robertgregor/private/Hardware/Documents/protocol.txt

USB stick

AT+c=ch<ENTER> - ch - channel number 1 - 83
AT+p=ABCDE<ENTER> - ABCDE - password exactly 5 characters
AT+a=nnn<ENTER> - add new device device id nnn = 1 - 255
AT+ddd=Cmd - specific device command ddd = device Id, Cmd = command

Light/Alarm controller

ala - alarm On In this mode the senzor will notify the Computer one time about the intrusion
ald - alarm deactivation
alce=nnn - alarm configuration enter alarm timeout nnn = 0 to 255 seconds
alcl=nnn - alarm configuration leave alarm timeout nnn = 0 to 255 seconds

l1o - light 1 on
l1of - light 1 on and off after timeout period
l1f - light 1 off
l1co - configure light 1 to swith on when applied power
l1cf - configure light 1 to stay off when applied power
l1cd - configure light 1 to switch on when movement detected
l1cc - cancel light 1 to switch on when movement detected
l1ct=nnn - configure light 1 timeout nnn = 0 to 255 minutes (0 means forewer) minutes
pn - check weather the device is up and runing (ping command)
sa - return status 1|a|Alarm|sensor|alenter|alleave
	Alarm 0 disabled, 1 enabled, 2 activated, 3 leave timeout running, 4 enter timeout running
	sensor - 0 nothing detected, 1 detected
	alenter - enter alarm timeout in seconds
	alleave - leave alarm timeout in seconds
sc - return status 1|c|light|power|onWhenMovement|configuredTimeout|currentTimeout
	light 0 off, 1 on
	power 0 on when applied power, 1 stay off when applied power
	onWhenMovement 1 - on when movement detected 0 no action
	configuredTimeout - no of minutes, when l1 will go off, 0 forewer
	currentTimeout - current light 1 timeout in minutes, 0 - never switch off

Temperature sensor

pn - check weather the device is up and runing (ping command)
s - return status 2|temperature|battery|frequency
	temperature format - always sign, 2 decimals degree celsius, dot, 2 decimals, e.g +23.32 or -02.32 or +02.20
	battery voltage e.g. 2.9 or 3.0
	frequency - frequency in seconds to send status. Longer value, longer battery life
m=nnn - set the frequency and put to the sleep mode. 1 means 10 seconds, 255 means 2550 seconds. Needs to be set to put the device to sleep mode!!!
	If not set, or set to 0, then no sleep - usefull for testing, but consume lot of power and batery will be quicly empty.

If in sleep mode, the command should be send within 2 seconds, after the status is send. Othervise the system is in sleep mode
and radio is off.

Simple switch

pn - check weather the device is up and runing (ping command)
l1o - light 1 on
l1of - light 1 on and off after timeout period
l1f - light 1 off
l1co - configure light 1 to swith on when applied power
l1cf - configure light 1 to stay off when applied power
l1ct=nnn - configure light 1 timeout nnn = 0 to 255 minutes (0 means forewer) minutes
s1 - return status 3|light|power|configuredTimeout|currentTimeout
	light 0 off, 1 on
	power 0 on when applied power, 1 stay off when applied power	
	configuredTimeout - no of minutes, when l1 will go off, 0 forewer
	currentTimeout - current light 1 timeout in minutes, 0 - never switch off

6x Simple switch

pn - check weather the device is up and runing (ping command)
lxo - light 1 on
lxof - light 1 on and off after timeout period
lxf - light 1 off
lxco - configure light 1 to swith on when applied power
lxcf - configure light 1 to stay off when applied power
lxct=nnn - configure light 1 timeout nnn = 0 to 255 minutes (0 means forewer) minutes
sx - return status 3|light|power|configuredTimeout|currentTimeout
	light 0 off, 1 on
	power 0 on when applied power, 1 stay off when applied power	
	configuredTimeout - no of minutes, when l1 will go off, 0 forewer
	currentTimeout - current light 1 timeout in minutes, 0 - never switch off

x = number 1 - 6

Heating header

pn - check weather the device is up and runing (ping command)
ad - adaptation of the header. Each valve has different ranges of the open / close borders. This command will measure the time between the close / open and
    adapt the header to the valve. It needs to be run at the begining and then each two weeks.
s - return status 4|temperature|battery|frequency|expected temperature|openAngle
	temperature format - 3 decimals degree celsius, e.g 233 = 23.3 or -23 = -23 or 022 = 2.2
	battery voltage e.g. 29 = 2.9 or 30 3.0. Below 2.8, the hardware starts to work not correctly.
	frequency - frequency in seconds to send status. Longer value, longer battery life
	expected temperature - the value set with command t: 23.5 celsius = 47, or 17 celsius = 34
	openAngle - Current open angle in % 100 - means close, 0 means fully open
m=nnn - set the frequency and put to the sleep mode. 1 means 10 seconds, 255 means 2550 seconds. Needs to be set to put the device to sleep mode!!!
	If not set, or set to 0, then no sleep - usefull for testing and configuration, but consume lot of power and batery will be quicly empty.
t=nnn - Expected temperature - if set, the header is running in self managed mode - each frequency period checks the current temperature, and if it is lower, open the
    valve and then sleep another period. The value is temperature * 2, it means, that 23.5 celsius = 47, or 17 celsius = 34.
    If it is set to 0, then valve is operated manually: each frequency period the valve send status, then you have 2 seconds to send l command to set the open angle of the valve.
l=nnn Set manually the valve to expected position allowed range is 100 closed, 0 fully open.

    Asynchronous messages: As - adaptation start, Ae - adaptation end, l|nnn after the valve is moved to correct position, the actual current position is sent. 
        
    Quick startup:
    1. Insert battery
    2. Test the communication AT+0=pn<ENTER>
    3. Assign the device ID: AT+a=9<ENTER>  Id is 9. Adaptation start. As is printed after while Ae is printed with the Valve position 100 - fully closed
    
    Self managed mode                                                                       Manual mode
    4. AT+9=t=45<ENTER> set temperature in room to 22,5 celsius                             AT+9=t=0<ENTER> manual mode, temperature is 0
    5. AT+9=m=60<ENTER>    sleep 10 minutes                                                   AT+9=m=60<ENTER>    sleep 10 minutes
    After 10 minutes the status is sent, you have to answer after the valve is set l|100    After 10 minutes the status is sent, sent back the new position
    6. AT+9=t=34<ENTER> Lower the temperature for the night                                   AT+9=l=50<ENTER> Opened 50 percent.

Blinds controller

pn - check weather the device is up and runing (ping command)
s - return status 5|down|up|timeout value|current opening
	down - 1 if currently moving down
	up - 1 if currently moving up
	timeout value - number of configured timeout in sec. This value is the 100 % time to open the blinds
	current opening - Blinds opening in %. 0 means fully open, 100 means fully closed. In manual mode always 0.

Position managed mode:

bt=nnn - configure number of seconds, when the blind is moving fully from open position to closed position.
bu - blinds up moving to fully open position
bd - blinds down moving to fully closed position
bs - blinds stop stop movements
bm=nnn - Move to the nnn position. nnn is the percentage between open and close. 0 - fully open, 100 - fully closed

Asynchronous messages: l|nnn percentage of opening.

Manual mode:

u - start to move up
d - start to move down
e - stop to move

3x Blinds controller

pn - check weather the device is up and runing (ping command)
sx - return status 5|down|up|timeout value|current opening
	down - 1 if currently moving down
	up - 1 if currently moving up
	timeout value - number of configured timeout in sec. This value is the 100 % time to open the blinds
	current opening - Blinds opening in %. 0 means fully open, 100 means fully closed. In manual mode always 0.

Position managed mode:

bxt=nnn - configure number of seconds, when the blind is moving fully from open position to closed position.
bxu - blinds up moving to fully open position
bxd - blinds down moving to fully closed position
bxs - blinds stop stop movements
bxm=nnn - Move to the nnn position. nnn is the percentage between open and close. 0 - fully open, 100 - fully closed

Asynchronous messages: l|nnn|X percentage of opening: nnn

Manual mode:

ux - start to move up
dx - start to move down
ex - stop to move

x = number 1 - 3

Battery thermostat

pn - check weather the device is up and runing (ping command)
o - Switch on the relay
f - Switch off the relay
s - return status 7|temperature|battery|frequency|expected temperature|relay|treshold
	temperature format - 3 decimals degree celsius, e.g 233 = 23.3 or -23 = -23 or 022 = 2.2
	battery voltage e.g. 29 = 2.9 or 30 3.0. Below 2.8, the hardware starts to work not correctly.
	frequency - frequency in seconds to send status. Longer value, longer battery life
	expected temperature - the value set with command t: 23.5 celsius = 47, or 17 celsius = 34
	relay - Current state of the relay 0 - off, 1 on
	treshold - Current treshold 0 - 9
m=nnn - set the frequency and put to the sleep mode. 1 means 10 seconds, 255 means 2550 seconds. Needs to be set to put the device to sleep mode!!!
	If not set, or set to 0, then no sleep - usefull for testing and configuration, but consume lot of power and batery will be quicly empty.
t=nnn - Expected temperature - if set, the header is running in self managed mode - each frequency period checks the current temperature, and if it is lower, open the
    valve and then sleep another period. The value is temperature * 2, it means, that 23.5 celsius = 47, or 17 celsius = 34.
    If it is set to 0, then relay is operated manually: each frequency period the relay send status, then you have 2 seconds to send l command to set the open angle of the valve.
r=n  -  Treshhold 0 - 9. For the self managed mode, the treshhold could be set. It means that relay will go off when currentTemperature + treshold / 10 > expected temperature and will
	go on, when currentTemperature - treshold / 10 < expected temperature

    Quick startup:
    1. Insert battery
    2. Test the communication AT+0=pn<ENTER>
    3. Assign the device ID: AT+a=9<ENTER>  Id is 9.
    
    Self managed mode                                                                       Manual mode
    4. AT+9=t=45<ENTER> set temperature in room to 22,5 celsius
    5. AT+9=r=5<ENTER> set treshold to 0,5 degree celsius                                   AT+9=t=0<ENTER> manual mode, temperature is 0
    6. AT+9=m=60<ENTER>    sleep 10 minutes                                                 AT+9=m=60<ENTER>    sleep 10 minutes
    After 10 minutes the status is sent, you have to answer till 2 seconds		    After 10 minutes the status is sent, sent back the position of the relay
    7. AT+9=t=34<ENTER> Lower the temperature for the night                                 AT+9=o<ENTER> Swith relay on

Manual mode:
o - start to move up
f - start to move down

Thermostat

pn - check weather the device is up and runing (ping command)
o - Switch on the relay
f - Switch off the relay
s - return status 6|temperature|frequency|expected temperature|relay|treshold|manualControl
	temperature format - 3 decimals degree celsius, e.g 233 = 23.3 or -23 = -23 or 022 = 2.2
	frequency - frequency in seconds to send status. Longer value, longer battery life
	expected temperature - the value set with command t: 23.5 celsius = 47, or 17 celsius = 34
	relay - Current state of the relay 0 - off, 1 on
	treshold - Current treshold 0 - 9
	manualControl - in this mode, the relay is operated only with commands x and y it means on and off. Expected temperature doesnt have any effect.
m=nnn - set the frequency of the notifications and relay changes. 1 means 10 seconds, 255 means 2550 seconds.
	If not set, or set to 0, then no relay changes - Manual mode
t=nnn - Expected temperature - if set, the header is running in self managed mode - each frequency period checks            the current temperature, and if it is lower, switch on the
    	relay. The value is temperature * 2, it means, that 23.5 celsius = 47, or 17 celsius = 34.
	If it is set to 0, then relay is operated manually.
r=n  -  Threshold 0 - 9. For the self managed mode, the treshhold could be set. It means that relay will go off             when currentTemperature + treshold / 10 > expected temperature and will
	go on, when currentTemperature - threshold / 10 < expected temperature
x - Set manual control on
y - Set manual control off
        
    Quick startup:
    1. Put the power
    2. Test the communication AT+0=pn<ENTER>
    3. Assign the device ID: AT+a=9<ENTER>  Id is 9.
    
    Self managed mode                                                                       Manual mode
    4. AT+9=t=45<ENTER> set temperature in room to 22,5 celsius
    5. AT+9=r=5<ENTER> set treshold to 0,5 degree celsius                                   AT+9=t=0<ENTER> manual mode, temperature is 0
    6. AT+9=m=60<ENTER>    wait 10 minutes                                                  AT+9=m=60<ENTER>    sleep 10 minutes
    After 10 minutes the status is sent	again						    After 10 minutes the status is sent
    7. AT+9=t=34<ENTER> Lower the temperature for the night                                 AT+9=o<ENTER> Swith relay on if necessary

raspberry setup:

Edit /boot/cmdline.txt

From:
dwc_otg.lpm_enable=0 rpitestmode=1 console=ttyAMA0,115200 kgdboc=ttyAMA0,115200 console=tty1 root=/dev/mmcblk0p2 rootfstype=ext4 rootwait
to:
dwc_otg.lpm_enable=0 rpitestmode=1 console=tty1 root=/dev/mmcblk0p2 rootfstype=ext4 rootwait

Edit /etc/innitab 
comment out:
2:23:respawn:/sbin/getty -L ttyAMA0 115200 vt100
