robertgregor/private/DOCS/vizitky/vizitka_generic.PDF

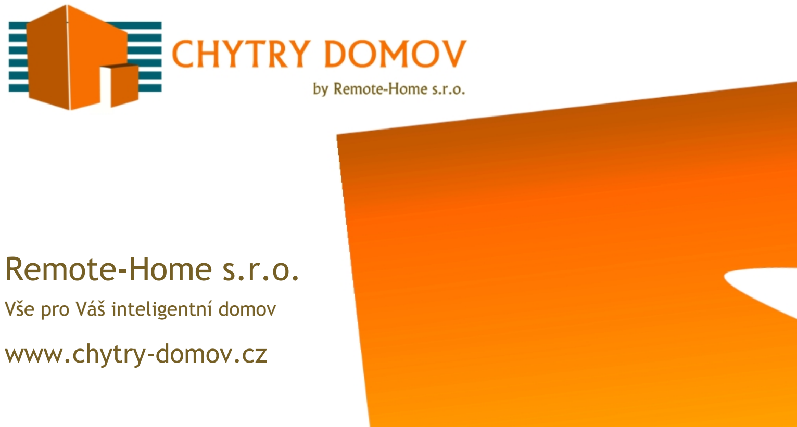
[picture p1: page 1]

Remote-Home s.r.o.

Vše pro Váš inteligentní domov

## www.chytry-domov.cz
