robertgregor/private/DOCS/vizitky/vizitka_dr.pdf

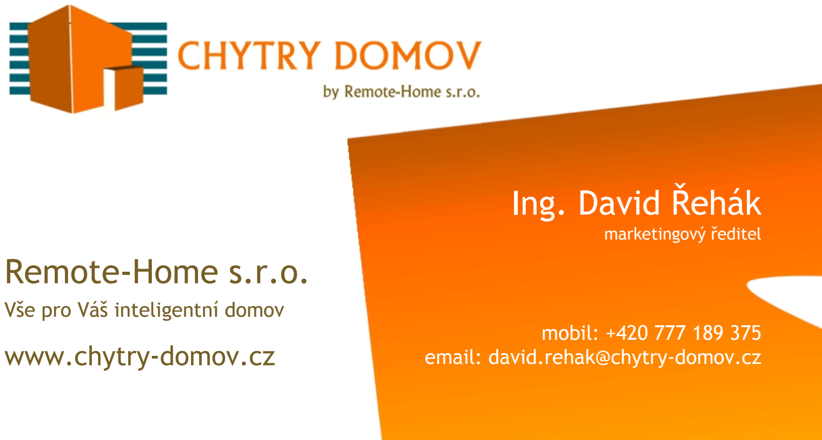
[picture p2: page 1]

Remote-Home s.r.o.

Vše pro Váš inteligentní domov

## www.chytry-domov.cz

## Ing. David Řehák

marketingový ředitel

mobil: +420 777 189 375
email: david.rehak@chytry-domov.cz
