robertgregor/private/DOCS/vizitky/vizitka_rg.PDF

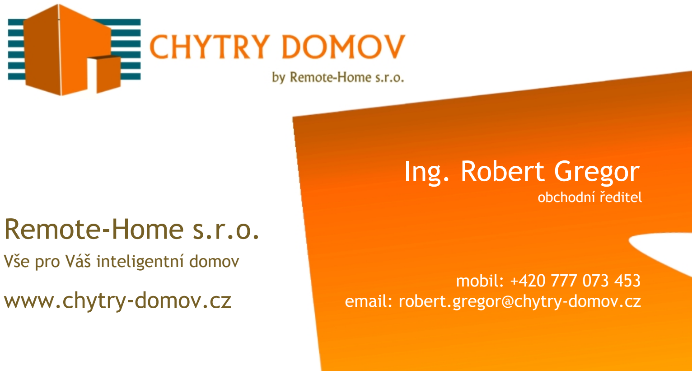
[picture p3: page 1]

Remote-Home s.r.o.

Vše pro Váš inteligentní domov

## www.chytry-domov.cz

## Ing. Robert Gregor obchodní ředitel

mobil: +420 777 073 453
email: robert.gregor@chytry-domov.cz
