robertgregor/private/DOCS/vizitky/vizitka_zh.PDF

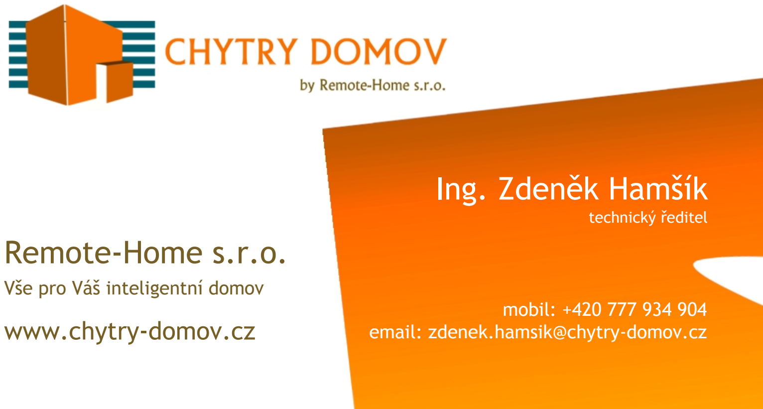
[picture p4: page 1]

Remote-Home s.r.o.

Vše pro Váš inteligentní domov

## www.chytry-domov.cz

## Ing. Zdeněk Hamšík

technický ředitel

mobil: +420 777 934 904
email: zdenek.hamsik@chytry-domov.cz
