robertgregor/private/Hardware/SchemasBoard/miniSpinac.brd

## EAGLE design Hardware/SchemasBoard/miniSpinac.brd (2014-12-24)

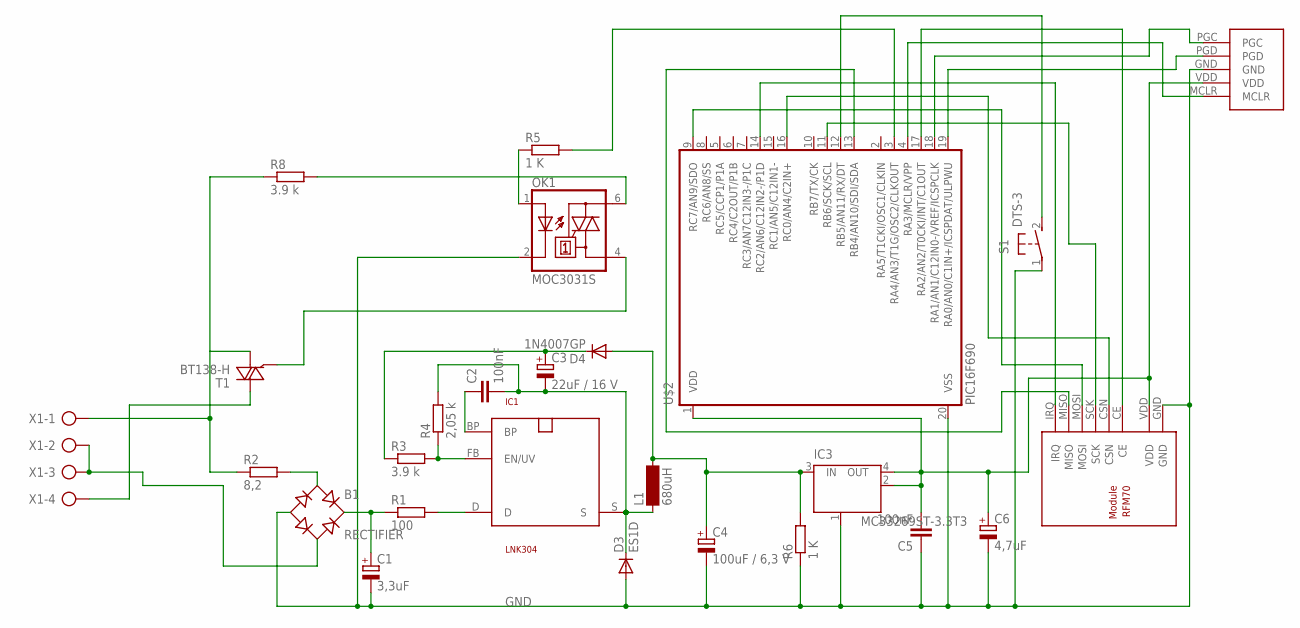
[picture p5: schematic miniSpinac.sch]

Parts:
B1: RECTIFIER; TO-269AA
C1: 3,3uF; E5-10,5
C2, C5: 100nF; C2012
C3: 22uF / 16 V; SMC_C
C4: 100uF / 6,3 V; E2,5-5
C6: 4,7uF; SMC_A
D3: ES1D; DO214AC
D4: 1N4007GP; DO214AA
IC1: LNK304; SO-8C
IC3: MC33269ST-3.3T3; SOT223
L1: 680uH; BS11
OK1: MOC3031S; DIL6-SMD
R1: 100; R2512W
R2: 8,2; 0411/12
R3, R8: 3.9 k; M2012
R4: 2,05 k; M2012
R5, R6: 1 K; M2012
S1: DTS-3
T1: BT138-H; TO220BH
U$1: RFM70
U$2: PIC16F690; SSOP20
U$3: PROGRAMMINGHEADERDIP; PROGHEADER
X1: AK500/4

Connections:
GND: B1.-, C1.-, C4.-, C5.1, C6.-, D3.A, IC3.1 (GND/ADJ), OK1.2 (C), R6.1, S1.1, U$1.GND, U$2.20 (VSS), U$3.GND
unnamed: IC1.D, R1.2
unnamed: B1.+, C1.+, R1.1
unnamed: B1.AC1, R2.2
unnamed: B1.AC2, X1.2, X1.3
unnamed: S1.2, U$2.12 (RB5/AN11/RX/DT)
unnamed: T1.T2 (A2), X1.4
unnamed: OK1.1 (A), R5.1
unnamed: OK1.4 (A1), T1.G
unnamed: C3.+, D4.C, R3.1
unnamed: C2.1, IC1.BP
unnamed: IC1.FB (EN/UV), R3.2, R4.1
unnamed: U$1.MISO, U$2.13 (RB4/AN10/SDI/SDA)
unnamed: C2.2, C3.-, D3.C, IC1.S, L1.1, R4.2
unnamed: OK1.6 (A2), R8.2
unnamed: U$1.CE, U$2.17 (RA2/AN2/T0CKI/INT/C1OUT)
unnamed: U$2.19 (RA0/AN0/C1IN+/ICSPDAT/ULPWU), U$3.PGD
unnamed: U$2.18 (RA1/AN1/C12IN0-/VREF/ICSPCLK), U$3.PGC
unnamed: U$1.CSN, U$2.16 (RC0/AN4/C2IN+)
unnamed: U$1.IRQ, U$2.14 (RC2/AN6/C12IN2-/P1D)
unnamed: U$1.SCK, U$2.11 (RB6/SCK/SCL)
unnamed: U$1.MOSI, U$2.9 (RC7/AN9/SDO)
unnamed: U$2.4 (RA3/MCLR/VPP), U$3.MCLR
unnamed: C4.+, D4.A, IC3.3 (IN), L1.2, R6.2
unnamed: C5.2, C6.+, IC3.2 (OUT), IC3.4 (OUT), U$1.VDD, U$2.1 (VDD), U$3.VDD
unnamed: R5.2, U$2.3 (RA4/AN3/T1G/OSC2/CLKOUT)
unnamed: R2.1, R8.1, T1.T1 (A1), X1.1

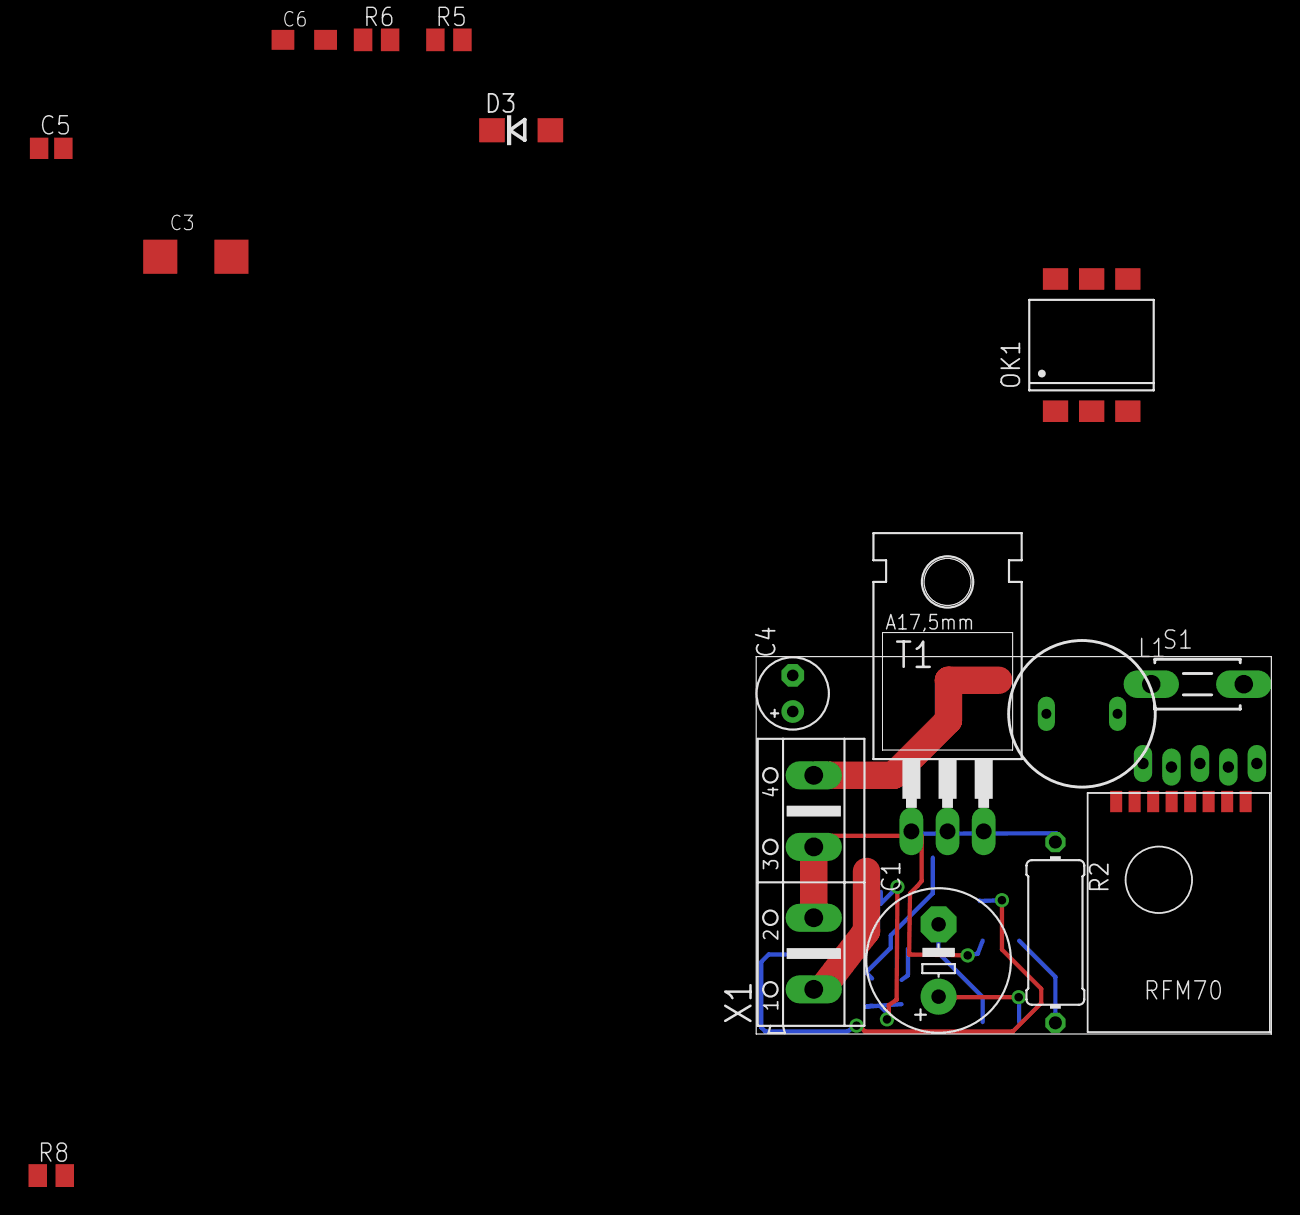
[picture p6: board miniSpinac.brd from above]

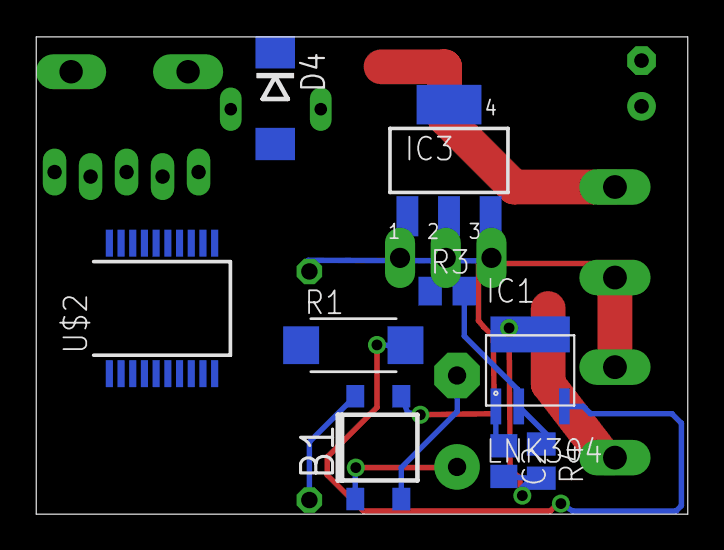
[picture p7: board miniSpinac.brd from below]

Board: 2 copper layers, 36.2 x 26.5 mm, 26 parts (9 on the bottom side), 27 nets.
