robertgregor/private/Hardware/Ardunio/eagle/Transceiver.brd

## EAGLE design Hardware/Ardunio/eagle/Transceiver.brd (2014-12-24)

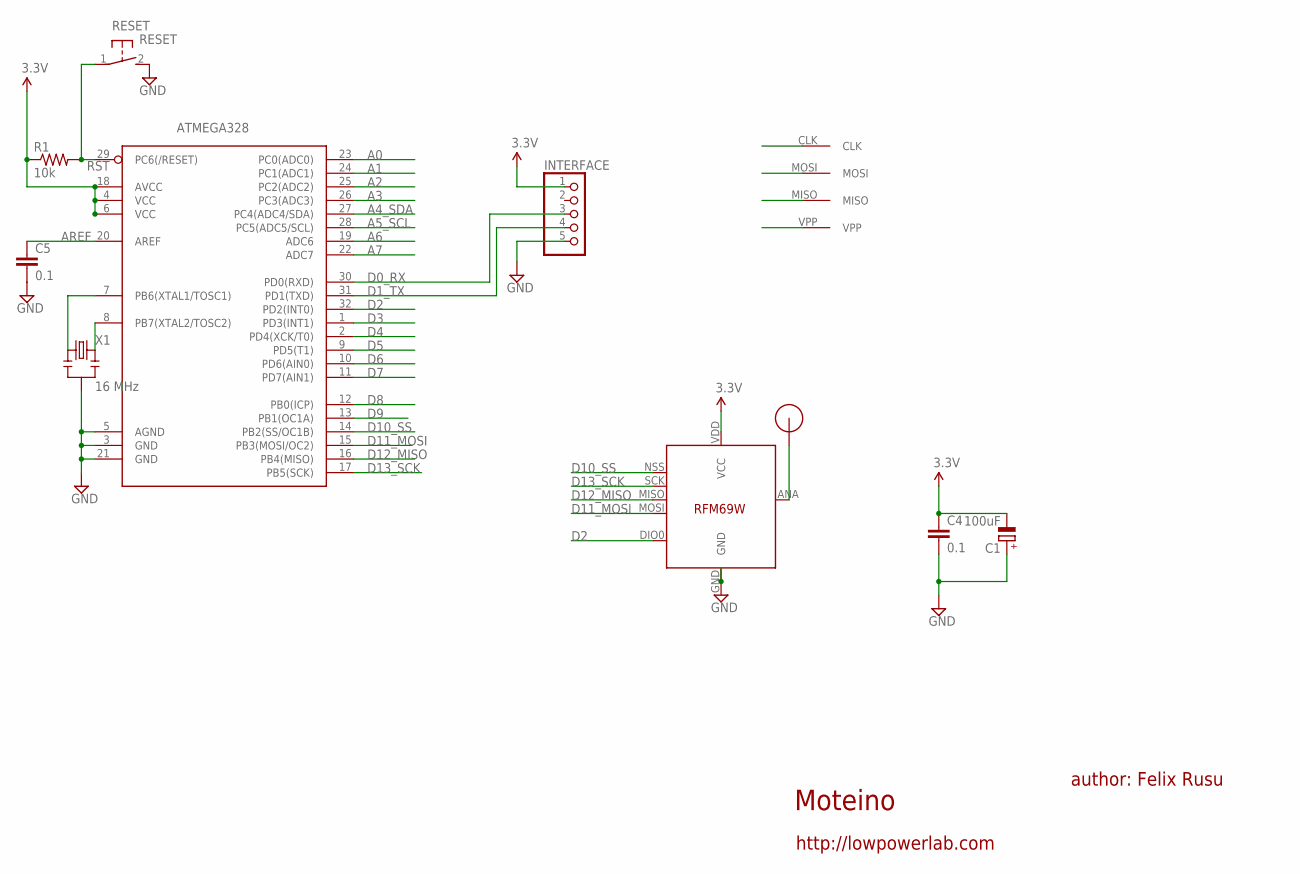
[picture p8: schematic Transceiver.sch]

Parts:
ATMEGA328: ATMega-328; TQFP32-08
C1: 100uF; SMC_B
C4, C5: 0.1; 0603-CAP
INTERFACE: PINHD-1X5/90; 1X05/90
R1: 10k; 0603-RES
RESET: RESET; DTSM-3
U$1: RFM12B_ANTENNA; RFM12B-ANTENNA
U$2: AVRHEADERDIP; AVRHEADER
U$5: RFM69; RFM69W-MINPADS
X1: 16 MHz; RESONATOR-SMD

Connections:
A0: ATMEGA328.23 (PC0(ADC0))
A1: ATMEGA328.24 (PC1(ADC1))
A2: ATMEGA328.25 (PC2(ADC2))
A3: ATMEGA328.26 (PC3(ADC3))
A4_SDA: ATMEGA328.27 (PC4(ADC4/SDA))
A5_SCL: ATMEGA328.28 (PC5(ADC5/SCL))
A6: ATMEGA328.19 (ADC6)
A7: ATMEGA328.22 (ADC7)
AREF: ATMEGA328.20 (AREF), C5.1
D0_RX: ATMEGA328.30 (PD0(RXD)), INTERFACE.3
D1_TX: ATMEGA328.31 (PD1(TXD)), INTERFACE.4
D2: ATMEGA328.32 (PD2(INT0)), U$5.DIO0
D3: ATMEGA328.1 (PD3(INT1))
D4: ATMEGA328.2 (PD4(XCK/T0))
D5: ATMEGA328.9 (PD5(T1))
D6: ATMEGA328.10 (PD6(AIN0))
D7: ATMEGA328.11 (PD7(AIN1))
D8: ATMEGA328.12 (PB0(ICP))
D9: ATMEGA328.13 (PB1(OC1A))
D10_SS: ATMEGA328.14 (PB2(SS/OC1B)), U$5.NSS (SEL)
D11_MOSI: ATMEGA328.15 (PB3(MOSI/OC2)), U$2.MOSI, U$5.MOSI
D12_MISO: ATMEGA328.16 (PB4(MISO)), U$2.MISO, U$5.MISO
D13_SCK: ATMEGA328.17 (PB5(SCK)), U$2.CLK, U$5.SCK
GND: ATMEGA328.3 (GND), ATMEGA328.5 (AGND), ATMEGA328.21 (GND), C1.+, C4.2, C5.2, INTERFACE.5, RESET.2, U$5.GND, X1.2
unnamed: ATMEGA328.7 (PB6(XTAL1/TOSC1)), X1.1
unnamed: U$1.P$1, U$5.ANA (ANT)
unnamed: ATMEGA328.8 (PB7(XTAL2/TOSC2)), X1.3
RST: ATMEGA328.29 (PC6(/RESET)), R1.2, RESET.1, U$2.VPP
VCC: ATMEGA328.4 (VCC), ATMEGA328.6 (VCC), ATMEGA328.18 (AVCC), C1.-, C4.1, INTERFACE.1, R1.1, U$5.VDD (VCC)

Notes on the sheet:
Moteino
author: Felix Rusu
http://lowpowerlab.com

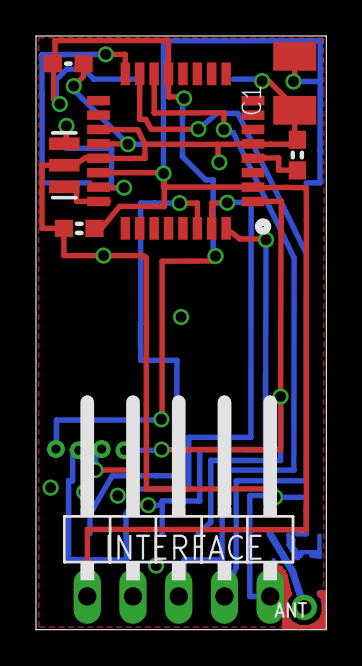
[picture p9: board Transceiver.brd from above]

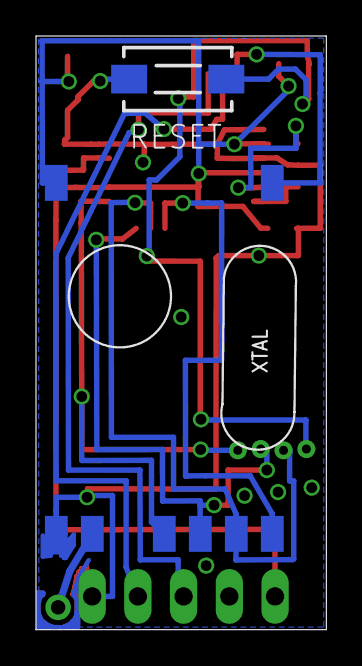
[picture p10: board Transceiver.brd from below]

Board: 2 copper layers, 16.1 x 33.0 mm, 11 parts (2 on the bottom side), 14 nets.
