robertgregor/private/Hardware/Ardunio/eagle/sensorAA.brd

## EAGLE design Hardware/Ardunio/eagle/sensorAA.brd (2014-12-24)

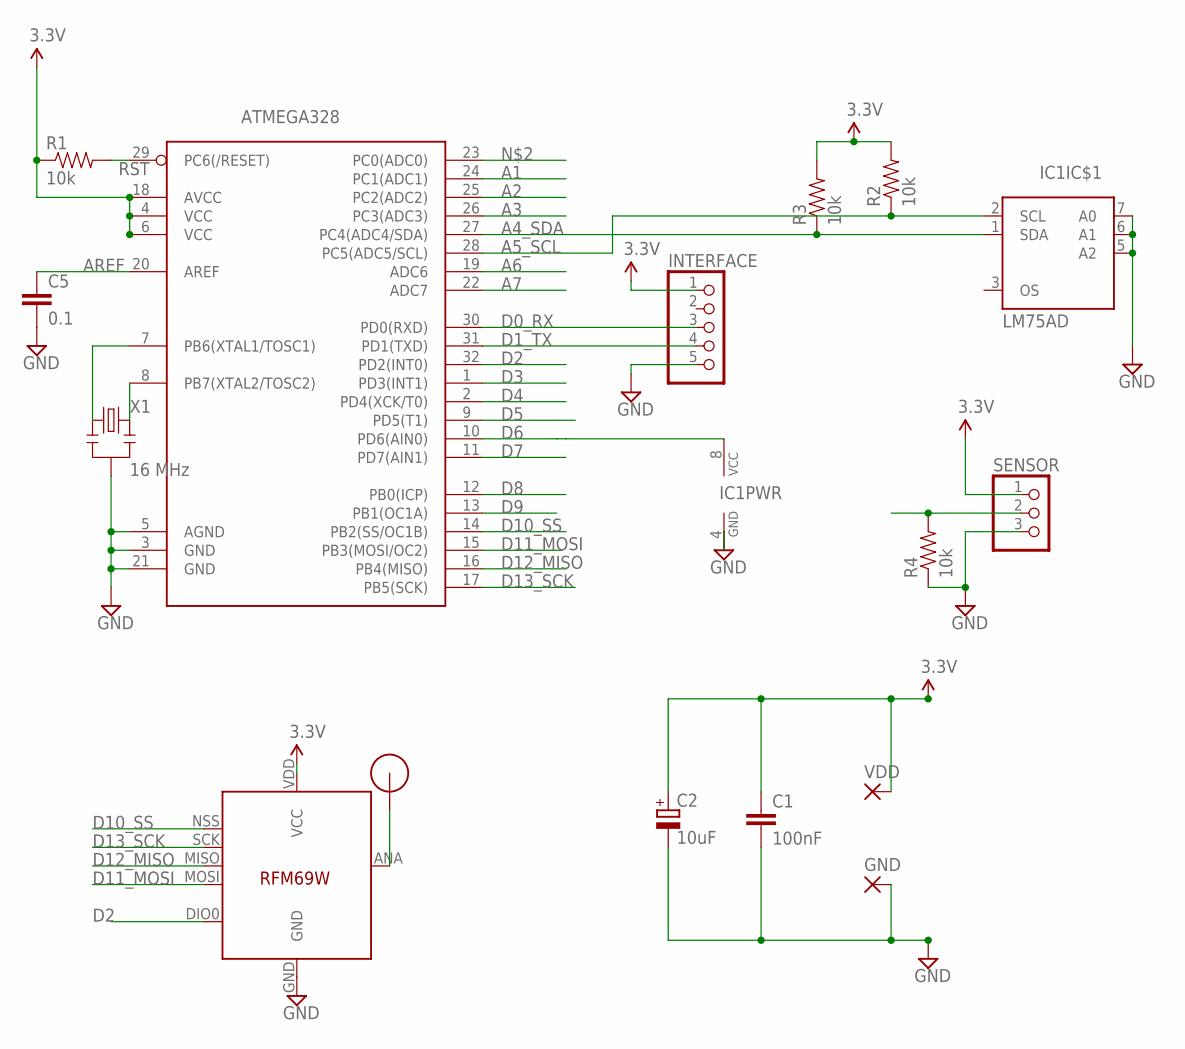
[picture p11: schematic sensorAA.sch]

Parts:
ATMEGA328: ATMega-328; TQFP32-08
C1: 100nF; C2012
C2: 10uF; SMC_A
C5: 0.1; 0603-CAP
GND: SMD5; SMD2,54-5,08
IC1: LM75AD; SO08
IC4: RFM69; RFM69W-MINPADS
INTERFACE: PINHD-1X5; 1X05
R1, R2, R3, R4: 10k; 0603-RES
SENSOR: PINHD-1X3; 1X03
U$1: RFM12B_ANTENNA; RFM12B-ANTENNA
VDD: SMD5; SMD2,54-5,08
X1: 16 MHz; RESONATOR-SMD

Connections:
A1: ATMEGA328.24 (PC1(ADC1))
A2: ATMEGA328.25 (PC2(ADC2))
A3: ATMEGA328.26 (PC3(ADC3))
A4_SDA: ATMEGA328.27 (PC4(ADC4/SDA)), IC1.1 (SDA), R3.1
A5_SCL: ATMEGA328.28 (PC5(ADC5/SCL)), IC1.2 (SCL), R2.1
A6: ATMEGA328.19 (ADC6)
A7: ATMEGA328.22 (ADC7)
AREF: ATMEGA328.20 (AREF), C5.1
D0_RX: ATMEGA328.30 (PD0(RXD)), INTERFACE.3
D1_TX: ATMEGA328.31 (PD1(TXD)), INTERFACE.4
D2: ATMEGA328.32 (PD2(INT0)), IC4.DIO0
D3: ATMEGA328.1 (PD3(INT1)), R4.2, SENSOR.2
D4: ATMEGA328.2 (PD4(XCK/T0))
D5: ATMEGA328.9 (PD5(T1))
D6: ATMEGA328.10 (PD6(AIN0)), IC1.8 (VCC)
D7: ATMEGA328.11 (PD7(AIN1))
D8: ATMEGA328.12 (PB0(ICP))
D9: ATMEGA328.13 (PB1(OC1A))
D10_SS: ATMEGA328.14 (PB2(SS/OC1B)), IC4.NSS (SEL)
D11_MOSI: ATMEGA328.15 (PB3(MOSI/OC2)), IC4.MOSI
D12_MISO: ATMEGA328.16 (PB4(MISO)), IC4.MISO
D13_SCK: ATMEGA328.17 (PB5(SCK)), IC4.SCK
GND: ATMEGA328.3 (GND), ATMEGA328.5 (AGND), ATMEGA328.21 (GND), C1.2, C2.-, C5.2, GND.1, IC1.4 (GND), IC1.5 (A2), IC1.6 (A1), IC1.7 (A0), IC4.GND, INTERFACE.5, R4.1, SENSOR.3, X1.2
unnamed: ATMEGA328.7 (PB6(XTAL1/TOSC1)), X1.1
unnamed: IC4.ANA (ANT), U$1.P$1
unnamed: ATMEGA328.8 (PB7(XTAL2/TOSC2)), X1.3
RST: ATMEGA328.29 (PC6(/RESET)), R1.2
VCC: ATMEGA328.4 (VCC), ATMEGA328.6 (VCC), ATMEGA328.18 (AVCC), C1.1, C2.+, IC4.VDD (VCC), INTERFACE.1, R1.1, R2.2, R3.2, SENSOR.1, VDD.1

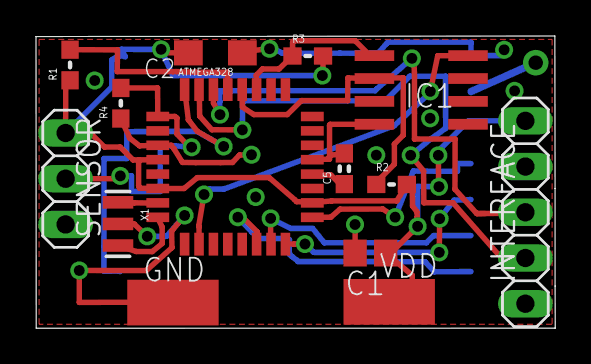
[picture p12: board sensorAA.brd from above]

Board: 2 copper layers, 28.8 x 16.2 mm, 16 parts (1 on the bottom side), 18 nets.
