robertgregor/private/Hardware/Ardunio/eagle/8RelaySwitch.brd

## EAGLE design Hardware/Ardunio/eagle/8RelaySwitch.brd (2014-12-24)

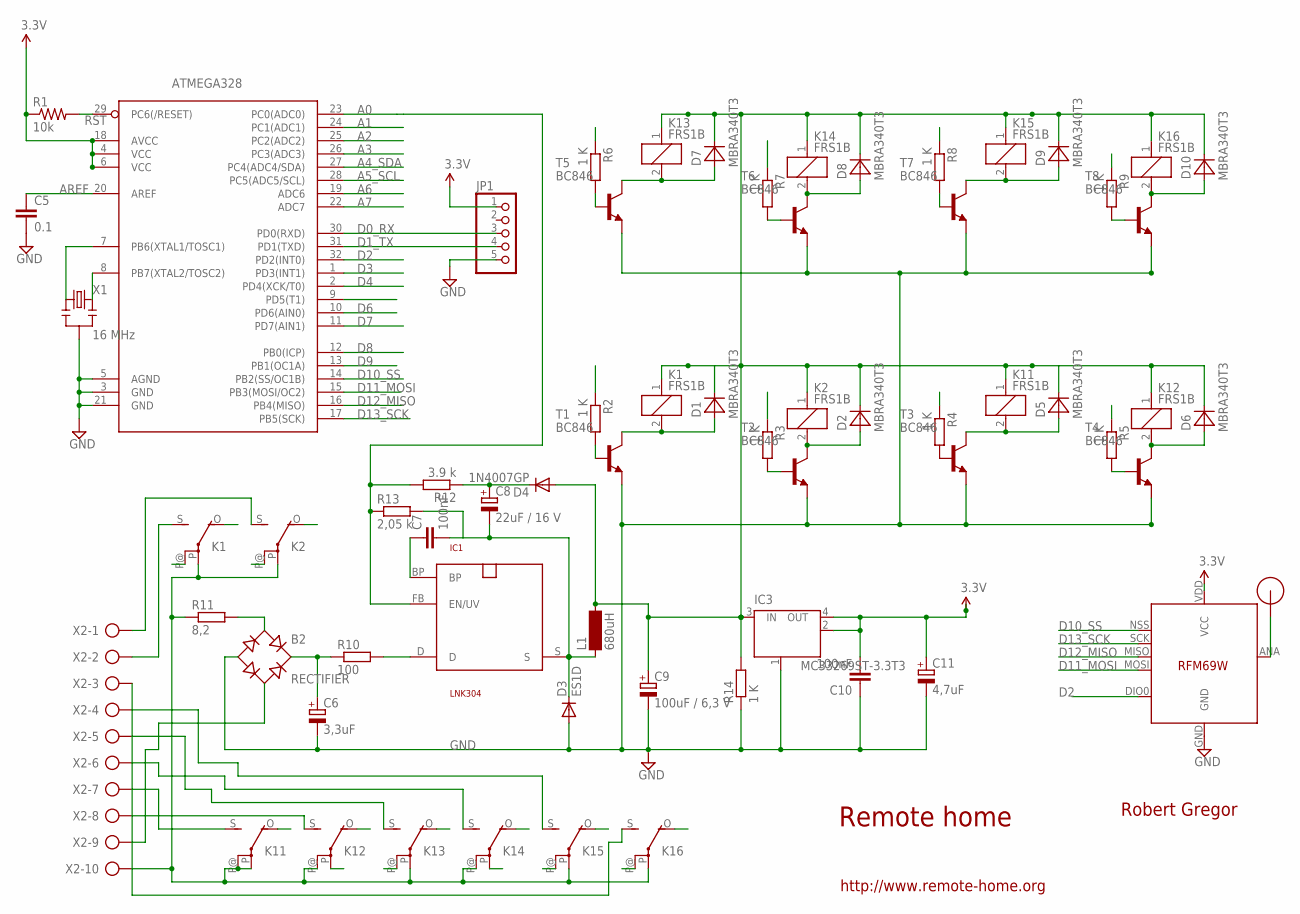
[picture p13: schematic 8RelaySwitch.sch]

Parts:
ATMEGA328: ATMega-328; TQFP32-08
B2: RECTIFIER; TO-269AA
C5: 0.1; 0603-CAP
C6: 3,3uF; E5-10,5
C7, C10: 100nF; C2012
C8: 22uF / 16 V; SMC_C
C9: 100uF / 6,3 V; E2,5-5
C11: 4,7uF; SMC_A
D1, D2, D5, D6, D7, D8, D9, D10: MBRA340T3; SMA
D3: ES1D; DO214AC
D4: 1N4007GP; DO214AA
IC1: LNK304; SO-8C
IC3: MC33269ST-3.3T3; SOT223
JP1: PINHD-1X5; 1X05
K1, K2, K11, K12, K13, K14, K15, K16: FRS1B
L1: 680uH; BS11
R1: 10k; 0603-RES
R2, R3, R4, R5, R6, R7, R8, R9, R14: 1 K; M2012
R10: 100; R2512W
R11: 8,2; 0411/12
R12: 3.9 k; M2012
R13: 2,05 k; M2012
T1, T2, T3, T4, T5, T6, T7, T8: BC846; SOT23
U$1: RFM12B_ANTENNA; RFM12B-ANTENNA
U$5: RFM69; RFM69W-MINPADS
X1: 16 MHz; RESONATOR-SMD
X2: AK500/10

Connections:
5V1: C9.+, D1.C, D2.C, D4.A, D5.C, D6.C, D7.C, D8.C, D9.C, D10.C, IC3.3 (IN), K1.1, K2.1, K11.1, K12.1, K13.1, K14.1, K15.1, K16.1, L1.2, R14.2
A0: ATMEGA328.23 (PC0(ADC0)), IC1.FB (EN/UV), R12.2, R13.1
A1: ATMEGA328.24 (PC1(ADC1)), R6.1
A2: ATMEGA328.25 (PC2(ADC2))
A3: ATMEGA328.26 (PC3(ADC3))
A4_SDA: ATMEGA328.27 (PC4(ADC4/SDA))
A5_SCL: ATMEGA328.28 (PC5(ADC5/SCL))
A6: ATMEGA328.19 (ADC6)
A7: ATMEGA328.22 (ADC7)
AREF: ATMEGA328.20 (AREF), C5.1
D0_RX: ATMEGA328.30 (PD0(RXD)), JP1.3
D1_TX: ATMEGA328.31 (PD1(TXD)), JP1.4
D2: ATMEGA328.32 (PD2(INT0)), U$5.DIO0
D3: ATMEGA328.1 (PD3(INT1)), R7.1
D4: ATMEGA328.2 (PD4(XCK/T0)), R8.1
D5: ATMEGA328.9 (PD5(T1)), R2.1
D6: ATMEGA328.10 (PD6(AIN0)), R3.1
D7: ATMEGA328.11 (PD7(AIN1)), R4.1
D8: ATMEGA328.12 (PB0(ICP)), R5.1
D9: ATMEGA328.13 (PB1(OC1A)), R9.1
D10_SS: ATMEGA328.14 (PB2(SS/OC1B)), U$5.NSS (SEL)
D11_MOSI: ATMEGA328.15 (PB3(MOSI/OC2)), U$5.MOSI
D12_MISO: ATMEGA328.16 (PB4(MISO)), U$5.MISO
D13_SCK: ATMEGA328.17 (PB5(SCK)), U$5.SCK
GND: ATMEGA328.3 (GND), ATMEGA328.5 (AGND), ATMEGA328.21 (GND), B2.-, C5.2, C6.-, C9.-, C10.1, C11.-, D3.A, IC3.1 (GND/ADJ), JP1.5, R14.1, T1.2 (E), T2.2 (E), T3.2 (E), T4.2 (E), T5.2 (E), T6.2 (E), T7.2 (E), T8.2 (E), U$5.GND, X1.2
unnamed: ATMEGA328.7 (PB6(XTAL1/TOSC1)), X1.1
unnamed: R2.2, T1.1 (B)
unnamed: U$1.P$1, U$5.ANA (ANT)
unnamed: D2.A, K2.2, T2.3 (C)
unnamed: D1.A, K1.2, T1.3 (C)
unnamed: R3.2, T2.1 (B)
unnamed: K1.S, X2.2
unnamed: B2.AC2, X2.9
unnamed: C7.2, C8.-, D3.C, IC1.S, L1.1, R13.2
unnamed: IC1.D, R10.2
unnamed: B2.+, C6.+, R10.1
unnamed: B2.AC1, R11.2
unnamed: C7.1, IC1.BP
unnamed: C8.+, D4.C, R12.1
unnamed: ATMEGA328.8 (PB7(XTAL2/TOSC2)), X1.3
unnamed: D5.A, K11.2, T3.3 (C)
unnamed: R4.2, T3.1 (B)
unnamed: D6.A, K12.2, T4.3 (C)
unnamed: R5.2, T4.1 (B)
unnamed: D7.A, K13.2, T5.3 (C)
unnamed: R6.2, T5.1 (B)
unnamed: D8.A, K14.2, T6.3 (C)
unnamed: R7.2, T6.1 (B)
unnamed: D9.A, K15.2, T7.3 (C)
unnamed: R8.2, T7.1 (B)
unnamed: D10.A, K16.2, T8.3 (C)
unnamed: R9.2, T8.1 (B)
unnamed: K12.S, X2.8
unnamed: K11.S, X2.7
unnamed: K1.P, K2.P, K11.P, K11.P@, K12.P@, K13.P, K14.P@, K15.P, K16.P, R11.1, X2.10
unnamed: K16.S, X2.3
unnamed: K2.S, X2.1
unnamed: K13.S, X2.5
unnamed: K14.S, X2.6
unnamed: K15.S, X2.4
RST: ATMEGA328.29 (PC6(/RESET)), R1.2
VCC: ATMEGA328.4 (VCC), ATMEGA328.6 (VCC), ATMEGA328.18 (AVCC), C10.2, C11.+, IC3.2 (OUT), IC3.4 (OUT), JP1.1, R1.1, U$5.VDD (VCC)

Notes on the sheet:
Remote home
Robert Gregor
http://www.remote-home.org

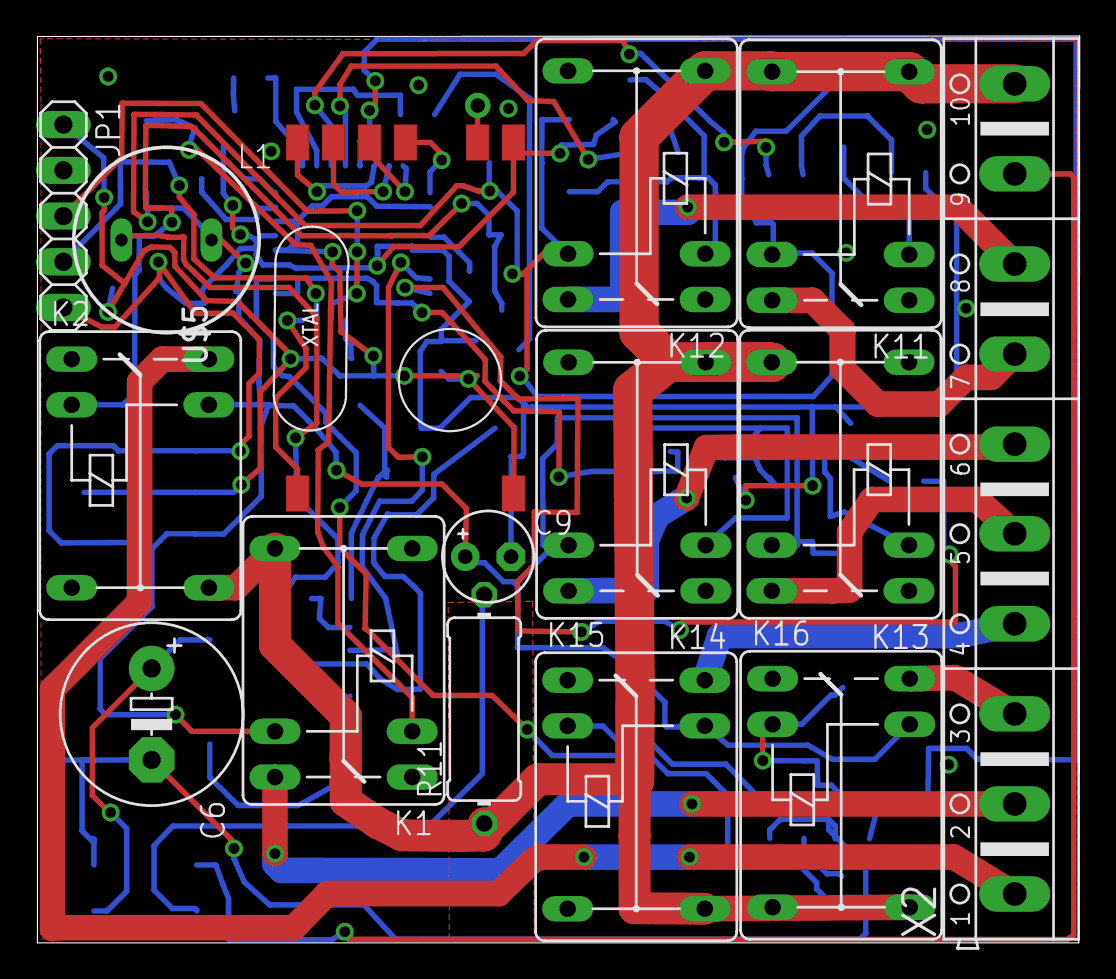
[picture p14: board 8RelaySwitch.brd from above]

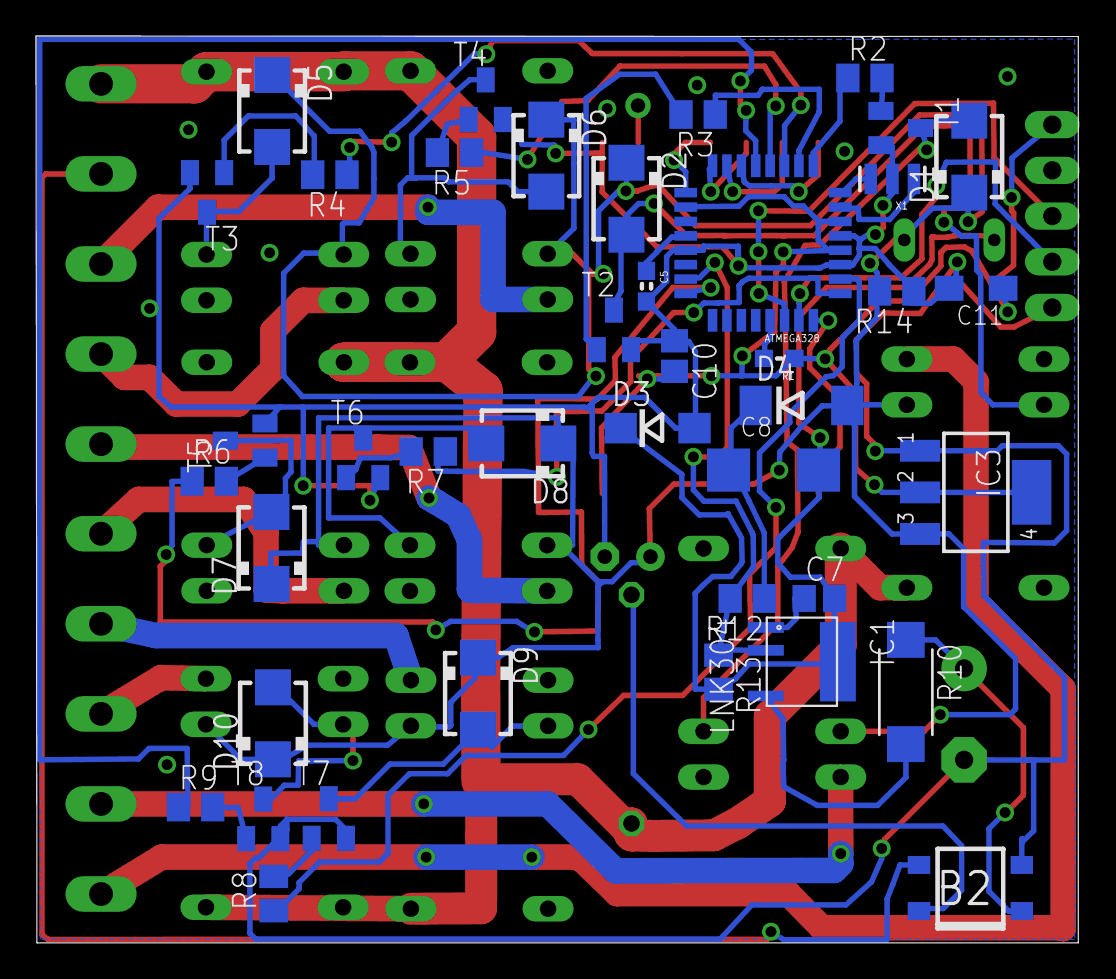
[picture p15: board 8RelaySwitch.brd from below]

Board: 2 copper layers, 57.9 x 50.4 mm, 57 parts (41 on the bottom side), 56 nets.
