robertgregor/private/Hardware/Ardunio/eagle/SimpleSwitch.brd

## EAGLE design Hardware/Ardunio/eagle/SimpleSwitch.brd (2014-12-24)

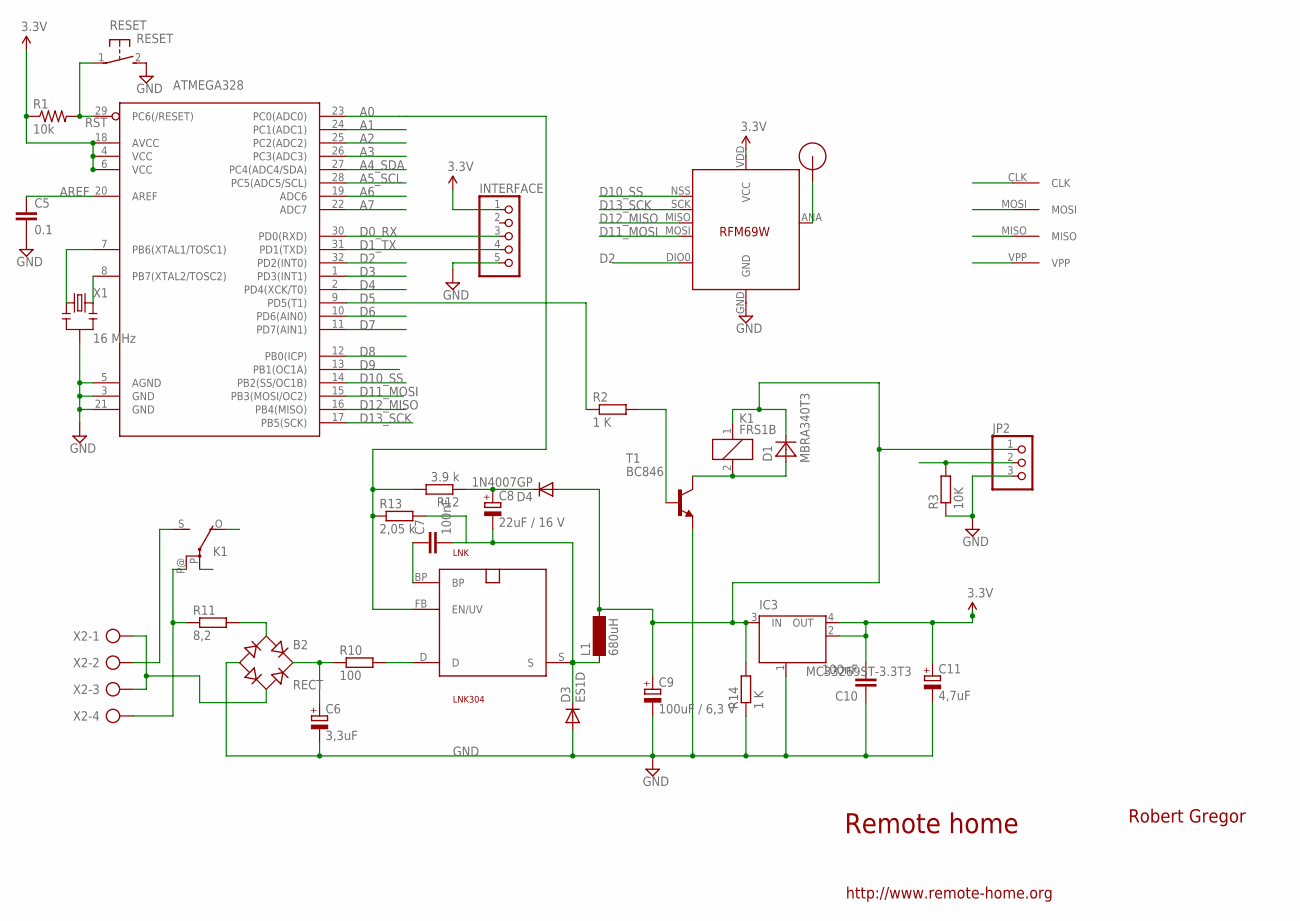
[picture p16: schematic SimpleSwitch.sch]

Parts:
ATMEGA328: ATMega-328; TQFP32-08
B2: RECT; TO-269AA
C5: 0.1; 0603-CAP
C6: 3,3uF; E5-10,5
C7, C10: 100nF; C2012
C8: 22uF / 16 V; SMC_C
C9: 100uF / 6,3 V; E2,5-5
C11: 4,7uF; SMC_A
D1: MBRA340T3; SMA
D3: ES1D; DO214AC
D4: 1N4007GP; DO214AA
IC3: MC33269ST-3.3T3; SOT223
INTERFACE: PINHD-1X5; 1X05
JP2: PINHD-1X3; 1X03
K1: FRS1B
L1: 680uH; BS11
LNK: LNK304; SO-8C
R1: 10k; 0603-RES
R2, R14: 1 K; M2012
R3: 10K; M2012
R10: 100; R2512W
R11: 8,2; 0411/12
R12: 3.9 k; M2012
R13: 2,05 k; M2012
RESET: RESET; DTSM-3
RFM69: RFM69; RFM69W-MINPADS
T1: BC846; SOT23
U$1: RFM12B_ANTENNA; RFM12B-ANTENNA
U$2: AVRHEADERDIP; AVRHEADER
X1: 16 MHz; RESONATOR-SMD
X2: AK500/4

Connections:
5V: C9.+, D1.C, D4.A, IC3.3 (IN), JP2.1, K1.1, L1.2, R14.2
A0: ATMEGA328.23 (PC0(ADC0)), LNK.FB (EN/UV), R12.2, R13.1
A1: ATMEGA328.24 (PC1(ADC1))
A2: ATMEGA328.25 (PC2(ADC2))
A3: ATMEGA328.26 (PC3(ADC3))
A4_SDA: ATMEGA328.27 (PC4(ADC4/SDA))
A5_SCL: ATMEGA328.28 (PC5(ADC5/SCL))
A6: ATMEGA328.19 (ADC6)
A7: ATMEGA328.22 (ADC7)
AREF: ATMEGA328.20 (AREF), C5.1
D0_RX: ATMEGA328.30 (PD0(RXD)), INTERFACE.3
D1_TX: ATMEGA328.31 (PD1(TXD)), INTERFACE.4
D2: ATMEGA328.32 (PD2(INT0)), RFM69.DIO0
D3: ATMEGA328.1 (PD3(INT1)), JP2.2, R3.2
D4: ATMEGA328.2 (PD4(XCK/T0))
D5: ATMEGA328.9 (PD5(T1)), R2.1
D6: ATMEGA328.10 (PD6(AIN0))
D7: ATMEGA328.11 (PD7(AIN1))
D8: ATMEGA328.12 (PB0(ICP))
D9: ATMEGA328.13 (PB1(OC1A))
D10_SS: ATMEGA328.14 (PB2(SS/OC1B)), RFM69.NSS (SEL)
D11_MOSI: ATMEGA328.15 (PB3(MOSI/OC2)), RFM69.MOSI, U$2.MOSI
D12_MISO: ATMEGA328.16 (PB4(MISO)), RFM69.MISO, U$2.MISO
D13_SCK: ATMEGA328.17 (PB5(SCK)), RFM69.SCK, U$2.CLK
GND: ATMEGA328.3 (GND), ATMEGA328.5 (AGND), ATMEGA328.21 (GND), B2.-, C5.2, C6.-, C9.-, C10.1, C11.-, D3.A, IC3.1 (GND/ADJ), INTERFACE.5, JP2.3, R3.1, R14.1, RESET.2, RFM69.GND, T1.2 (E), X1.2
unnamed: ATMEGA328.7 (PB6(XTAL1/TOSC1)), X1.1
unnamed: R2.2, T1.1 (B)
unnamed: RFM69.ANA (ANT), U$1.P$1
unnamed: D1.A, K1.2, T1.3 (C)
unnamed: K1.S, X2.2
unnamed: K1.P@, R11.1, X2.4
unnamed: B2.AC2, X2.1, X2.3
unnamed: C7.2, C8.-, D3.C, L1.1, LNK.S, R13.2
unnamed: LNK.D, R10.2
unnamed: B2.+, C6.+, R10.1
unnamed: B2.AC1, R11.2
unnamed: C7.1, LNK.BP
unnamed: C8.+, D4.C, R12.1
unnamed: ATMEGA328.8 (PB7(XTAL2/TOSC2)), X1.3
RST: ATMEGA328.29 (PC6(/RESET)), R1.2, RESET.1, U$2.VPP
VCC: ATMEGA328.4 (VCC), ATMEGA328.6 (VCC), ATMEGA328.18 (AVCC), C10.2, C11.+, IC3.2 (OUT), IC3.4 (OUT), INTERFACE.1, R1.1, RFM69.VDD (VCC)

Notes on the sheet:
Remote home
Robert Gregor
http://www.remote-home.org

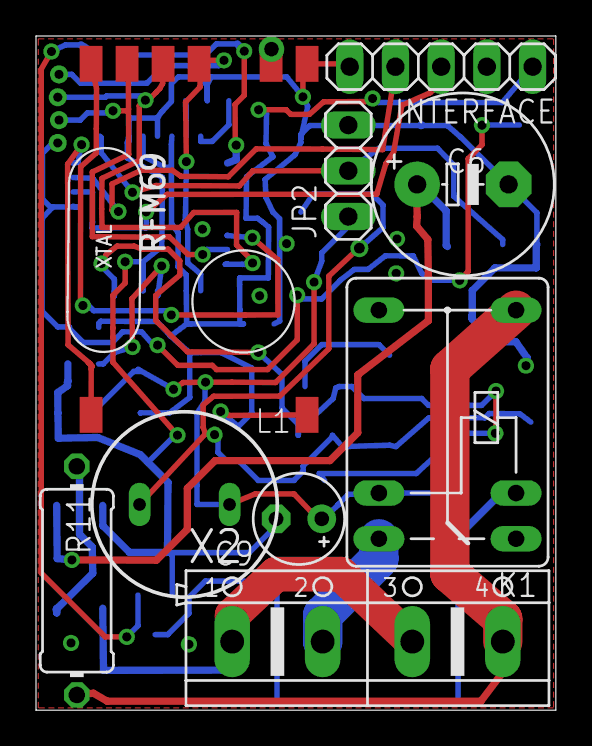
[picture p17: board SimpleSwitch.brd from above]

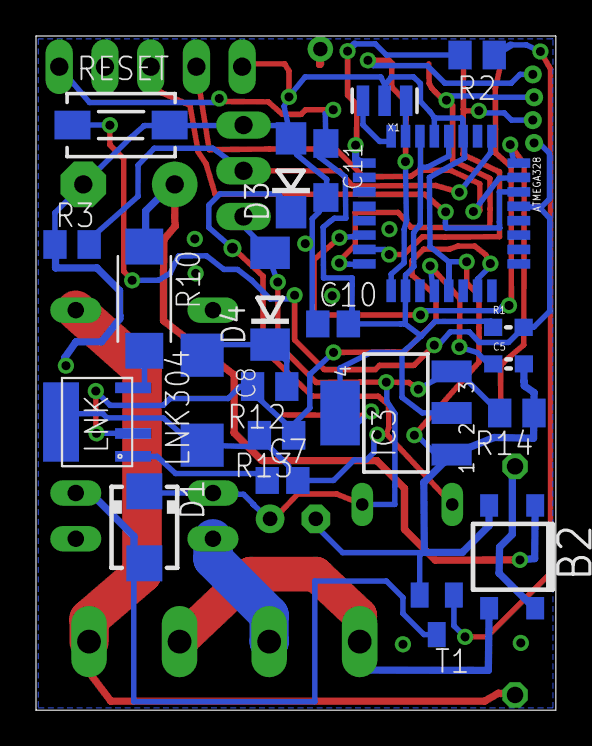
[picture p18: board SimpleSwitch.brd from below]

Board: 2 copper layers, 28.9 x 37.5 mm, 33 parts (22 on the bottom side), 29 nets.
