robertgregor/private/Hardware/Ardunio/eagle/Moteino.brd

## EAGLE design Hardware/Ardunio/eagle/Moteino.brd (2014-12-24)

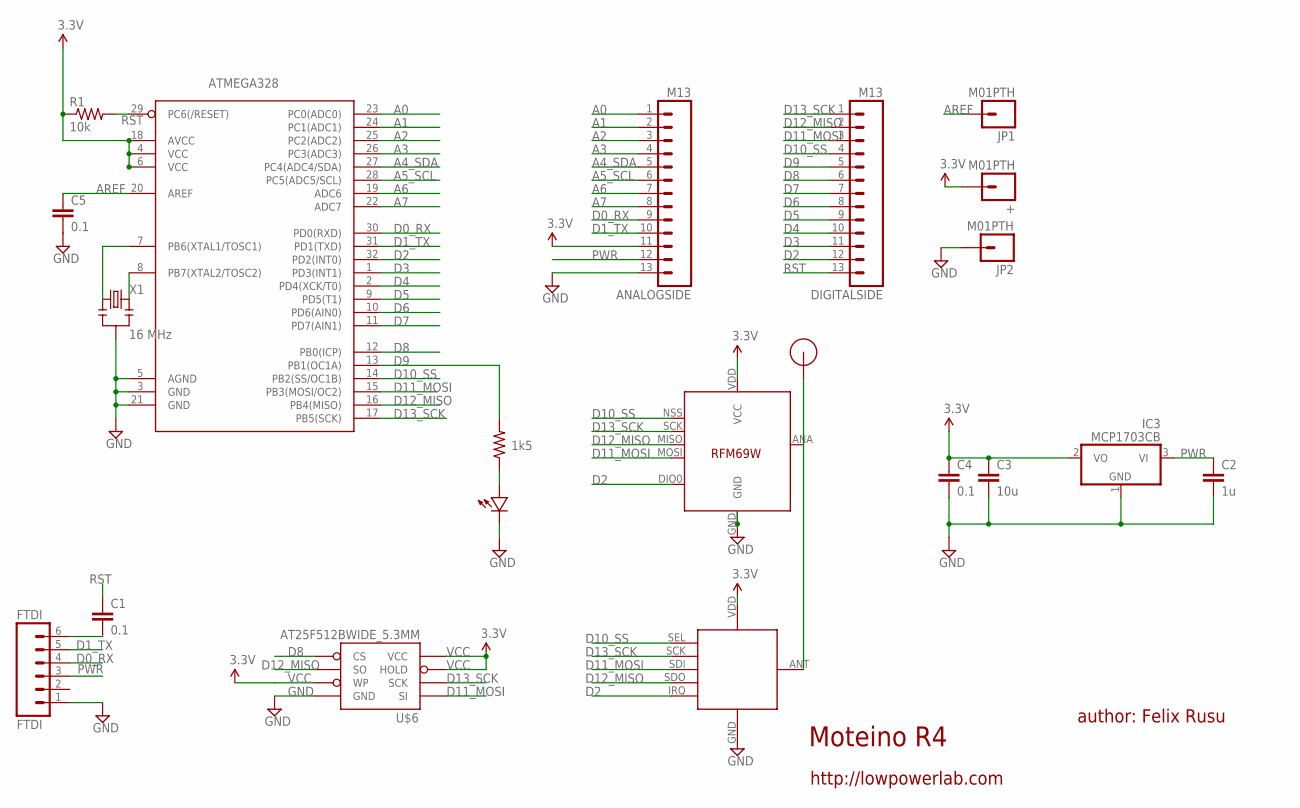
[picture p19: schematic Moteino.sch]

Parts:
+: M01PTH; 1X01
ANALOGSIDE: M13; 1X13
ATMEGA328: ATMega-328; TQFP32-08
C1, C4, C5: 0.1; 0603-CAP
C2: 1u; 0603-CAP
C3: 10u; 0805-CAP
DIGITALSIDE: M13; 1X13
FTDI: FTDI; 1X06
IC3: MCP1703CB; SOT23
JP1, JP2: M01PTH; 1X01
R1: 10k; 0603-RES
R2: 1k5; 0603-RES
RFM12B: RFM12B_MINPADS; RFM12B-MINPADS
U$1: RFM12B_ANTENNA; RFM12B-ANTENNA
U$2: LED0603; 0603-LED
U$5: RFM69; RFM69W-MINPADS
U$6: AT25F512BWIDE_5.3MM; SO08WIDE
X1: 16 MHz; RESONATOR-SMD

Connections:
A0: ANALOGSIDE.1, ATMEGA328.23 (PC0(ADC0))
A1: ANALOGSIDE.2, ATMEGA328.24 (PC1(ADC1))
A2: ANALOGSIDE.3, ATMEGA328.25 (PC2(ADC2))
A3: ANALOGSIDE.4, ATMEGA328.26 (PC3(ADC3))
A4_SDA: ANALOGSIDE.5, ATMEGA328.27 (PC4(ADC4/SDA))
A5_SCL: ANALOGSIDE.6, ATMEGA328.28 (PC5(ADC5/SCL))
A6: ANALOGSIDE.7, ATMEGA328.19 (ADC6)
A7: ANALOGSIDE.8, ATMEGA328.22 (ADC7)
AREF: ATMEGA328.20 (AREF), C5.1, JP1.1
D0_RX: ANALOGSIDE.9, ATMEGA328.30 (PD0(RXD)), FTDI.4
D1_TX: ANALOGSIDE.10, ATMEGA328.31 (PD1(TXD)), FTDI.5
D2: ATMEGA328.32 (PD2(INT0)), DIGITALSIDE.12, RFM12B.IRQ, U$5.DIO0
D3: ATMEGA328.1 (PD3(INT1)), DIGITALSIDE.11
D4: ATMEGA328.2 (PD4(XCK/T0)), DIGITALSIDE.10
D5: ATMEGA328.9 (PD5(T1)), DIGITALSIDE.9
D6: ATMEGA328.10 (PD6(AIN0)), DIGITALSIDE.8
D7: ATMEGA328.11 (PD7(AIN1)), DIGITALSIDE.7
D8: ATMEGA328.12 (PB0(ICP)), DIGITALSIDE.6, U$6.1 (CS)
D9: ATMEGA328.13 (PB1(OC1A)), DIGITALSIDE.5, R2.2
D10_SS: ATMEGA328.14 (PB2(SS/OC1B)), DIGITALSIDE.4, RFM12B.SEL, U$5.NSS (SEL)
D11_MOSI: ATMEGA328.15 (PB3(MOSI/OC2)), DIGITALSIDE.3, RFM12B.SDI (SDI/MOSI), U$5.MOSI, U$6.5 (SI)
D12_MISO: ATMEGA328.16 (PB4(MISO)), DIGITALSIDE.2, RFM12B.SDO (SDO/MISO), U$5.MISO, U$6.2 (SO)
D13_SCK: ATMEGA328.17 (PB5(SCK)), DIGITALSIDE.1, RFM12B.SCK, U$5.SCK, U$6.6 (SCK)
GND: ANALOGSIDE.13, ATMEGA328.3 (GND), ATMEGA328.5 (AGND), ATMEGA328.21 (GND), C2.2, C3.2, C4.2, C5.2, FTDI.1, IC3.1 (GND), JP2.1, RFM12B.GND, U$2.MINUS, U$5.GND, U$6.4 (GND), X1.2
unnamed: ATMEGA328.7 (PB6(XTAL1/TOSC1)), X1.1
unnamed: R2.1, U$2.PLUS
unnamed: RFM12B.ANT, U$1.P$1, U$5.ANA (ANT)
unnamed: C1.2, FTDI.6
unnamed: ATMEGA328.8 (PB7(XTAL2/TOSC2)), X1.3
PWR: ANALOGSIDE.12, C2.1, FTDI.3, IC3.3 (VI)
RST: ATMEGA328.29 (PC6(/RESET)), C1.1, DIGITALSIDE.13, R1.2
VCC: +.1, ANALOGSIDE.11, ATMEGA328.4 (VCC), ATMEGA328.6 (VCC), ATMEGA328.18 (AVCC), C3.1, C4.1, IC3.2 (VO), R1.1, RFM12B.VDD, U$5.VDD (VCC), U$6.3 (WP), U$6.7 (HOLD), U$6.8 (VCC)

Notes on the sheet:
Moteino R4
author: Felix Rusu
http://lowpowerlab.com

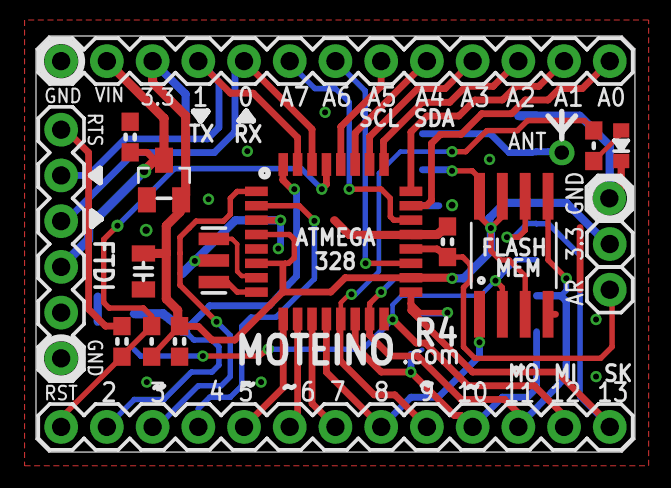
[picture p20: board Moteino.brd from above]

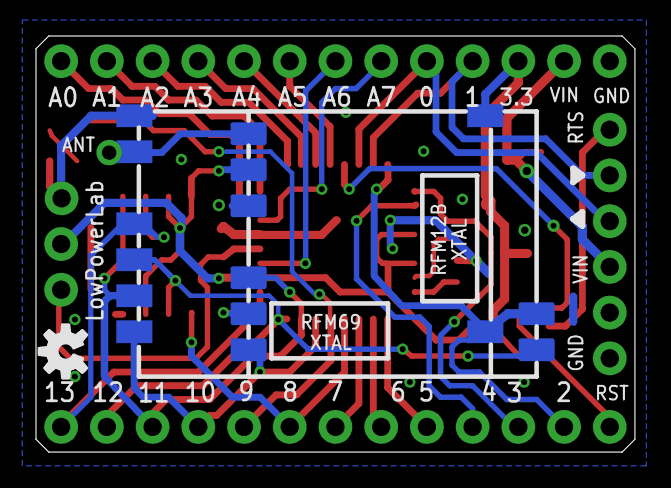
[picture p21: board Moteino.brd from below]

Board: 2 copper layers, 33.3 x 23.1 mm, 22 parts (3 on the bottom side), 32 nets.

Other parts of the board:
U$3: OSHW-LOGO-S
