robertgregor/private/Hardware/SchemasBoard/heatingHeaderEQ3.brd

## EAGLE design Hardware/SchemasBoard/heatingHeaderEQ3.brd (2013-05-07)

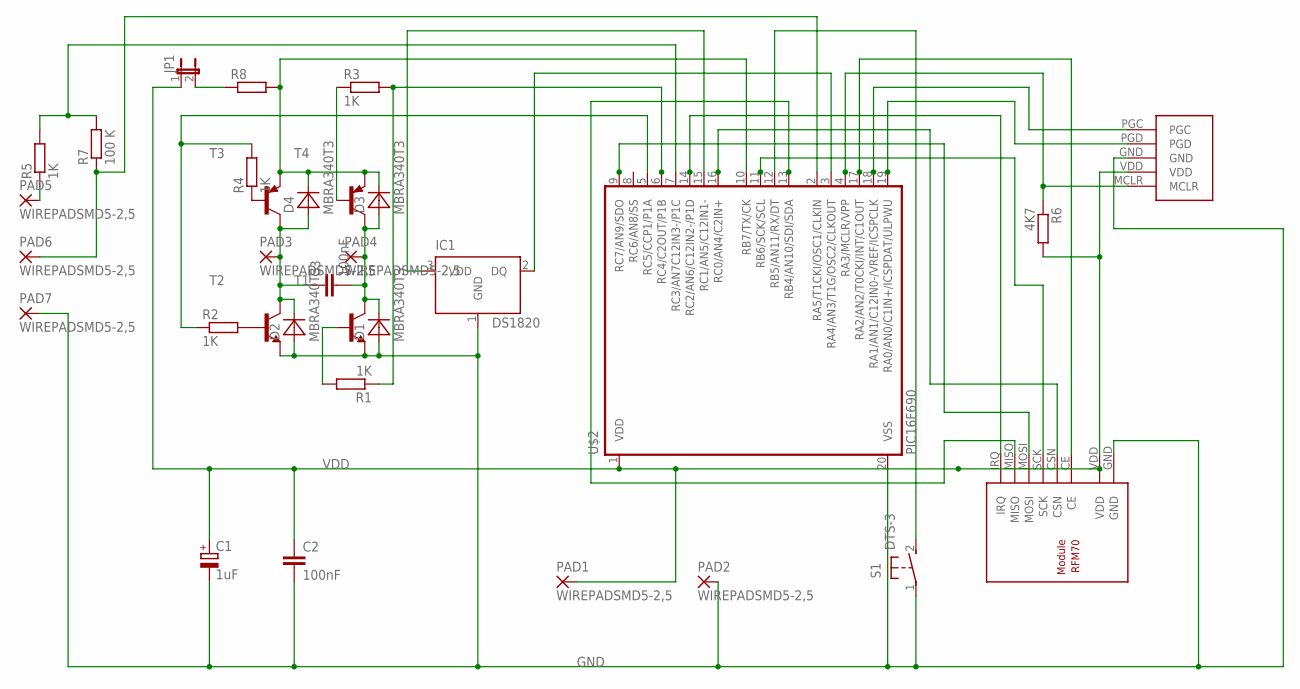
[picture p22: schematic heatingHeaderEQ3.sch]

Parts:
C1: 1uF; SMC_A
C2, C3: 100nF; C2012
D1, D2, D3, D4: MBRA340T3; SMA
IC1: DS1820; TO-92
JP1: JP1E; JP1
PAD1, PAD2, PAD3, PAD4, PAD5, PAD6, PAD7: WIREPADSMD5-2,5; 5-2,5
R1, R2, R3, R4, R5: 1K; R1206
R6: 4K7; R1206W
R7: 100 K; R1206
R8: R-EU_R2512W; R2512W
S1: DTS-3
T1, T2: BC817-40-NPN-SOT23-BEC; SOT23-BEC
T3, T4: BC807-16-PNP-SOT23-BEC; SOT23-BEC
U$1: RFM70
U$2: PIC16F690; SSOP20
U$3: PROGRAMMINGHEADERDIP; PROGHEADER

Connections:
GND: C1.-, C2.2, D1.A, D2.A, IC1.1 (GND), PAD2.1, PAD7.1, S1.1, T1.E, T2.E, U$1.GND, U$2.20 (VSS), U$3.GND
unnamed: IC1.2 (DQ), U$2.3 (RA4/AN3/T1G/OSC2/CLKOUT)
unnamed: JP1.2, R8.1
unnamed: IC1.3 (VDD), U$2.15 (RC1/AN5/C12IN1-)
unnamed: PAD5.1, R5.1
unnamed: U$1.MISO, U$2.13 (RB4/AN10/SDI/SDA)
unnamed: C3.1, D2.C, D4.A, PAD3.1, T2.C, T3.C
unnamed: C3.2, D1.C, D3.A, PAD4.1, T1.C, T4.C
unnamed: PAD6.1, R7.1, U$2.2 (RA5/T1CKI/OSC1/CLKIN)
unnamed: S1.2, U$2.12 (RB5/AN11/RX/DT)
unnamed: R5.2, R7.2, U$2.7 (RC3/AN7C12IN3-/P1C)
unnamed: R2.2, T2.B
unnamed: R4.1, T3.B
unnamed: D3.C, D4.C, R8.2, T3.E, T4.E, U$2.10 (RB7/TX/CK)
unnamed: U$1.CE, U$2.17 (RA2/AN2/T0CKI/INT/C1OUT)
unnamed: U$2.19 (RA0/AN0/C1IN+/ICSPDAT/ULPWU), U$3.PGD
unnamed: U$2.18 (RA1/AN1/C12IN0-/VREF/ICSPCLK), U$3.PGC
unnamed: U$1.CSN, U$2.16 (RC0/AN4/C2IN+)
unnamed: U$1.IRQ, U$2.14 (RC2/AN6/C12IN2-/P1D)
unnamed: U$1.SCK, U$2.11 (RB6/SCK/SCL)
unnamed: U$1.MOSI, U$2.9 (RC7/AN9/SDO)
unnamed: R1.2, T1.B
unnamed: R6.1, U$2.4 (RA3/MCLR/VPP), U$3.MCLR
unnamed: R3.1, T4.B
unnamed: R1.1, R3.2, U$2.6 (RC4/C2OUT/P1B)
unnamed: R2.1, R4.2, U$2.5 (RC5/CCP1/P1A)
VDD: C1.+, C2.1, JP1.1, PAD1.1, R6.2, U$1.VDD, U$2.1 (VDD), U$3.VDD

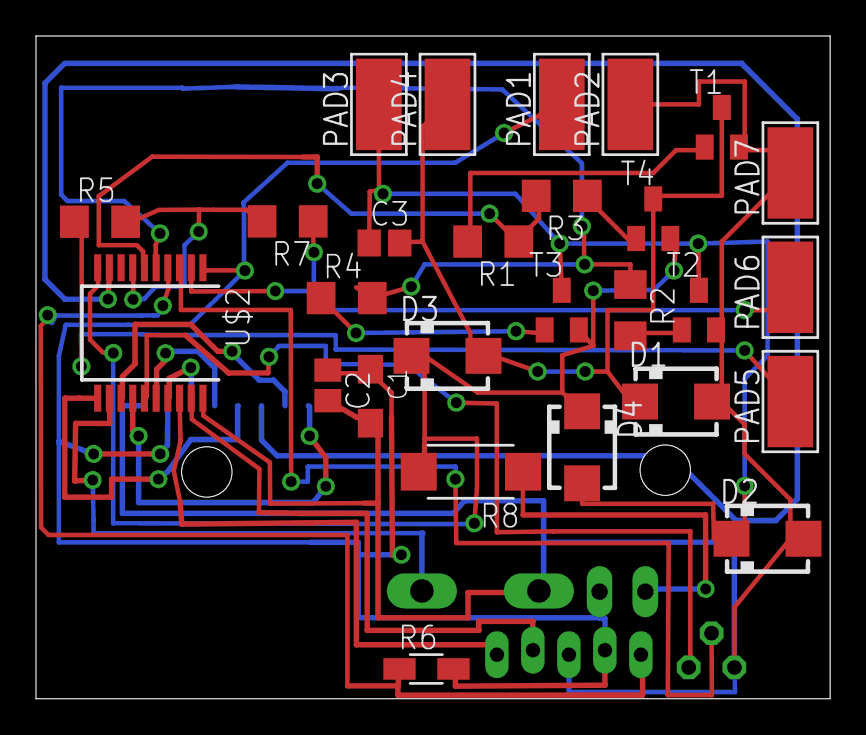
[picture p23: board heatingHeaderEQ3.brd from above]

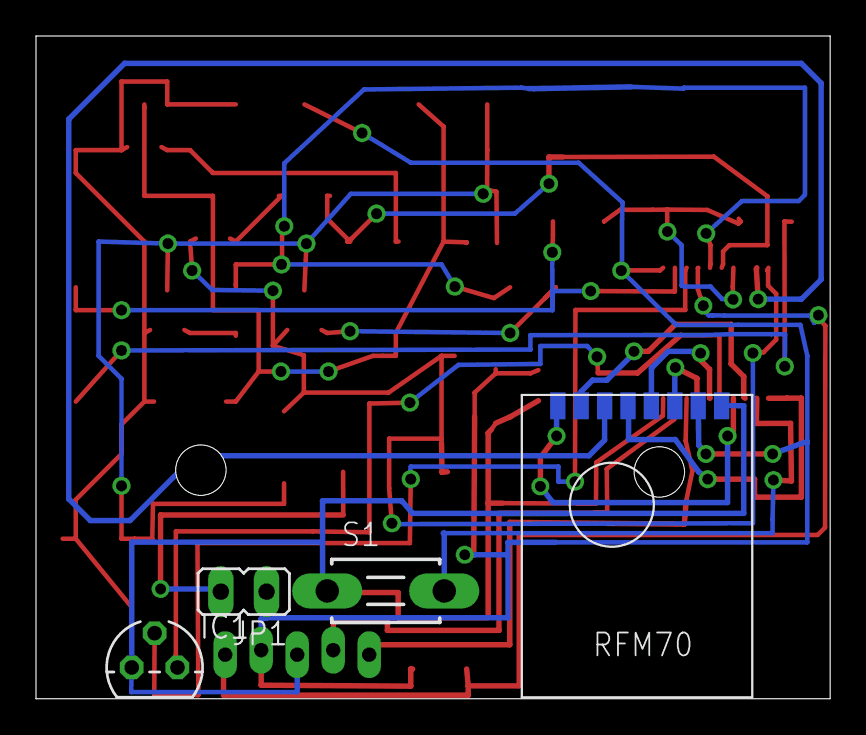
[picture p24: board heatingHeaderEQ3.brd from below]

Board: 2 copper layers, 44.1 x 36.8 mm, 32 parts (5 on the bottom side), 27 nets.
