robertgregor/private/Hardware/SchemasBoard/tempSensor.brd

## EAGLE design Hardware/SchemasBoard/tempSensor.brd (2013-02-23)

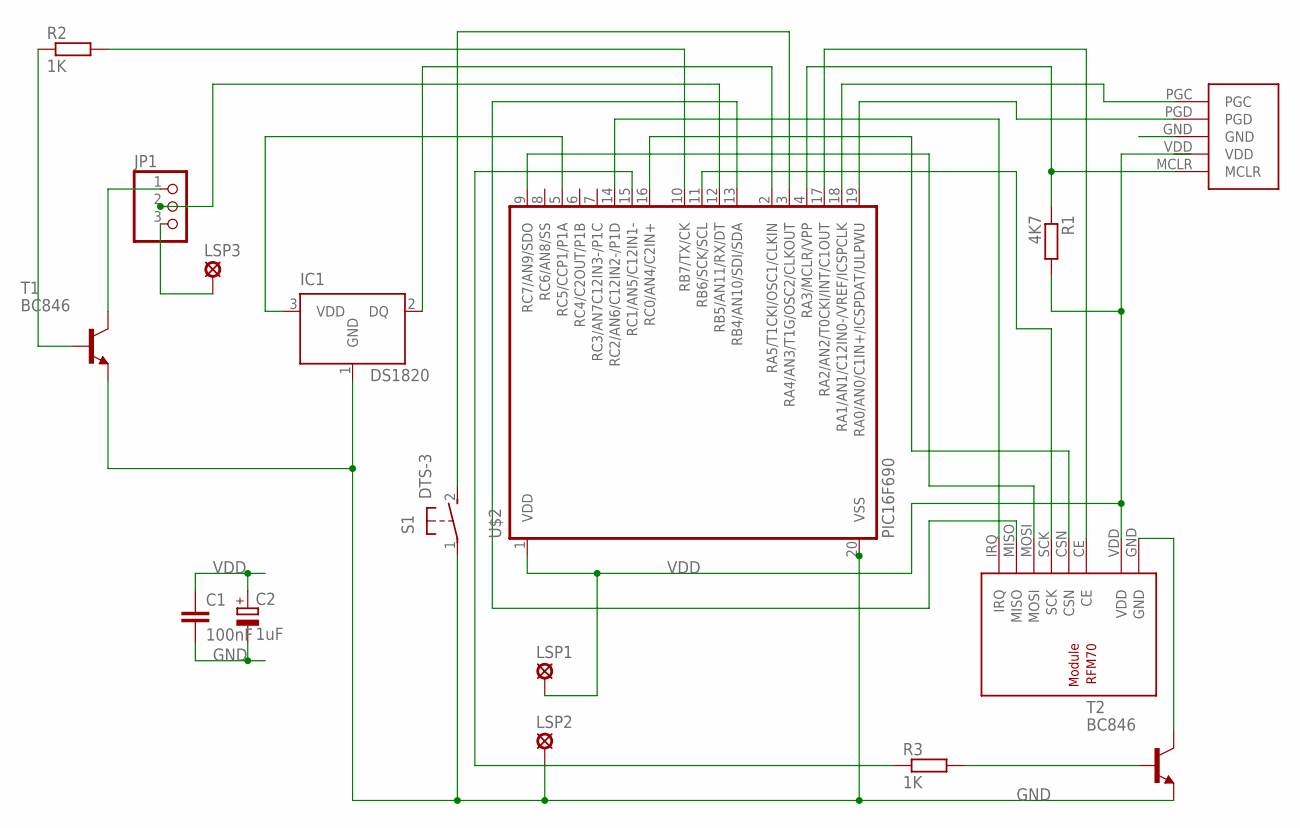
[picture p25: schematic tempSensor.sch]

Parts:
C1: 100nF; C2012
C2: 1uF; SMC_A
IC1: DS1820; TO-92
JP1: PINHD-1X3; 1X03
LSP1, LSP2, LSP3: SE14
R1: 4K7; R1206W
R2, R3: 1K; R1206W
S1: DTS-3
T1, T2: BC846; SOT23
U$1: RFM70
U$2: PIC16F690; SSOP20
U$3: PROGRAMMINGHEADERDIP; PROGHEADER

Connections:
GND: C1.2, C2.-, IC1.1 (GND), LSP2.MP, S1.1, T1.2 (E), T2.2 (E), U$2.20 (VSS)
unnamed: IC1.2 (DQ), U$2.2 (RA5/T1CKI/OSC1/CLKIN)
unnamed: S1.2, U$2.3 (RA4/AN3/T1G/OSC2/CLKOUT)
unnamed: IC1.3 (VDD), U$2.5 (RC5/CCP1/P1A)
unnamed: JP1.2, U$2.12 (RB5/AN11/RX/DT)
unnamed: JP1.3, LSP3.MP
unnamed: R2.2, U$2.10 (RB7/TX/CK)
unnamed: R2.1, T1.1 (B)
unnamed: U$2.19 (RA0/AN0/C1IN+/ICSPDAT/ULPWU), U$3.PGD
unnamed: JP1.1, T1.3 (C)
unnamed: U$2.18 (RA1/AN1/C12IN0-/VREF/ICSPCLK), U$3.PGC
unnamed: U$1.MISO, U$2.13 (RB4/AN10/SDI/SDA)
unnamed: T2.3 (C), U$1.GND
unnamed: R3.2, T2.1 (B)
unnamed: R3.1, U$2.15 (RC1/AN5/C12IN1-)
unnamed: U$1.CE, U$2.17 (RA2/AN2/T0CKI/INT/C1OUT)
unnamed: U$1.CSN, U$2.16 (RC0/AN4/C2IN+)
unnamed: U$1.IRQ, U$2.14 (RC2/AN6/C12IN2-/P1D)
unnamed: U$1.SCK, U$2.11 (RB6/SCK/SCL)
unnamed: U$1.MOSI, U$2.9 (RC7/AN9/SDO)
unnamed: R1.1, U$2.4 (RA3/MCLR/VPP), U$3.MCLR
VDD: C1.1, C2.+, LSP1.MP, R1.2, U$1.VDD, U$2.1 (VDD), U$3.VDD

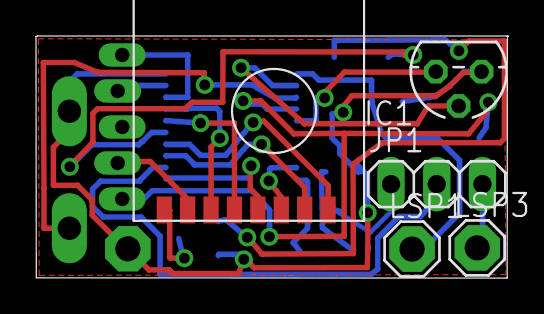
[picture p26: board tempSensor.brd from above]

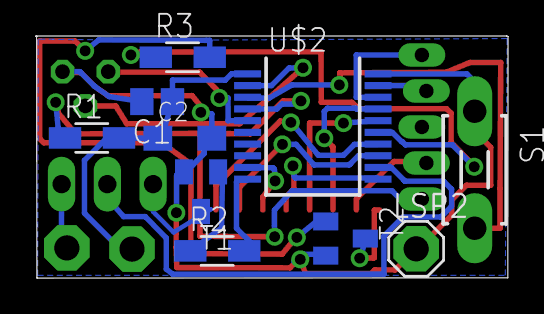
[picture p27: board tempSensor.brd from below]

Board: 2 copper layers, 26.2 x 13.4 mm, 16 parts (10 on the bottom side), 22 nets.
