robertgregor/private/RMGHomeController/Hardware/Schema.sch

## EAGLE design RMGHomeController/Hardware/Schema.sch (2013-09-08)

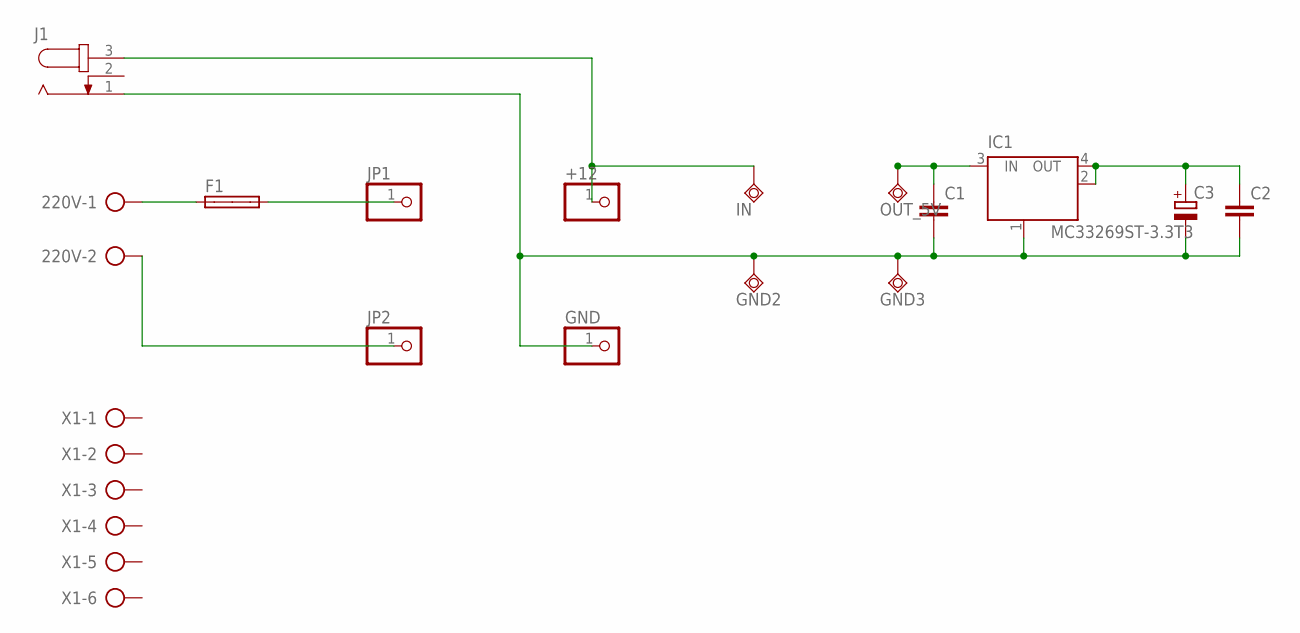
[picture p28: schematic Schema.sch]

Parts:
220V: AK500/2
+12: PINHD-1X1; 1X01
C1, C2: C-EUC2012; C2012
C3: CPOL-EUE2.5-5; E2,5-5
F1: SH32
GND: PINHD-1X1; 1X01
GND2, GND3: TPSQTP20SQ; TP20SQ
IC1: MC33269ST-3.3T3; SOT223
IN: TPSQTP20SQ; TP20SQ
J1: JACK-PLUG1; SPC4078
JP1, JP2: PINHD-1X1; 1X01
OUT_5V: TPSQTP20SQ; TP20SQ
X1: AK500/6

Connections:
unnamed: 220V.1, F1.1A
unnamed: F1.2A, JP1.1
unnamed: 220V.2, JP2.1
unnamed: +12.1, IN.TP, J1.3
unnamed: C1.2, C2.2, C3.-, GND.1, GND2.TP, GND3.TP, IC1.1 (GND/ADJ), J1.1
unnamed: C1.1, IC1.3 (IN), OUT_5V.TP
unnamed: C2.1, C3.+, IC1.2 (OUT), IC1.4 (OUT)
