robertgregor/private/Hardware/MicrochipSources/FinalOneToOne/SimpleSwitch.asm

; PICBASIC PRO(TM) Compiler 2.60C, (c) 1998, 2011 microEngineering Labs, Inc. All Rights Reserved. 
PM_USED			EQU	1

	INCLUDE	"16F690.INC"


; Define statements.
; D:\DOCUME~1\PICDEV~1\PBP\PBP260\16F690.BAS	00017	DEFINE  CODE_SIZE 4
#define		CODE_SIZE		 4
; D:\DOCUME~1\PICDEV~1\PBP\PBP260\16F690.BAS	00018	DEFINE	CCP1_REG PORTC
#define		CCP1_REG		 PORTC
; D:\DOCUME~1\PICDEV~1\PBP\PBP260\16F690.BAS	00019	DEFINE	CCP1_BIT 5
#define		CCP1_BIT		 5
; C:\REMOTE~1\PRIVATE\HARDWARE\MICROC~1\FINALO~1\SIMPLE~1.PBP	00022	 DEFINE OSC 8
#define		OSC		 8

RAM_START       		EQU	00020h
RAM_END         		EQU	0016Fh
RAM_BANKS       		EQU	00003h
BANK0_START     		EQU	00020h
BANK0_END       		EQU	0007Fh
BANK1_START     		EQU	000A0h
BANK1_END       		EQU	000EFh
BANK2_START     		EQU	00120h
BANK2_END       		EQU	0016Fh
EEPROM_START    		EQU	02100h
EEPROM_END      		EQU	021FFh

; D:\DOCUME~1\PICDEV~1\PBP\PBP260\PBPPIC14.RAM	00012	A00020	R0      VAR     WORD BANK0 SYSTEM       ' System Register
R0              		EQU	RAM_START + 000h
; D:\DOCUME~1\PICDEV~1\PBP\PBP260\PBPPIC14.RAM	00013	A00022	R1      VAR     WORD BANK0 SYSTEM       ' System Register
R1              		EQU	RAM_START + 002h
; D:\DOCUME~1\PICDEV~1\PBP\PBP260\PBPPIC14.RAM	00014	A00024	R2      VAR     WORD BANK0 SYSTEM       ' System Register
R2              		EQU	RAM_START + 004h
; D:\DOCUME~1\PICDEV~1\PBP\PBP260\PBPPIC14.RAM	00015	A00026	R3      VAR     WORD BANK0 SYSTEM       ' System Register
R3              		EQU	RAM_START + 006h
; D:\DOCUME~1\PICDEV~1\PBP\PBP260\PBPPIC14.RAM	00016	A00028	R4      VAR     WORD BANK0 SYSTEM       ' System Register
R4              		EQU	RAM_START + 008h
; D:\DOCUME~1\PICDEV~1\PBP\PBP260\PBPPIC14.RAM	00017	A0002A	R5      VAR     WORD BANK0 SYSTEM       ' System Register
R5              		EQU	RAM_START + 00Ah
; D:\DOCUME~1\PICDEV~1\PBP\PBP260\PBPPIC14.RAM	00018	A0002C	R6      VAR     WORD BANK0 SYSTEM       ' System Register
R6              		EQU	RAM_START + 00Ch
; D:\DOCUME~1\PICDEV~1\PBP\PBP260\PBPPIC14.RAM	00019	A0002E	R7      VAR     WORD BANK0 SYSTEM       ' System Register
R7              		EQU	RAM_START + 00Eh
; D:\DOCUME~1\PICDEV~1\PBP\PBP260\PBPPIC14.RAM	00020	A00030	R8      VAR     WORD BANK0 SYSTEM       ' System Register
R8              		EQU	RAM_START + 010h
; D:\DOCUME~1\PICDEV~1\PBP\PBP260\PBPPIC14.RAM	00026	A00032	FLAGS   VAR     BYTE BANK0 SYSTEM       ' Static flags
FLAGS           		EQU	RAM_START + 012h
; D:\DOCUME~1\PICDEV~1\PBP\PBP260\PBPPIC14.RAM	00025	A00033	GOP     VAR     BYTE BANK0 SYSTEM       ' Gen Op Parameter
GOP             		EQU	RAM_START + 013h
; D:\DOCUME~1\PICDEV~1\PBP\PBP260\PBPPIC14.RAM	00022	A00034	RM1     VAR     BYTE BANK0 SYSTEM       ' Pin 1 Mask
RM1             		EQU	RAM_START + 014h
; D:\DOCUME~1\PICDEV~1\PBP\PBP260\PBPPIC14.RAM	00024	A00035	RM2     VAR     BYTE BANK0 SYSTEM       ' Pin 2 Mask
RM2             		EQU	RAM_START + 015h
; D:\DOCUME~1\PICDEV~1\PBP\PBP260\PBPPIC14.RAM	00021	A00036	RR1     VAR     BYTE BANK0 SYSTEM       ' Pin 1 Register
RR1             		EQU	RAM_START + 016h
; D:\DOCUME~1\PICDEV~1\PBP\PBP260\PBPPIC14.RAM	00023	A00037	RR2     VAR     BYTE BANK0 SYSTEM       ' Pin 2 Register
RR2             		EQU	RAM_START + 017h
; C:\REMOTE~1\PRIVATE\HARDWARE\MICROC~1\FINALO~1\RFM73.PBP	00016	A00038	data_in var Byte[payloadLengthD] 'data received
_data_in         		EQU	RAM_START + 018h
; C:\REMOTE~1\PRIVATE\HARDWARE\MICROC~1\FINALO~1\RFM73.PBP	00015	A00050	data_out VAR BYTE[payloadLengthD] 'data sent
_data_out        		EQU	RAM_START + 030h
; C:\REMOTE~1\PRIVATE\HARDWARE\MICROC~1\FINALO~1\RFM73.PBP	00017	A00068	temp_data var byte[payloadLength]
_temp_data       		EQU	RAM_START + 048h
; C:\REMOTE~1\PRIVATE\HARDWARE\MICROC~1\FINALO~1\RFM73.PBP	00014	A0007E	Pack_count VAR word 'number of packets sent
_Pack_count      		EQU	RAM_START + 05Eh
; C:\REMOTE~1\PRIVATE\HARDWARE\MICROC~1\FINALO~1\SIMPLE~1.PBP	00001	A000A0	'@  __config _INTRC_OSC_NOCLKOUT & _WDT_ON & _MCLRE_OFF & _CP_OFF & _CPD_OFF & _FCMEN_OFF & _IESO_OFF & _BOR_ON & _PWRTE_ON
T1              		EQU	RAM_START + 080h
; C:\REMOTE~1\PRIVATE\HARDWARE\MICROC~1\FINALO~1\SIMPLE~1.PBP	00056	A000A2	temp_word var word
_temp_word       		EQU	RAM_START + 082h
; C:\REMOTE~1\PRIVATE\HARDWARE\MICROC~1\FINALO~1\SIMPLE~1.PBP	00060	A000A4	ticks   var word    ' Define pieces of seconds variable
_ticks           		EQU	RAM_START + 084h
; C:\REMOTE~1\PRIVATE\HARDWARE\MICROC~1\FINALO~1\SIMPLE~1.PBP	00048	A000A6	ci var byte
_ci              		EQU	RAM_START + 086h
; C:\REMOTE~1\PRIVATE\HARDWARE\MICROC~1\FINALO~1\SIMPLE~1.PBP	00049	A000A7	configure var byte
_configure       		EQU	RAM_START + 087h
; C:\REMOTE~1\PRIVATE\HARDWARE\MICROC~1\FINALO~1\SIMPLE~1.PBP	00062	A000A8	conversionSuccess VAR BYTE
_conversionSuccess		EQU	RAM_START + 088h
; C:\REMOTE~1\PRIVATE\HARDWARE\MICROC~1\FINALO~1\RFM73.PBP	00025	A000A9	device_id var byte
_device_id       		EQU	RAM_START + 089h
; C:\REMOTE~1\PRIVATE\HARDWARE\MICROC~1\FINALO~1\SIMPLE~1.PBP	00057	A000AA	EEPROMBYTE VAR BYTE
_EEPROMBYTE      		EQU	RAM_START + 08Ah
; C:\REMOTE~1\PRIVATE\HARDWARE\MICROC~1\FINALO~1\SIMPLE~1.PBP	00058	A000AB	EEPROMPOSITION VAR BYTE
_EEPROMPOSITION  		EQU	RAM_START + 08Bh
; C:\REMOTE~1\PRIVATE\HARDWARE\MICROC~1\FINALO~1\SIMPLE~1.PBP	00046	A000AC	i VAR BYTE 'loop counter
_i               		EQU	RAM_START + 08Ch
; C:\REMOTE~1\PRIVATE\HARDWARE\MICROC~1\FINALO~1\SIMPLE~1.PBP	00047	A000AD	j var byte
_j               		EQU	RAM_START + 08Dh
; C:\REMOTE~1\PRIVATE\HARDWARE\MICROC~1\FINALO~1\RFM73.PBP	00019	A000AE	k VAR byte
_k               		EQU	RAM_START + 08Eh
; C:\REMOTE~1\PRIVATE\HARDWARE\MICROC~1\FINALO~1\SIMPLE~1.PBP	00061	A000AF	l1counter var byte
_l1counter       		EQU	RAM_START + 08Fh
; C:\REMOTE~1\PRIVATE\HARDWARE\MICROC~1\FINALO~1\RFM73.PBP	00012	A000B0	num_byte var byte 'temp value
_num_byte        		EQU	RAM_START + 090h
; C:\REMOTE~1\PRIVATE\HARDWARE\MICROC~1\FINALO~1\SIMPLE~1.PBP	00059	A000B1	seconds  var byte    ' Define second variable
_seconds         		EQU	RAM_START + 091h
; C:\REMOTE~1\PRIVATE\HARDWARE\MICROC~1\FINALO~1\SIMPLE~1.PBP	00052	A000B2	temp1_byte var byte
_temp1_byte      		EQU	RAM_START + 092h
; C:\REMOTE~1\PRIVATE\HARDWARE\MICROC~1\FINALO~1\RFM73.PBP	00021	A000B3	temp1_byte_rfm var byte
_temp1_byte_rfm  		EQU	RAM_START + 093h
; C:\REMOTE~1\PRIVATE\HARDWARE\MICROC~1\FINALO~1\SIMPLE~1.PBP	00053	A000B4	temp2_byte var byte
_temp2_byte      		EQU	RAM_START + 094h
; C:\REMOTE~1\PRIVATE\HARDWARE\MICROC~1\FINALO~1\RFM73.PBP	00022	A000B5	temp2_byte_rfm var byte
_temp2_byte_rfm  		EQU	RAM_START + 095h
; C:\REMOTE~1\PRIVATE\HARDWARE\MICROC~1\FINALO~1\SIMPLE~1.PBP	00054	A000B6	temp3_byte var byte
_temp3_byte      		EQU	RAM_START + 096h
; C:\REMOTE~1\PRIVATE\HARDWARE\MICROC~1\FINALO~1\RFM73.PBP	00023	A000B7	temp3_byte_rfm var byte
_temp3_byte_rfm  		EQU	RAM_START + 097h
; C:\REMOTE~1\PRIVATE\HARDWARE\MICROC~1\FINALO~1\SIMPLE~1.PBP	00055	A000B8	temp4_byte var byte
_temp4_byte      		EQU	RAM_START + 098h
; C:\REMOTE~1\PRIVATE\HARDWARE\MICROC~1\FINALO~1\RFM73.PBP	00024	A000B9	temp4_byte_rfm var byte
_temp4_byte_rfm  		EQU	RAM_START + 099h
; C:\REMOTE~1\PRIVATE\HARDWARE\MICROC~1\FINALO~1\SIMPLE~1.PBP	00051	A000BA	temp_byte var byte
_temp_byte       		EQU	RAM_START + 09Ah
; C:\REMOTE~1\PRIVATE\HARDWARE\MICROC~1\FINALO~1\SIMPLE~1.PBP	00050	A000BB	temp_byte_int var byte
_temp_byte_int   		EQU	RAM_START + 09Bh
; C:\REMOTE~1\PRIVATE\HARDWARE\MICROC~1\FINALO~1\RFM73.PBP	00020	A000BC	temp_byte_rfm var byte
_temp_byte_rfm   		EQU	RAM_START + 09Ch
; C:\REMOTE~1\PRIVATE\HARDWARE\MICROC~1\FINALO~1\RFM73.PBP	00013	A000BD	val var byte 'temp value
_val             		EQU	RAM_START + 09Dh
; C:\REMOTE~1\PRIVATE\HARDWARE\MICROC~1\FINALO~1\RFM73.PBP	00018	A000BE	w var byte
_w               		EQU	RAM_START + 09Eh
; D:\DOCUME~1\PICDEV~1\PBP\PBP260\16F690.BAS	00023	PORTL   VAR     PORTA
_PORTL           		EQU	 PORTA
; D:\DOCUME~1\PICDEV~1\PBP\PBP260\16F690.BAS	00024	PORTH   VAR     PORTC
_PORTH           		EQU	 PORTC
; D:\DOCUME~1\PICDEV~1\PBP\PBP260\16F690.BAS	00025	TRISL   VAR     TRISA
_TRISL           		EQU	 TRISA
; D:\DOCUME~1\PICDEV~1\PBP\PBP260\16F690.BAS	00026	TRISH   VAR     TRISC
_TRISH           		EQU	 TRISC
#define _SSPEN           	_SSPCON??5
#define _CKP             	_SSPCON??4
#define _SMP             	_SSPSTAT??7
#define _CKE             	_SSPSTAT??6
#define _SSPIF           	_PIR1??3
#define _Ce              	_PORTA??2
#define _CSN             	_PORTC??0
#define _Irq             	_PORTC??2
#define _RES             	_PORTB??5
#define _RELAY           	_PORTA??4
#define _SSPCON??5       	 SSPCON, 005h
#define _SSPCON??4       	 SSPCON, 004h
#define _SSPSTAT??7      	 SSPSTAT, 007h
#define _SSPSTAT??6      	 SSPSTAT, 006h
#define _PIR1??3         	 PIR1, 003h
#define _PORTA??2        	 PORTA, 002h
#define _PORTC??0        	 PORTC, 000h
#define _PORTC??2        	 PORTC, 002h
#define _SSPCON??0       	 SSPCON, 000h
#define _PORTB??5        	 PORTB, 005h
#define _PORTA??4        	 PORTA, 004h
#define _val??0          	_val, 000h
#define _INTCON??2       	 INTCON, 002h
#define _INTCON??7       	 INTCON, 007h

; Constants.
_payloadLength   		EQU	00016h
_payloadLengthD  		EQU	00018h
_Idle_int        		EQU	00000h
_Max_rt          		EQU	00010h
_Tx_inter        		EQU	00030h
_Rx_ds           		EQU	00040h
_Read_reg        		EQU	00000h
_Write_reg       		EQU	00020h
_Rd_rx_pload     		EQU	00061h
_Wr_tx_pload     		EQU	000A0h
_Flush_tx        		EQU	000E1h
_Flush_rx        		EQU	000E2h
_Reuse_tx_pl     		EQU	000E3h
_Nop_comm        		EQU	000FFh
_Config_nrf      		EQU	00000h
_En_aa           		EQU	00001h
_En_rxaddr       		EQU	00002h
_Setup_aw        		EQU	00003h
_Setup_retr      		EQU	00004h
_Rf_ch           		EQU	00005h
_Rf_setup        		EQU	00006h
_Stat_us         		EQU	00007h
_Observe_tx      		EQU	00008h
_Cd              		EQU	00009h
_Rx_addr_p0      		EQU	0000Ah
_Rx_addr_p1      		EQU	0000Bh
_Rx_addr_p2      		EQU	0000Ch
_Rx_addr_p3      		EQU	0000Dh
_Rx_addr_p4      		EQU	0000Eh
_Rx_addr_p5      		EQU	0000Fh
_Tx_addr         		EQU	00010h
_Rx_pw_p0        		EQU	00011h
_Rx_pw_p1        		EQU	00012h
_Rx_pw_p2        		EQU	00013h
_Rx_pw_p3        		EQU	00014h
_Rx_pw_p4        		EQU	00015h
_Rx_pw_p5        		EQU	00016h
_Fifo_status     		EQU	00017h

; EEPROM data.
	ORG EEPROM_START

	ORG EEPROM_START + 000h
; C:\REMOTE~1\PRIVATE\HARDWARE\MICROC~1\FINALO~1\SIMPLE~1.PBP	00018	EEPROM  0, [40,"R","E","M","O","T","E","H","O","M",0,0,0,0,0,0]
	DE	028h
	DE	052h
	DE	045h
	DE	04Dh
	DE	04Fh
	DE	054h
	DE	045h
	DE	048h
	DE	04Fh
	DE	04Dh
	DE	000h
	DE	000h
	DE	000h
	DE	000h
	DE	000h
	DE	000h

	INCLUDE	"SIMPLE~1.MAC"
	INCLUDE	"PBPPIC14.LIB"


; D:\DOCUME~1\PICDEV~1\PBP\PBP260\16F690.BAS	00012	BANK0   $0020, $007F
; D:\DOCUME~1\PICDEV~1\PBP\PBP260\16F690.BAS	00013	BANK1   $00A0, $00EF
; D:\DOCUME~1\PICDEV~1\PBP\PBP260\16F690.BAS	00014	BANK2   $0120, $016F
; D:\DOCUME~1\PICDEV~1\PBP\PBP260\16F690.BAS	00015	EEPROM  $2100, $21FF
; D:\DOCUME~1\PICDEV~1\PBP\PBP260\16F690.BAS	00016	LIBRARY "PBPPIC14"
; D:\DOCUME~1\PICDEV~1\PBP\PBP260\16F690.BAS	00017	DEFINE  CODE_SIZE 4
; D:\DOCUME~1\PICDEV~1\PBP\PBP260\16F690.BAS	00018	DEFINE	CCP1_REG PORTC
; D:\DOCUME~1\PICDEV~1\PBP\PBP260\16F690.BAS	00019	DEFINE	CCP1_BIT 5

; D:\DOCUME~1\PICDEV~1\PBP\PBP260\16F690.BAS	00021	        include "PIC14EXT.BAS"

; D:\DOCUME~1\PICDEV~1\PBP\PBP260\16F690.BAS	00028	        include "PBPPIC14.RAM"

; C:\REMOTE~1\PRIVATE\HARDWARE\MICROC~1\FINALO~1\SIMPLE~1.PBP	00003	@ DEVICE PIC16F690,INTRC_OSC_NOCLKOUT

	ASM?
 DEVICE PIC16F690,INTRC_OSC_NOCLKOUT

	ENDASM?


; C:\REMOTE~1\PRIVATE\HARDWARE\MICROC~1\FINALO~1\SIMPLE~1.PBP	00004	@ DEVICE PIC16F690,WDT_ON

	ASM?
 DEVICE PIC16F690,WDT_ON

	ENDASM?


; C:\REMOTE~1\PRIVATE\HARDWARE\MICROC~1\FINALO~1\SIMPLE~1.PBP	00005	@ DEVICE PIC16F690,MCLR_OFF

	ASM?
 DEVICE PIC16F690,MCLR_OFF

	ENDASM?


; C:\REMOTE~1\PRIVATE\HARDWARE\MICROC~1\FINALO~1\SIMPLE~1.PBP	00006	@ DEVICE PIC16F690,CPD_OFF

	ASM?
 DEVICE PIC16F690,CPD_OFF

	ENDASM?


; C:\REMOTE~1\PRIVATE\HARDWARE\MICROC~1\FINALO~1\SIMPLE~1.PBP	00007	@ DEVICE PIC16F690,BOD_ON

	ASM?
 DEVICE PIC16F690,BOD_ON

	ENDASM?


; C:\REMOTE~1\PRIVATE\HARDWARE\MICROC~1\FINALO~1\SIMPLE~1.PBP	00008	@ DEVICE PIC16F690,PWRT_ON

	ASM?
 DEVICE PIC16F690,PWRT_ON

	ENDASM?

; C:\REMOTE~1\PRIVATE\HARDWARE\MICROC~1\FINALO~1\SIMPLE~1.PBP	00018	EEPROM  0, [40,"R","E","M","O","T","E","H","O","M",0,0,0,0,0,0]

; C:\REMOTE~1\PRIVATE\HARDWARE\MICROC~1\FINALO~1\SIMPLE~1.PBP	00020	INCLUDE "RFM73.pbp"
; C:\REMOTE~1\PRIVATE\HARDWARE\MICROC~1\FINALO~1\RFM73.PBP	00010	payloadLength con 22
; C:\REMOTE~1\PRIVATE\HARDWARE\MICROC~1\FINALO~1\RFM73.PBP	00011	payloadLengthD con 24
; C:\REMOTE~1\PRIVATE\HARDWARE\MICROC~1\FINALO~1\RFM73.PBP	00028	Idle_int con $00 'Idle no interrupt pending
; C:\REMOTE~1\PRIVATE\HARDWARE\MICROC~1\FINALO~1\RFM73.PBP	00029	Max_rt con $10 'Max # of Tx retrans interrupt
; C:\REMOTE~1\PRIVATE\HARDWARE\MICROC~1\FINALO~1\RFM73.PBP	00030	Tx_inter con $30 'Tx interrupted
; C:\REMOTE~1\PRIVATE\HARDWARE\MICROC~1\FINALO~1\RFM73.PBP	00031	Rx_ds con $40 'Rx data received
; C:\REMOTE~1\PRIVATE\HARDWARE\MICROC~1\FINALO~1\RFM73.PBP	00033	Read_reg con $00 'def read command to register
; C:\REMOTE~1\PRIVATE\HARDWARE\MICROC~1\FINALO~1\RFM73.PBP	00034	Write_reg CON $20 'def write command to register
; C:\REMOTE~1\PRIVATE\HARDWARE\MICROC~1\FINALO~1\RFM73.PBP	00035	Rd_rx_pload con $61 'def Rx payload register address
; C:\REMOTE~1\PRIVATE\HARDWARE\MICROC~1\FINALO~1\RFM73.PBP	00036	Wr_tx_pload con $A0 'def Tx payload register address
; C:\REMOTE~1\PRIVATE\HARDWARE\MICROC~1\FINALO~1\RFM73.PBP	00037	Flush_tx con $E1 'def flush Tx register command
; C:\REMOTE~1\PRIVATE\HARDWARE\MICROC~1\FINALO~1\RFM73.PBP	00038	Flush_rx con $E2 'def flush Rx register command
; C:\REMOTE~1\PRIVATE\HARDWARE\MICROC~1\FINALO~1\RFM73.PBP	00039	Reuse_tx_pl con $E3 'def reuse Tx payload register command
; C:\REMOTE~1\PRIVATE\HARDWARE\MICROC~1\FINALO~1\RFM73.PBP	00040	Nop_comm con $FF 'def No operation
; C:\REMOTE~1\PRIVATE\HARDWARE\MICROC~1\FINALO~1\RFM73.PBP	00042	Config_nrf con $00 'Config register address
; C:\REMOTE~1\PRIVATE\HARDWARE\MICROC~1\FINALO~1\RFM73.PBP	00043	En_aa con $01 'enable auto acknowledgment register address
; C:\REMOTE~1\PRIVATE\HARDWARE\MICROC~1\FINALO~1\RFM73.PBP	00044	En_rxaddr con $02 'enable RX addresses register address
; C:\REMOTE~1\PRIVATE\HARDWARE\MICROC~1\FINALO~1\RFM73.PBP	00045	Setup_aw con $03 'setup address width register address
; C:\REMOTE~1\PRIVATE\HARDWARE\MICROC~1\FINALO~1\RFM73.PBP	00046	Setup_retr con $04 'setup auto retrans register address
; C:\REMOTE~1\PRIVATE\HARDWARE\MICROC~1\FINALO~1\RFM73.PBP	00047	Rf_ch con $05 'RF channel register address
; C:\REMOTE~1\PRIVATE\HARDWARE\MICROC~1\FINALO~1\RFM73.PBP	00048	Rf_setup con $06 'RF setup register address
; C:\REMOTE~1\PRIVATE\HARDWARE\MICROC~1\FINALO~1\RFM73.PBP	00049	Stat_us con $07 'Status register address
; C:\REMOTE~1\PRIVATE\HARDWARE\MICROC~1\FINALO~1\RFM73.PBP	00050	Observe_tx con $08 'Observe TX register address
; C:\REMOTE~1\PRIVATE\HARDWARE\MICROC~1\FINALO~1\RFM73.PBP	00051	Cd con $09 'Carrier detect register address
; C:\REMOTE~1\PRIVATE\HARDWARE\MICROC~1\FINALO~1\RFM73.PBP	00052	Rx_addr_p0 con $0A 'RX address pipe0 register address
; C:\REMOTE~1\PRIVATE\HARDWARE\MICROC~1\FINALO~1\RFM73.PBP	00053	Rx_addr_p1 con $0B 'RX address pipe1 register address
; C:\REMOTE~1\PRIVATE\HARDWARE\MICROC~1\FINALO~1\RFM73.PBP	00054	Rx_addr_p2 con $0C 'RX address pipe2 register address
; C:\REMOTE~1\PRIVATE\HARDWARE\MICROC~1\FINALO~1\RFM73.PBP	00055	Rx_addr_p3 con $0D 'RX address pipe3 register address
; C:\REMOTE~1\PRIVATE\HARDWARE\MICROC~1\FINALO~1\RFM73.PBP	00056	Rx_addr_p4 con $0E 'RX address pipe4 register address
; C:\REMOTE~1\PRIVATE\HARDWARE\MICROC~1\FINALO~1\RFM73.PBP	00057	Rx_addr_p5 con $0F 'RX address pipe5 register address
; C:\REMOTE~1\PRIVATE\HARDWARE\MICROC~1\FINALO~1\RFM73.PBP	00058	Tx_addr con $10 'TX address register address
; C:\REMOTE~1\PRIVATE\HARDWARE\MICROC~1\FINALO~1\RFM73.PBP	00059	Rx_pw_p0 con $11 'RX payload width pipe0 register address
; C:\REMOTE~1\PRIVATE\HARDWARE\MICROC~1\FINALO~1\RFM73.PBP	00060	Rx_pw_p1 con $12 'RX payload width pipe1 register address
; C:\REMOTE~1\PRIVATE\HARDWARE\MICROC~1\FINALO~1\RFM73.PBP	00061	Rx_pw_p2 con $13 'RX payload width pipe2 register address
; C:\REMOTE~1\PRIVATE\HARDWARE\MICROC~1\FINALO~1\RFM73.PBP	00062	Rx_pw_p3 con $14 'RX payload width pipe3 register address
; C:\REMOTE~1\PRIVATE\HARDWARE\MICROC~1\FINALO~1\RFM73.PBP	00063	Rx_pw_p4 con $15 'RX payload width pipe4 register address
; C:\REMOTE~1\PRIVATE\HARDWARE\MICROC~1\FINALO~1\RFM73.PBP	00064	Rx_pw_p5 con $16 'RX payload width pipe5 register address
; C:\REMOTE~1\PRIVATE\HARDWARE\MICROC~1\FINALO~1\RFM73.PBP	00065	Fifo_status con $17 'FIFO status register register address

; C:\REMOTE~1\PRIVATE\HARDWARE\MICROC~1\FINALO~1\RFM73.PBP	00067	goto endRFM73
	GOTO?L	_endRFM73

; C:\REMOTE~1\PRIVATE\HARDWARE\MICROC~1\FINALO~1\RFM73.PBP	00068	initModule:

	LABEL?L	_initModule	

; C:\REMOTE~1\PRIVATE\HARDWARE\MICROC~1\FINALO~1\RFM73.PBP	00069	pause 200
	PAUSE?C	0C8h

; C:\REMOTE~1\PRIVATE\HARDWARE\MICROC~1\FINALO~1\RFM73.PBP	00071	SSPEN = 1 'enable SPI pins
	MOVE?CT	001h, _SSPEN

; C:\REMOTE~1\PRIVATE\HARDWARE\MICROC~1\FINALO~1\RFM73.PBP	00072	SSPCON.0=1 'SPI rate=OSC/16
	MOVE?CT	001h, _SSPCON??0

; C:\REMOTE~1\PRIVATE\HARDWARE\MICROC~1\FINALO~1\RFM73.PBP	00073	CKP = 0 'clock idle low
	MOVE?CT	000h, _CKP

; C:\REMOTE~1\PRIVATE\HARDWARE\MICROC~1\FINALO~1\RFM73.PBP	00074	CKE = 1 'transmit on active to idle
	MOVE?CT	001h, _CKE

; C:\REMOTE~1\PRIVATE\HARDWARE\MICROC~1\FINALO~1\RFM73.PBP	00075	SSPIF = 0 'clear buffer full status
	MOVE?CT	000h, _SSPIF

; C:\REMOTE~1\PRIVATE\HARDWARE\MICROC~1\FINALO~1\RFM73.PBP	00076	SMP = 0 'sample in middle of data
	MOVE?CT	000h, _SMP

; C:\REMOTE~1\PRIVATE\HARDWARE\MICROC~1\FINALO~1\RFM73.PBP	00078	Ce=1 'init spi pins
	MOVE?CT	001h, _Ce

; C:\REMOTE~1\PRIVATE\HARDWARE\MICROC~1\FINALO~1\RFM73.PBP	00079	pause 10 'wait 10 ms hardware is stable
	PAUSE?C	00Ah

; C:\REMOTE~1\PRIVATE\HARDWARE\MICROC~1\FINALO~1\RFM73.PBP	00080	Ce=0 'set CE pin low disable Rx
	MOVE?CT	000h, _Ce

; C:\REMOTE~1\PRIVATE\HARDWARE\MICROC~1\FINALO~1\RFM73.PBP	00081	CSN=0 'set CSN pin low
	MOVE?CT	000h, _CSN

; C:\REMOTE~1\PRIVATE\HARDWARE\MICROC~1\FINALO~1\RFM73.PBP	00082	Pack_count=0 'number of packets sent
	MOVE?CW	000h, _Pack_count

; C:\REMOTE~1\PRIVATE\HARDWARE\MICROC~1\FINALO~1\RFM73.PBP	00083	return
	RETURN?	

; C:\REMOTE~1\PRIVATE\HARDWARE\MICROC~1\FINALO~1\RFM73.PBP	00085	commonRXTX:

	LABEL?L	_commonRXTX	

; C:\REMOTE~1\PRIVATE\HARDWARE\MICROC~1\FINALO~1\RFM73.PBP	00086	data_out[0]=Write_reg+Rx_addr_p0 'Rx address for pipe0
	MOVE?CB	02Ah, _data_out

; C:\REMOTE~1\PRIVATE\HARDWARE\MICROC~1\FINALO~1\RFM73.PBP	00087	gosub setRxAddressPipe
	GOSUB?L	_setRxAddressPipe

; C:\REMOTE~1\PRIVATE\HARDWARE\MICROC~1\FINALO~1\RFM73.PBP	00088	num_byte=5
	MOVE?CB	005h, _num_byte

; C:\REMOTE~1\PRIVATE\HARDWARE\MICROC~1\FINALO~1\RFM73.PBP	00089	gosub spi_write
	GOSUB?L	_spi_write

; C:\REMOTE~1\PRIVATE\HARDWARE\MICROC~1\FINALO~1\RFM73.PBP	00090	data_out[0]=Write_reg+En_aa 'enable auto ACK pipe0
	MOVE?CB	021h, _data_out

; C:\REMOTE~1\PRIVATE\HARDWARE\MICROC~1\FINALO~1\RFM73.PBP	00091	data_out[1]=$01 '1 enable, 0 disable
	MOVE?CB	001h, _data_out + 00001h

; C:\REMOTE~1\PRIVATE\HARDWARE\MICROC~1\FINALO~1\RFM73.PBP	00092	num_byte=1
	MOVE?CB	001h, _num_byte

; C:\REMOTE~1\PRIVATE\HARDWARE\MICROC~1\FINALO~1\RFM73.PBP	00093	gosub spi_write
	GOSUB?L	_spi_write

; C:\REMOTE~1\PRIVATE\HARDWARE\MICROC~1\FINALO~1\RFM73.PBP	00094	data_out[0]=Write_reg+En_rxaddr 'enable Rx address pipe0
	MOVE?CB	022h, _data_out

; C:\REMOTE~1\PRIVATE\HARDWARE\MICROC~1\FINALO~1\RFM73.PBP	00095	data_out[1]=$01
	MOVE?CB	001h, _data_out + 00001h

; C:\REMOTE~1\PRIVATE\HARDWARE\MICROC~1\FINALO~1\RFM73.PBP	00096	num_byte=1
	MOVE?CB	001h, _num_byte

; C:\REMOTE~1\PRIVATE\HARDWARE\MICROC~1\FINALO~1\RFM73.PBP	00097	gosub spi_write
	GOSUB?L	_spi_write

; C:\REMOTE~1\PRIVATE\HARDWARE\MICROC~1\FINALO~1\RFM73.PBP	00098	data_out[0]=Write_reg+Rf_ch 'Set RF channel
	MOVE?CB	025h, _data_out

; C:\REMOTE~1\PRIVATE\HARDWARE\MICROC~1\FINALO~1\RFM73.PBP	00099	READ 0, data_out[1] 'number of channel used
	READADDRESS?C	000h
	READ?B	_data_out + 00001h

; C:\REMOTE~1\PRIVATE\HARDWARE\MICROC~1\FINALO~1\RFM73.PBP	00100	num_byte=1
	MOVE?CB	001h, _num_byte

; C:\REMOTE~1\PRIVATE\HARDWARE\MICROC~1\FINALO~1\RFM73.PBP	00101	gosub spi_write
	GOSUB?L	_spi_write

; C:\REMOTE~1\PRIVATE\HARDWARE\MICROC~1\FINALO~1\RFM73.PBP	00102	data_out[0]=Write_reg+Rx_pw_p0 'Set Rx pload width pipe0
	MOVE?CB	031h, _data_out

; C:\REMOTE~1\PRIVATE\HARDWARE\MICROC~1\FINALO~1\RFM73.PBP	00103	data_out[1]=payloadLength 'number of bytes used in data sent
	MOVE?CB	_payloadLength, _data_out + 00001h

; C:\REMOTE~1\PRIVATE\HARDWARE\MICROC~1\FINALO~1\RFM73.PBP	00104	num_byte=1
	MOVE?CB	001h, _num_byte

; C:\REMOTE~1\PRIVATE\HARDWARE\MICROC~1\FINALO~1\RFM73.PBP	00105	gosub spi_write
	GOSUB?L	_spi_write

; C:\REMOTE~1\PRIVATE\HARDWARE\MICROC~1\FINALO~1\RFM73.PBP	00106	data_out[0]=Write_reg+Rf_setup 'Set RF: 'Set RF:5dbm, 1Mbps
	MOVE?CB	026h, _data_out

; C:\REMOTE~1\PRIVATE\HARDWARE\MICROC~1\FINALO~1\RFM73.PBP	00108	 data_out[1]=%00000111 '1mbit
	MOVE?CB	007h, _data_out + 00001h

; C:\REMOTE~1\PRIVATE\HARDWARE\MICROC~1\FINALO~1\RFM73.PBP	00109	num_byte=1
	MOVE?CB	001h, _num_byte

; C:\REMOTE~1\PRIVATE\HARDWARE\MICROC~1\FINALO~1\RFM73.PBP	00110	gosub spi_write
	GOSUB?L	_spi_write

; C:\REMOTE~1\PRIVATE\HARDWARE\MICROC~1\FINALO~1\RFM73.PBP	00112	temp_byte_rfm = 1
	MOVE?CB	001h, _temp_byte_rfm

; C:\REMOTE~1\PRIVATE\HARDWARE\MICROC~1\FINALO~1\RFM73.PBP	00113	gosub setBank
	GOSUB?L	_setBank

; C:\REMOTE~1\PRIVATE\HARDWARE\MICROC~1\FINALO~1\RFM73.PBP	00114	temp_byte_rfm = 0 : temp1_byte_rfm = $40 : temp2_byte_rfm = $4B : temp3_byte_rfm = $01 : temp4_byte_rfm = $E2
	MOVE?CB	000h, _temp_byte_rfm

; C:\REMOTE~1\PRIVATE\HARDWARE\MICROC~1\FINALO~1\RFM73.PBP	00114	temp_byte_rfm = 0 : temp1_byte_rfm = $40 : temp2_byte_rfm = $4B : temp3_byte_rfm = $01 : temp4_byte_rfm = $E2
	MOVE?CB	040h, _temp1_byte_rfm

; C:\REMOTE~1\PRIVATE\HARDWARE\MICROC~1\FINALO~1\RFM73.PBP	00114	temp_byte_rfm = 0 : temp1_byte_rfm = $40 : temp2_byte_rfm = $4B : temp3_byte_rfm = $01 : temp4_byte_rfm = $E2
	MOVE?CB	04Bh, _temp2_byte_rfm

; C:\REMOTE~1\PRIVATE\HARDWARE\MICROC~1\FINALO~1\RFM73.PBP	00114	temp_byte_rfm = 0 : temp1_byte_rfm = $40 : temp2_byte_rfm = $4B : temp3_byte_rfm = $01 : temp4_byte_rfm = $E2
	MOVE?CB	001h, _temp3_byte_rfm

; C:\REMOTE~1\PRIVATE\HARDWARE\MICROC~1\FINALO~1\RFM73.PBP	00114	temp_byte_rfm = 0 : temp1_byte_rfm = $40 : temp2_byte_rfm = $4B : temp3_byte_rfm = $01 : temp4_byte_rfm = $E2
	MOVE?CB	0E2h, _temp4_byte_rfm

; C:\REMOTE~1\PRIVATE\HARDWARE\MICROC~1\FINALO~1\RFM73.PBP	00115	gosub conf4bytes
	GOSUB?L	_conf4bytes

; C:\REMOTE~1\PRIVATE\HARDWARE\MICROC~1\FINALO~1\RFM73.PBP	00116	temp_byte_rfm = 1 : temp1_byte_rfm = $C0 : temp2_byte_rfm = $4B : temp3_byte_rfm = $00 : temp4_byte_rfm = $00
	MOVE?CB	001h, _temp_byte_rfm

; C:\REMOTE~1\PRIVATE\HARDWARE\MICROC~1\FINALO~1\RFM73.PBP	00116	temp_byte_rfm = 1 : temp1_byte_rfm = $C0 : temp2_byte_rfm = $4B : temp3_byte_rfm = $00 : temp4_byte_rfm = $00
	MOVE?CB	0C0h, _temp1_byte_rfm

; C:\REMOTE~1\PRIVATE\HARDWARE\MICROC~1\FINALO~1\RFM73.PBP	00116	temp_byte_rfm = 1 : temp1_byte_rfm = $C0 : temp2_byte_rfm = $4B : temp3_byte_rfm = $00 : temp4_byte_rfm = $00
	MOVE?CB	04Bh, _temp2_byte_rfm

; C:\REMOTE~1\PRIVATE\HARDWARE\MICROC~1\FINALO~1\RFM73.PBP	00116	temp_byte_rfm = 1 : temp1_byte_rfm = $C0 : temp2_byte_rfm = $4B : temp3_byte_rfm = $00 : temp4_byte_rfm = $00
	MOVE?CB	000h, _temp3_byte_rfm

; C:\REMOTE~1\PRIVATE\HARDWARE\MICROC~1\FINALO~1\RFM73.PBP	00116	temp_byte_rfm = 1 : temp1_byte_rfm = $C0 : temp2_byte_rfm = $4B : temp3_byte_rfm = $00 : temp4_byte_rfm = $00
	MOVE?CB	000h, _temp4_byte_rfm

; C:\REMOTE~1\PRIVATE\HARDWARE\MICROC~1\FINALO~1\RFM73.PBP	00117	gosub conf4bytes
	GOSUB?L	_conf4bytes

; C:\REMOTE~1\PRIVATE\HARDWARE\MICROC~1\FINALO~1\RFM73.PBP	00118	temp_byte_rfm = 2 : temp1_byte_rfm = $D0 : temp2_byte_rfm = $FC : temp3_byte_rfm = $8C : temp4_byte_rfm = $02
	MOVE?CB	002h, _temp_byte_rfm

; C:\REMOTE~1\PRIVATE\HARDWARE\MICROC~1\FINALO~1\RFM73.PBP	00118	temp_byte_rfm = 2 : temp1_byte_rfm = $D0 : temp2_byte_rfm = $FC : temp3_byte_rfm = $8C : temp4_byte_rfm = $02
	MOVE?CB	0D0h, _temp1_byte_rfm

; C:\REMOTE~1\PRIVATE\HARDWARE\MICROC~1\FINALO~1\RFM73.PBP	00118	temp_byte_rfm = 2 : temp1_byte_rfm = $D0 : temp2_byte_rfm = $FC : temp3_byte_rfm = $8C : temp4_byte_rfm = $02
	MOVE?CB	0FCh, _temp2_byte_rfm

; C:\REMOTE~1\PRIVATE\HARDWARE\MICROC~1\FINALO~1\RFM73.PBP	00118	temp_byte_rfm = 2 : temp1_byte_rfm = $D0 : temp2_byte_rfm = $FC : temp3_byte_rfm = $8C : temp4_byte_rfm = $02
	MOVE?CB	08Ch, _temp3_byte_rfm

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
	MOVE?CB	012h, _temp2_byte_rfm

; C:\REMOTE~1\PRIVATE\HARDWARE\MICROC~1\FINALO~1\RFM73.PBP	00126	temp_byte_rfm = 12 : temp1_byte_rfm = $00 : temp2_byte_rfm = $12 : temp3_byte_rfm = $73 : temp4_byte_rfm = $00
	MOVE?CB	073h, _temp3_byte_rfm

; C:\REMOTE~1\PRIVATE\HARDWARE\MICROC~1\FINALO~1\RFM73.PBP	00126	temp_byte_rfm = 12 : temp1_byte_rfm = $00 : temp2_byte_rfm = $12 : temp3_byte_rfm = $73 : temp4_byte_rfm = $00
	MOVE?CB	000h, _temp4_byte_rfm

; C:\REMOTE~1\PRIVATE\HARDWARE\MICROC~1\FINALO~1\RFM73.PBP	00127	gosub conf4bytes
	GOSUB?L	_conf4bytes

; C:\REMOTE~1\PRIVATE\HARDWARE\MICROC~1\FINALO~1\RFM73.PBP	00128	temp_byte_rfm = 13 : temp1_byte_rfm = $46 : temp2_byte_rfm = $b4 : temp3_byte_rfm = $80 : temp4_byte_rfm = $00
	MOVE?CB	00Dh, _temp_byte_rfm

; C:\REMOTE~1\PRIVATE\HARDWARE\MICROC~1\FINALO~1\RFM73.PBP	00128	temp_byte_rfm = 13 : temp1_byte_rfm = $46 : temp2_byte_rfm = $b4 : temp3_byte_rfm = $80 : temp4_byte_rfm = $00
	MOVE?CB	046h, _temp1_byte_rfm

; C:\REMOTE~1\PRIVATE\HARDWARE\MICROC~1\FINALO~1\RFM73.PBP	00128	temp_byte_rfm = 13 : temp1_byte_rfm = $46 : temp2_byte_rfm = $b4 : temp3_byte_rfm = $80 : temp4_byte_rfm = $00
	MOVE?CB	0B4h, _temp2_byte_rfm

; C:\REMOTE~1\PRIVATE\HARDWARE\MICROC~1\FINALO~1\RFM73.PBP	00128	temp_byte_rfm = 13 : temp1_byte_rfm = $46 : temp2_byte_rfm = $b4 : temp3_byte_rfm = $80 : temp4_byte_rfm = $00
	MOVE?CB	080h, _temp3_byte_rfm

; C:\REMOTE~1\PRIVATE\HARDWARE\MICROC~1\FINALO~1\RFM73.PBP	00128	temp_byte_rfm = 13 : temp1_byte_rfm = $46 : temp2_byte_rfm = $b4 : temp3_byte_rfm = $80 : temp4_byte_rfm = $00
	MOVE?CB	000h, _temp4_byte_rfm

; C:\REMOTE~1\PRIVATE\HARDWARE\MICROC~1\FINALO~1\RFM73.PBP	00129	gosub conf4bytes
	GOSUB?L	_conf4bytes

; C:\REMOTE~1\PRIVATE\HARDWARE\MICROC~1\FINALO~1\RFM73.PBP	00130	data_out[0]=Write_reg+$0E
	MOVE?CB	02Eh, _data_out

; C:\REMOTE~1\PRIVATE\HARDWARE\MICROC~1\FINALO~1\RFM73.PBP	00131	data_out[1]=$41
	MOVE?CB	041h, _data_out + 00001h

; C:\REMOTE~1\PRIVATE\HARDWARE\MICROC~1\FINALO~1\RFM73.PBP	00132	data_out[2]=$20
	MOVE?CB	020h, _data_out + 00002h

; C:\REMOTE~1\PRIVATE\HARDWARE\MICROC~1\FINALO~1\RFM73.PBP	00133	data_out[3]=$08
	MOVE?CB	008h, _data_out + 00003h

; C:\REMOTE~1\PRIVATE\HARDWARE\MICROC~1\FINALO~1\RFM73.PBP	00134	data_out[4]=$04
	MOVE?CB	004h, _data_out + 00004h

; C:\REMOTE~1\PRIVATE\HARDWARE\MICROC~1\FINALO~1\RFM73.PBP	00135	data_out[5]=$81
	MOVE?CB	081h, _data_out + 00005h

; C:\REMOTE~1\PRIVATE\HARDWARE\MICROC~1\FINALO~1\RFM73.PBP	00136	data_out[6]=$20
	MOVE?CB	020h, _data_out + 00006h

; C:\REMOTE~1\PRIVATE\HARDWARE\MICROC~1\FINALO~1\RFM73.PBP	00137	data_out[7]=$CF
	MOVE?CB	0CFh, _data_out + 00007h

; C:\REMOTE~1\PRIVATE\HARDWARE\MICROC~1\FINALO~1\RFM73.PBP	00138	data_out[8]=$F7
	MOVE?CB	0F7h, _data_out + 00008h

; C:\REMOTE~1\PRIVATE\HARDWARE\MICROC~1\FINALO~1\RFM73.PBP	00139	data_out[9]=$FE
	MOVE?CB	0FEh, _data_out + 00009h

; C:\REMOTE~1\PRIVATE\HARDWARE\MICROC~1\FINALO~1\RFM73.PBP	00140	data_out[10]=$FF
	MOVE?CB	0FFh, _data_out + 0000Ah

; C:\REMOTE~1\PRIVATE\HARDWARE\MICROC~1\FINALO~1\RFM73.PBP	00141	data_out[11]=$FF
	MOVE?CB	0FFh, _data_out + 0000Bh

; C:\REMOTE~1\PRIVATE\HARDWARE\MICROC~1\FINALO~1\RFM73.PBP	00142	num_byte=11
	MOVE?CB	00Bh, _num_byte

; C:\REMOTE~1\PRIVATE\HARDWARE\MICROC~1\FINALO~1\RFM73.PBP	00143	gosub spi_write
	GOSUB?L	_spi_write

; C:\REMOTE~1\PRIVATE\HARDWARE\MICROC~1\FINALO~1\RFM73.PBP	00144	temp_byte_rfm = 0
	MOVE?CB	000h, _temp_byte_rfm

; C:\REMOTE~1\PRIVATE\HARDWARE\MICROC~1\FINALO~1\RFM73.PBP	00145	gosub setBank
	GOSUB?L	_setBank

; C:\REMOTE~1\PRIVATE\HARDWARE\MICROC~1\FINALO~1\RFM73.PBP	00146	return
	RETURN?	

; C:\REMOTE~1\PRIVATE\HARDWARE\MICROC~1\FINALO~1\RFM73.PBP	00148	setBank:

	LABEL?L	_setBank	

; C:\REMOTE~1\PRIVATE\HARDWARE\MICROC~1\FINALO~1\RFM73.PBP	00149	data_out[0]=Read_reg+$07
	MOVE?CB	007h, _data_out

; C:\REMOTE~1\PRIVATE\HARDWARE\MICROC~1\FINALO~1\RFM73.PBP	00150	num_byte=1
	MOVE?CB	001h, _num_byte

; C:\REMOTE~1\PRIVATE\HARDWARE\MICROC~1\FINALO~1\RFM73.PBP	00151	gosub spi_read
	GOSUB?L	_spi_read

; C:\REMOTE~1\PRIVATE\HARDWARE\MICROC~1\FINALO~1\RFM73.PBP	00152	if (temp_byte_rfm != (data_in[0] & $80)) then
	AND?BCW	_data_in, 080h, T1
	CMPEQ?BWL	_temp_byte_rfm, T1, L00003

; C:\REMOTE~1\PRIVATE\HARDWARE\MICROC~1\FINALO~1\RFM73.PBP	00154	    data_out[0]=$50
	MOVE?CB	050h, _data_out

; C:\REMOTE~1\PRIVATE\HARDWARE\MICROC~1\FINALO~1\RFM73.PBP	00155	    data_out[1]=$53    
	MOVE?CB	053h, _data_out + 00001h

; C:\REMOTE~1\PRIVATE\HARDWARE\MICROC~1\FINALO~1\RFM73.PBP	00156	    num_byte=1
	MOVE?CB	001h, _num_byte

; C:\REMOTE~1\PRIVATE\HARDWARE\MICROC~1\FINALO~1\RFM73.PBP	00157	    gosub spi_write
	GOSUB?L	_spi_write

; C:\REMOTE~1\PRIVATE\HARDWARE\MICROC~1\FINALO~1\RFM73.PBP	00158	endif
	LABEL?L	L00003	

; C:\REMOTE~1\PRIVATE\HARDWARE\MICROC~1\FINALO~1\RFM73.PBP	00159	return
	RETURN?	

; C:\REMOTE~1\PRIVATE\HARDWARE\MICROC~1\FINALO~1\RFM73.PBP	00161	conf4bytes:

	LABEL?L	_conf4bytes	

; C:\REMOTE~1\PRIVATE\HARDWARE\MICROC~1\FINALO~1\RFM73.PBP	00162	data_out[0]=Write_reg+temp_byte_rfm
	ADD?CBB	_Write_reg, _temp_byte_rfm, _data_out

; C:\REMOTE~1\PRIVATE\HARDWARE\MICROC~1\FINALO~1\RFM73.PBP	00163	data_out[1]=temp1_byte_rfm
	MOVE?BB	_temp1_byte_rfm, _data_out + 00001h

; C:\REMOTE~1\PRIVATE\HARDWARE\MICROC~1\FINALO~1\RFM73.PBP	00164	data_out[2]=temp2_byte_rfm
	MOVE?BB	_temp2_byte_rfm, _data_out + 00002h

; C:\REMOTE~1\PRIVATE\HARDWARE\MICROC~1\FINALO~1\RFM73.PBP	00165	data_out[3]=temp3_byte_rfm
	MOVE?BB	_temp3_byte_rfm, _data_out + 00003h

; C:\REMOTE~1\PRIVATE\HARDWARE\MICROC~1\FINALO~1\RFM73.PBP	00166	data_out[4]=temp4_byte_rfm
	MOVE?BB	_temp4_byte_rfm, _data_out + 00004h

; C:\REMOTE~1\PRIVATE\HARDWARE\MICROC~1\FINALO~1\RFM73.PBP	00167	num_byte=4
	MOVE?CB	004h, _num_byte

; C:\REMOTE~1\PRIVATE\HARDWARE\MICROC~1\FINALO~1\RFM73.PBP	00168	gosub spi_write
	GOSUB?L	_spi_write

; C:\REMOTE~1\PRIVATE\HARDWARE\MICROC~1\FINALO~1\RFM73.PBP	00169	return
	RETURN?	

; C:\REMOTE~1\PRIVATE\HARDWARE\MICROC~1\FINALO~1\RFM73.PBP	00171	sendData:

	LABEL?L	_sendData	

; C:\REMOTE~1\PRIVATE\HARDWARE\MICROC~1\FINALO~1\RFM73.PBP	00172	pause 30
	PAUSE?C	01Eh

; C:\REMOTE~1\PRIVATE\HARDWARE\MICROC~1\FINALO~1\RFM73.PBP	00173	GOSUB debounce
	GOSUB?L	_debounce

; C:\REMOTE~1\PRIVATE\HARDWARE\MICROC~1\FINALO~1\RFM73.PBP	00174	data_out[0]=Flush_tx 'flush TX_fifo buffer
	MOVE?CB	_Flush_tx, _data_out

; C:\REMOTE~1\PRIVATE\HARDWARE\MICROC~1\FINALO~1\RFM73.PBP	00175	num_byte=0
	MOVE?CB	000h, _num_byte

; C:\REMOTE~1\PRIVATE\HARDWARE\MICROC~1\FINALO~1\RFM73.PBP	00176	gosub spi_write
	GOSUB?L	_spi_write

; C:\REMOTE~1\PRIVATE\HARDWARE\MICROC~1\FINALO~1\RFM73.PBP	00177	data_out[0]=Write_reg+Stat_us 'reset IRQ bits
	MOVE?CB	027h, _data_out

; C:\REMOTE~1\PRIVATE\HARDWARE\MICROC~1\FINALO~1\RFM73.PBP	00178	data_out[1]=%00110000
	MOVE?CB	030h, _data_out + 00001h

; C:\REMOTE~1\PRIVATE\HARDWARE\MICROC~1\FINALO~1\RFM73.PBP	00179	num_byte=1
	MOVE?CB	001h, _num_byte

; C:\REMOTE~1\PRIVATE\HARDWARE\MICROC~1\FINALO~1\RFM73.PBP	00180	gosub spi_write
	GOSUB?L	_spi_write

; C:\REMOTE~1\PRIVATE\HARDWARE\MICROC~1\FINALO~1\RFM73.PBP	00181	gosub setup_tx 'setup Tx
	GOSUB?L	_setup_tx

; C:\REMOTE~1\PRIVATE\HARDWARE\MICROC~1\FINALO~1\RFM73.PBP	00182	data_out[0]=Wr_tx_pload 'put 10 bytes data in Tx pload buffer
	MOVE?CB	_Wr_tx_pload, _data_out

; C:\REMOTE~1\PRIVATE\HARDWARE\MICROC~1\FINALO~1\RFM73.PBP	00183	data_out[1]=device_id
	MOVE?BB	_device_id, _data_out + 00001h

; C:\REMOTE~1\PRIVATE\HARDWARE\MICROC~1\FINALO~1\RFM73.PBP	00184	for w = 2 to payloadLength+1
	MOVE?CB	002h, _w
	LABEL?L	L00005	
	CMPGT?BCL	_w, 017h, L00006

; C:\REMOTE~1\PRIVATE\HARDWARE\MICROC~1\FINALO~1\RFM73.PBP	00185	    data_out[w]=temp_data[w-2]
	SUB?BCW	_w, 002h, T1
	AOUT?BWB	_temp_data, T1, T1
	AIN?BBB	T1, _data_out, _w

; C:\REMOTE~1\PRIVATE\HARDWARE\MICROC~1\FINALO~1\RFM73.PBP	00186	    if data_out[w] == 10 then contSendX1
	AOUT?BBB	_data_out, _w, T1
	CMPEQ?BCL	T1, 00Ah, _contSendX1

; C:\REMOTE~1\PRIVATE\HARDWARE\MICROC~1\FINALO~1\RFM73.PBP	00187	next w
	NEXT?BCL	_w, 001h, L00005
	LABEL?L	L00006	

; C:\REMOTE~1\PRIVATE\HARDWARE\MICROC~1\FINALO~1\RFM73.PBP	00188	:contSendX1

	LABEL?L	_contSendX1	

; C:\REMOTE~1\PRIVATE\HARDWARE\MICROC~1\FINALO~1\RFM73.PBP	00189	num_byte=payloadLength
	MOVE?CB	_payloadLength, _num_byte

; C:\REMOTE~1\PRIVATE\HARDWARE\MICROC~1\FINALO~1\RFM73.PBP	00190	gosub spi_write
	GOSUB?L	_spi_write

; C:\REMOTE~1\PRIVATE\HARDWARE\MICROC~1\FINALO~1\RFM73.PBP	00191	pauseus 500 'pause 500 us
	PAUSEUS?C	001F4h

; C:\REMOTE~1\PRIVATE\HARDWARE\MICROC~1\FINALO~1\RFM73.PBP	00192	Ce=1 'CE=1 (toggle) transmit FIFO buffer
	MOVE?CT	001h, _Ce

; C:\REMOTE~1\PRIVATE\HARDWARE\MICROC~1\FINALO~1\RFM73.PBP	00193	Pauseus 500 'pause 500 us
	PAUSEUS?C	001F4h

; C:\REMOTE~1\PRIVATE\HARDWARE\MICROC~1\FINALO~1\RFM73.PBP	00194	Ce=0
	MOVE?CT	000h, _Ce

; C:\REMOTE~1\PRIVATE\HARDWARE\MICROC~1\FINALO~1\RFM73.PBP	00195	Pause 1
	PAUSE?C	001h

; C:\REMOTE~1\PRIVATE\HARDWARE\MICROC~1\FINALO~1\RFM73.PBP	00196	trans_irq:

	LABEL?L	_trans_irq	

; C:\REMOTE~1\PRIVATE\HARDWARE\MICROC~1\FINALO~1\RFM73.PBP	00197	If Irq !=0 then trans_irq 'wait until IRQ, active low
	CMPNE?TCL	_Irq, 000h, _trans_irq

; C:\REMOTE~1\PRIVATE\HARDWARE\MICROC~1\FINALO~1\RFM73.PBP	00198	data_out[0]=Stat_us 'read status register
	MOVE?CB	_Stat_us, _data_out

; C:\REMOTE~1\PRIVATE\HARDWARE\MICROC~1\FINALO~1\RFM73.PBP	00199	num_byte=1
	MOVE?CB	001h, _num_byte

; C:\REMOTE~1\PRIVATE\HARDWARE\MICROC~1\FINALO~1\RFM73.PBP	00200	gosub spi_read
	GOSUB?L	_spi_read

; C:\REMOTE~1\PRIVATE\HARDWARE\MICROC~1\FINALO~1\RFM73.PBP	00201	val=data_in[0]&%01110000 'mask the IRQ bits STATUS byte
	AND?BCB	_data_in, 070h, _val

; C:\REMOTE~1\PRIVATE\HARDWARE\MICROC~1\FINALO~1\RFM73.PBP	00202	if (val = Max_rt) then gosub max_retry 'maximum TX retries
	CMPNE?BCL	_val, _Max_rt, L00007
	GOSUB?L	_max_retry
	LABEL?L	L00007	

; C:\REMOTE~1\PRIVATE\HARDWARE\MICROC~1\FINALO~1\RFM73.PBP	00203	if (val = Tx_inter) then gosub tx_int 'Tx interrupted
	CMPNE?BCL	_val, _Tx_inter, L00009
	GOSUB?L	_tx_int
	LABEL?L	L00009	

; C:\REMOTE~1\PRIVATE\HARDWARE\MICROC~1\FINALO~1\RFM73.PBP	00204	data_out[0]=Write_reg+Stat_us
	MOVE?CB	027h, _data_out

; C:\REMOTE~1\PRIVATE\HARDWARE\MICROC~1\FINALO~1\RFM73.PBP	00205	data_out[1]=%00100000 'clear TX_DS IRQ bit
	MOVE?CB	020h, _data_out + 00001h

; C:\REMOTE~1\PRIVATE\HARDWARE\MICROC~1\FINALO~1\RFM73.PBP	00206	num_byte=1
	MOVE?CB	001h, _num_byte

; C:\REMOTE~1\PRIVATE\HARDWARE\MICROC~1\FINALO~1\RFM73.PBP	00207	gosub spi_write
	GOSUB?L	_spi_write

; C:\REMOTE~1\PRIVATE\HARDWARE\MICROC~1\FINALO~1\RFM73.PBP	00208	gosub debounce
	GOSUB?L	_debounce

; C:\REMOTE~1\PRIVATE\HARDWARE\MICROC~1\FINALO~1\RFM73.PBP	00209	return
	RETURN?	

; C:\REMOTE~1\PRIVATE\HARDWARE\MICROC~1\FINALO~1\RFM73.PBP	00212	debounce:

	LABEL?L	_debounce	

; C:\REMOTE~1\PRIVATE\HARDWARE\MICROC~1\FINALO~1\RFM73.PBP	00213	Ce=0
	MOVE?CT	000h, _Ce

; C:\REMOTE~1\PRIVATE\HARDWARE\MICROC~1\FINALO~1\RFM73.PBP	00214	pauseus 500
	PAUSEUS?C	001F4h

; C:\REMOTE~1\PRIVATE\HARDWARE\MICROC~1\FINALO~1\RFM73.PBP	00215	Ce=1
	MOVE?CT	001h, _Ce

; C:\REMOTE~1\PRIVATE\HARDWARE\MICROC~1\FINALO~1\RFM73.PBP	00216	pauseus 500
	PAUSEUS?C	001F4h

; C:\REMOTE~1\PRIVATE\HARDWARE\MICROC~1\FINALO~1\RFM73.PBP	00217	Ce=0
	MOVE?CT	000h, _Ce

; C:\REMOTE~1\PRIVATE\HARDWARE\MICROC~1\FINALO~1\RFM73.PBP	00218	pauseus 500
	PAUSEUS?C	001F4h

; C:\REMOTE~1\PRIVATE\HARDWARE\MICROC~1\FINALO~1\RFM73.PBP	00219	return
	RETURN?	

; C:\REMOTE~1\PRIVATE\HARDWARE\MICROC~1\FINALO~1\RFM73.PBP	00221	spi_write:

	LABEL?L	_spi_write	

; C:\REMOTE~1\PRIVATE\HARDWARE\MICROC~1\FINALO~1\RFM73.PBP	00222	CSN=0
	MOVE?CT	000h, _CSN

; C:\REMOTE~1\PRIVATE\HARDWARE\MICROC~1\FINALO~1\RFM73.PBP	00223	For w = 0 to num_byte 'loop for # byte
	MOVE?CB	000h, _w
	LABEL?L	L00011	
	CMPGT?BBL	_w, _num_byte, L00012

; C:\REMOTE~1\PRIVATE\HARDWARE\MICROC~1\FINALO~1\RFM73.PBP	00224	SSPBUF=data_out[w] 'send array variable
	AOUT?BBB	_data_out, _w, SSPBUF

; C:\REMOTE~1\PRIVATE\HARDWARE\MICROC~1\FINALO~1\RFM73.PBP	00225	GoSub buffer_ok 'wait until buffer ready
	GOSUB?L	_buffer_ok

; C:\REMOTE~1\PRIVATE\HARDWARE\MICROC~1\FINALO~1\RFM73.PBP	00226	Next w 'next location
	NEXT?BCL	_w, 001h, L00011
	LABEL?L	L00012	

; C:\REMOTE~1\PRIVATE\HARDWARE\MICROC~1\FINALO~1\RFM73.PBP	00227	CSN=1
	MOVE?CT	001h, _CSN

; C:\REMOTE~1\PRIVATE\HARDWARE\MICROC~1\FINALO~1\RFM73.PBP	00228	return
	RETURN?	

; C:\REMOTE~1\PRIVATE\HARDWARE\MICROC~1\FINALO~1\RFM73.PBP	00230	spi_read:

	LABEL?L	_spi_read	

; C:\REMOTE~1\PRIVATE\HARDWARE\MICROC~1\FINALO~1\RFM73.PBP	00231	CSN=0
	MOVE?CT	000h, _CSN

; C:\REMOTE~1\PRIVATE\HARDWARE\MICROC~1\FINALO~1\RFM73.PBP	00232	For w = 0 to num_byte 'loop for # byte
	MOVE?CB	000h, _w
	LABEL?L	L00013	
	CMPGT?BBL	_w, _num_byte, L00014

; C:\REMOTE~1\PRIVATE\HARDWARE\MICROC~1\FINALO~1\RFM73.PBP	00233	    SSPBUF = data_out[0] 'write to SSPBUF to start clock
	MOVE?BB	_data_out, SSPBUF

; C:\REMOTE~1\PRIVATE\HARDWARE\MICROC~1\FINALO~1\RFM73.PBP	00234	    GoSub buffer_ok 'wait for receipt
	GOSUB?L	_buffer_ok

; C:\REMOTE~1\PRIVATE\HARDWARE\MICROC~1\FINALO~1\RFM73.PBP	00235	data_in[w] = SSPBUF 'store received character in array
	AIN?BBB	SSPBUF, _data_in, _w

; C:\REMOTE~1\PRIVATE\HARDWARE\MICROC~1\FINALO~1\RFM73.PBP	00236	Next w 'get next byte
	NEXT?BCL	_w, 001h, L00013
	LABEL?L	L00014	

; C:\REMOTE~1\PRIVATE\HARDWARE\MICROC~1\FINALO~1\RFM73.PBP	00237	CSN=1
	MOVE?CT	001h, _CSN

; C:\REMOTE~1\PRIVATE\HARDWARE\MICROC~1\FINALO~1\RFM73.PBP	00238	Return
	RETURN?	

; C:\REMOTE~1\PRIVATE\HARDWARE\MICROC~1\FINALO~1\RFM73.PBP	00239	buffer_ok:

	LABEL?L	_buffer_ok	

; C:\REMOTE~1\PRIVATE\HARDWARE\MICROC~1\FINALO~1\RFM73.PBP	00240	IF SSPIF = 0 Then buffer_ok 'wait for SPI interupt flag
	CMPEQ?TCL	_SSPIF, 000h, _buffer_ok

; C:\REMOTE~1\PRIVATE\HARDWARE\MICROC~1\FINALO~1\RFM73.PBP	00241	SSPIF = 0 'reset flag
	MOVE?CT	000h, _SSPIF

; C:\REMOTE~1\PRIVATE\HARDWARE\MICROC~1\FINALO~1\RFM73.PBP	00242	Return
	RETURN?	

; C:\REMOTE~1\PRIVATE\HARDWARE\MICROC~1\FINALO~1\RFM73.PBP	00244	max_retry:

	LABEL?L	_max_retry	

; C:\REMOTE~1\PRIVATE\HARDWARE\MICROC~1\FINALO~1\RFM73.PBP	00245	data_out[0]=Flush_tx 'flush TX buffer
	MOVE?CB	_Flush_tx, _data_out

; C:\REMOTE~1\PRIVATE\HARDWARE\MICROC~1\FINALO~1\RFM73.PBP	00246	num_byte=0
	MOVE?CB	000h, _num_byte

; C:\REMOTE~1\PRIVATE\HARDWARE\MICROC~1\FINALO~1\RFM73.PBP	00247	gosub spi_write
	GOSUB?L	_spi_write

; C:\REMOTE~1\PRIVATE\HARDWARE\MICROC~1\FINALO~1\RFM73.PBP	00248	data_out[0]=Write_reg+Stat_us
	MOVE?CB	027h, _data_out

; C:\REMOTE~1\PRIVATE\HARDWARE\MICROC~1\FINALO~1\RFM73.PBP	00249	data_out[1]=%00010000 'clear MAX_RT IRQ bit
	MOVE?CB	010h, _data_out + 00001h

; C:\REMOTE~1\PRIVATE\HARDWARE\MICROC~1\FINALO~1\RFM73.PBP	00250	num_byte=1
	MOVE?CB	001h, _num_byte

; C:\REMOTE~1\PRIVATE\HARDWARE\MICROC~1\FINALO~1\RFM73.PBP	00251	gosub spi_write
	GOSUB?L	_spi_write

; C:\REMOTE~1\PRIVATE\HARDWARE\MICROC~1\FINALO~1\RFM73.PBP	00252	return
	RETURN?	

; C:\REMOTE~1\PRIVATE\HARDWARE\MICROC~1\FINALO~1\RFM73.PBP	00254	tx_int:

	LABEL?L	_tx_int	

; C:\REMOTE~1\PRIVATE\HARDWARE\MICROC~1\FINALO~1\RFM73.PBP	00255	data_out[0]=Flush_tx 'flush TX buffer
	MOVE?CB	_Flush_tx, _data_out

; C:\REMOTE~1\PRIVATE\HARDWARE\MICROC~1\FINALO~1\RFM73.PBP	00256	num_byte=0
	MOVE?CB	000h, _num_byte

; C:\REMOTE~1\PRIVATE\HARDWARE\MICROC~1\FINALO~1\RFM73.PBP	00257	gosub spi_write
	GOSUB?L	_spi_write

; C:\REMOTE~1\PRIVATE\HARDWARE\MICROC~1\FINALO~1\RFM73.PBP	00258	data_out[0]=Write_reg+Stat_us
	MOVE?CB	027h, _data_out

; C:\REMOTE~1\PRIVATE\HARDWARE\MICROC~1\FINALO~1\RFM73.PBP	00259	data_out[1]=%00110000 'clear TX_DS & MAX_RT IRQ bit
	MOVE?CB	030h, _data_out + 00001h

; C:\REMOTE~1\PRIVATE\HARDWARE\MICROC~1\FINALO~1\RFM73.PBP	00260	num_byte=1
	MOVE?CB	001h, _num_byte

; C:\REMOTE~1\PRIVATE\HARDWARE\MICROC~1\FINALO~1\RFM73.PBP	00261	gosub spi_write
	GOSUB?L	_spi_write

; C:\REMOTE~1\PRIVATE\HARDWARE\MICROC~1\FINALO~1\RFM73.PBP	00262	return
	RETURN?	

; C:\REMOTE~1\PRIVATE\HARDWARE\MICROC~1\FINALO~1\RFM73.PBP	00264	setup_rx:

	LABEL?L	_setup_rx	

; C:\REMOTE~1\PRIVATE\HARDWARE\MICROC~1\FINALO~1\RFM73.PBP	00265	gosub debounce
	GOSUB?L	_debounce

; C:\REMOTE~1\PRIVATE\HARDWARE\MICROC~1\FINALO~1\RFM73.PBP	00266	data_out[0]=Write_reg+Config_nrf 'Config:PRX=1,PWR_UP=1, CRC=2, enabled
	MOVE?CB	020h, _data_out

; C:\REMOTE~1\PRIVATE\HARDWARE\MICROC~1\FINALO~1\RFM73.PBP	00267	data_out[1]=$0F
	MOVE?CB	00Fh, _data_out + 00001h

; C:\REMOTE~1\PRIVATE\HARDWARE\MICROC~1\FINALO~1\RFM73.PBP	00268	num_byte=1
	MOVE?CB	001h, _num_byte

; C:\REMOTE~1\PRIVATE\HARDWARE\MICROC~1\FINALO~1\RFM73.PBP	00269	gosub spi_write
	GOSUB?L	_spi_write

; C:\REMOTE~1\PRIVATE\HARDWARE\MICROC~1\FINALO~1\RFM73.PBP	00271	return
	RETURN?	

; C:\REMOTE~1\PRIVATE\HARDWARE\MICROC~1\FINALO~1\RFM73.PBP	00273	setup_sleep:

	LABEL?L	_setup_sleep	

; C:\REMOTE~1\PRIVATE\HARDWARE\MICROC~1\FINALO~1\RFM73.PBP	00274	data_out[0]=Write_reg+Config_nrf 'Config:PRX=1,PWR_UP=0, CRC=2, enabled
	MOVE?CB	020h, _data_out

; C:\REMOTE~1\PRIVATE\HARDWARE\MICROC~1\FINALO~1\RFM73.PBP	00275	data_out[1]=%00001101
	MOVE?CB	00Dh, _data_out + 00001h

; C:\REMOTE~1\PRIVATE\HARDWARE\MICROC~1\FINALO~1\RFM73.PBP	00276	num_byte=1
	MOVE?CB	001h, _num_byte

; C:\REMOTE~1\PRIVATE\HARDWARE\MICROC~1\FINALO~1\RFM73.PBP	00277	gosub spi_write
	GOSUB?L	_spi_write

; C:\REMOTE~1\PRIVATE\HARDWARE\MICROC~1\FINALO~1\RFM73.PBP	00278	return
	RETURN?	

; C:\REMOTE~1\PRIVATE\HARDWARE\MICROC~1\FINALO~1\RFM73.PBP	00280	setup_tx:

	LABEL?L	_setup_tx	

; C:\REMOTE~1\PRIVATE\HARDWARE\MICROC~1\FINALO~1\RFM73.PBP	00281	data_out[0]=Write_reg+Tx_addr 'Tx address
	MOVE?CB	030h, _data_out

; C:\REMOTE~1\PRIVATE\HARDWARE\MICROC~1\FINALO~1\RFM73.PBP	00282	gosub setTxAddressPipe
	GOSUB?L	_setTxAddressPipe

; C:\REMOTE~1\PRIVATE\HARDWARE\MICROC~1\FINALO~1\RFM73.PBP	00283	num_byte=5
	MOVE?CB	005h, _num_byte

; C:\REMOTE~1\PRIVATE\HARDWARE\MICROC~1\FINALO~1\RFM73.PBP	00284	gosub spi_write
	GOSUB?L	_spi_write

; C:\REMOTE~1\PRIVATE\HARDWARE\MICROC~1\FINALO~1\RFM73.PBP	00285	data_out[0]= Write_reg+Setup_retr 'Set retransmit @ ACK
	MOVE?CB	024h, _data_out

; C:\REMOTE~1\PRIVATE\HARDWARE\MICROC~1\FINALO~1\RFM73.PBP	00286	data_out[1]= %00110101 '15x re-transmit (default)
	MOVE?CB	035h, _data_out + 00001h

; C:\REMOTE~1\PRIVATE\HARDWARE\MICROC~1\FINALO~1\RFM73.PBP	00287	num_byte=1
	MOVE?CB	001h, _num_byte

; C:\REMOTE~1\PRIVATE\HARDWARE\MICROC~1\FINALO~1\RFM73.PBP	00288	Gosub spi_write
	GOSUB?L	_spi_write

; C:\REMOTE~1\PRIVATE\HARDWARE\MICROC~1\FINALO~1\RFM73.PBP	00289	data_out[0]=Write_reg+Config_nrf 'Config:PRX=0,PWR_UP=1, CRC=2, enabled
	MOVE?CB	020h, _data_out

; C:\REMOTE~1\PRIVATE\HARDWARE\MICROC~1\FINALO~1\RFM73.PBP	00290	data_out[1]=$0E
	MOVE?CB	00Eh, _data_out + 00001h

; C:\REMOTE~1\PRIVATE\HARDWARE\MICROC~1\FINALO~1\RFM73.PBP	00291	num_byte=1
	MOVE?CB	001h, _num_byte

; C:\REMOTE~1\PRIVATE\HARDWARE\MICROC~1\FINALO~1\RFM73.PBP	00292	gosub spi_write
	GOSUB?L	_spi_write

; C:\REMOTE~1\PRIVATE\HARDWARE\MICROC~1\FINALO~1\RFM73.PBP	00293	return
	RETURN?	

; C:\REMOTE~1\PRIVATE\HARDWARE\MICROC~1\FINALO~1\RFM73.PBP	00294	:endRFM73

	LABEL?L	_endRFM73	
; C:\REMOTE~1\PRIVATE\HARDWARE\MICROC~1\FINALO~1\SIMPLE~1.PBP	00022	 DEFINE OSC 8

; C:\REMOTE~1\PRIVATE\HARDWARE\MICROC~1\FINALO~1\SIMPLE~1.PBP	00024	 OSCCON = %01110000 ' Internal 8MHz osc
	MOVE?CB	070h, OSCCON

; C:\REMOTE~1\PRIVATE\HARDWARE\MICROC~1\FINALO~1\SIMPLE~1.PBP	00025	 ANSEL = 0
	MOVE?CB	000h, ANSEL

; C:\REMOTE~1\PRIVATE\HARDWARE\MICROC~1\FINALO~1\SIMPLE~1.PBP	00026	 ANSELH = 0
	MOVE?CB	000h, ANSELH

; C:\REMOTE~1\PRIVATE\HARDWARE\MICROC~1\FINALO~1\SIMPLE~1.PBP	00027	 CM1CON0 = 0
	MOVE?CB	000h, CM1CON0

; C:\REMOTE~1\PRIVATE\HARDWARE\MICROC~1\FINALO~1\SIMPLE~1.PBP	00028	 CM2CON0 = 0
	MOVE?CB	000h, CM2CON0

; C:\REMOTE~1\PRIVATE\HARDWARE\MICROC~1\FINALO~1\SIMPLE~1.PBP	00031	    INTCON = %10100000  'T01 enabled PEIE disabled.
	MOVE?CB	0A0h, INTCON

; C:\REMOTE~1\PRIVATE\HARDWARE\MICROC~1\FINALO~1\SIMPLE~1.PBP	00032	    PIE1 = %00000000    'USART disabled
	MOVE?CB	000h, PIE1

; C:\REMOTE~1\PRIVATE\HARDWARE\MICROC~1\FINALO~1\SIMPLE~1.PBP	00033	    OPTION_REG = %00000111
	MOVE?CB	007h, OPTION_REG

; C:\REMOTE~1\PRIVATE\HARDWARE\MICROC~1\FINALO~1\SIMPLE~1.PBP	00035	on interrupt goto intManagement
	ONINT?LL	_intManagement, L00001

; C:\REMOTE~1\PRIVATE\HARDWARE\MICROC~1\FINALO~1\SIMPLE~1.PBP	00036	ENABLE
	ENABLE?	

; C:\REMOTE~1\PRIVATE\HARDWARE\MICROC~1\FINALO~1\SIMPLE~1.PBP	00038	TRISA = %00000000 'Set PORTA to all output
	ICALL?L	L00001
	MOVE?CB	000h, TRISA

; C:\REMOTE~1\PRIVATE\HARDWARE\MICROC~1\FINALO~1\SIMPLE~1.PBP	00039	TRISB = %00010000 'Set , SDI input
	ICALL?L	L00001
	MOVE?CB	010h, TRISB

; C:\REMOTE~1\PRIVATE\HARDWARE\MICROC~1\FINALO~1\SIMPLE~1.PBP	00040	TRISC = %00000100 'Set IRQ input
	ICALL?L	L00001
	MOVE?CB	004h, TRISC

; C:\REMOTE~1\PRIVATE\HARDWARE\MICROC~1\FINALO~1\SIMPLE~1.PBP	00041	WPUA = %00000000
	ICALL?L	L00001
	MOVE?CB	000h, WPUA

; C:\REMOTE~1\PRIVATE\HARDWARE\MICROC~1\FINALO~1\SIMPLE~1.PBP	00042	WPUB = %00100000
	ICALL?L	L00001
	MOVE?CB	020h, WPUB

; C:\REMOTE~1\PRIVATE\HARDWARE\MICROC~1\FINALO~1\SIMPLE~1.PBP	00063	startProg:

	LABEL?L	_startProg	

; C:\REMOTE~1\PRIVATE\HARDWARE\MICROC~1\FINALO~1\SIMPLE~1.PBP	00064	clear
	ICALL?L	L00001
	CLEAR?	

; C:\REMOTE~1\PRIVATE\HARDWARE\MICROC~1\FINALO~1\SIMPLE~1.PBP	00065	input RES
	ICALL?L	L00001
	INPUT?T	_RES

; C:\REMOTE~1\PRIVATE\HARDWARE\MICROC~1\FINALO~1\SIMPLE~1.PBP	00066	output relay
	ICALL?L	L00001
	OUTPUT?T	_RELAY

; C:\REMOTE~1\PRIVATE\HARDWARE\MICROC~1\FINALO~1\SIMPLE~1.PBP	00067	READ 10, device_id
	ICALL?L	L00001
	READADDRESS?C	00Ah
	READ?B	_device_id

; C:\REMOTE~1\PRIVATE\HARDWARE\MICROC~1\FINALO~1\SIMPLE~1.PBP	00068	read 11, temp_byte
	ICALL?L	L00001
	READADDRESS?C	00Bh
	READ?B	_temp_byte

; C:\REMOTE~1\PRIVATE\HARDWARE\MICROC~1\FINALO~1\SIMPLE~1.PBP	00069	if (temp_byte == 0) then 
	ICALL?L	L00001
	CMPNE?BCL	_temp_byte, 000h, L00015

; C:\REMOTE~1\PRIVATE\HARDWARE\MICROC~1\FINALO~1\SIMPLE~1.PBP	00070	    high relay
	ICALL?L	L00001
	HIGH?T	_RELAY

; C:\REMOTE~1\PRIVATE\HARDWARE\MICROC~1\FINALO~1\SIMPLE~1.PBP	00071	else
	ICALL?L	L00001
	GOTO?L	L00016
	LABEL?L	L00015	

; C:\REMOTE~1\PRIVATE\HARDWARE\MICROC~1\FINALO~1\SIMPLE~1.PBP	00072	    low relay
	ICALL?L	L00001
	LOW?T	_RELAY

; C:\REMOTE~1\PRIVATE\HARDWARE\MICROC~1\FINALO~1\SIMPLE~1.PBP	00073	endif
	ICALL?L	L00001
	LABEL?L	L00016	

; C:\REMOTE~1\PRIVATE\HARDWARE\MICROC~1\FINALO~1\SIMPLE~1.PBP	00074	gosub initModule
	ICALL?L	L00001
	GOSUB?L	_initModule

; C:\REMOTE~1\PRIVATE\HARDWARE\MICROC~1\FINALO~1\SIMPLE~1.PBP	00076	commonSettings:

	LABEL?L	_commonSettings	

; C:\REMOTE~1\PRIVATE\HARDWARE\MICROC~1\FINALO~1\SIMPLE~1.PBP	00077	gosub commonRXTX
	ICALL?L	L00001
	GOSUB?L	_commonRXTX

; C:\REMOTE~1\PRIVATE\HARDWARE\MICROC~1\FINALO~1\SIMPLE~1.PBP	00080	Main_rx:

	LABEL?L	_Main_rx	

; C:\REMOTE~1\PRIVATE\HARDWARE\MICROC~1\FINALO~1\SIMPLE~1.PBP	00081	gosub setup_rx 'setup Rx
	ICALL?L	L00001
	GOSUB?L	_setup_rx

; C:\REMOTE~1\PRIVATE\HARDWARE\MICROC~1\FINALO~1\SIMPLE~1.PBP	00082	pause 2 'delay for Rx starting
	ICALL?L	L00001
	PAUSE?C	002h

; C:\REMOTE~1\PRIVATE\HARDWARE\MICROC~1\FINALO~1\SIMPLE~1.PBP	00083	Ce=1 'set nRF24L01 in Rx mode
	ICALL?L	L00001
	MOVE?CT	001h, _Ce

; C:\REMOTE~1\PRIVATE\HARDWARE\MICROC~1\FINALO~1\SIMPLE~1.PBP	00084	irqLoop:

	LABEL?L	_irqLoop	

; C:\REMOTE~1\PRIVATE\HARDWARE\MICROC~1\FINALO~1\SIMPLE~1.PBP	00085	if RES == 0 then
	ICALL?L	L00001
	CMPNE?TCL	_RES, 000h, L00017

; C:\REMOTE~1\PRIVATE\HARDWARE\MICROC~1\FINALO~1\SIMPLE~1.PBP	00086	    write 0, 40
	ICALL?L	L00001
	WRITEADDRESS?C	000h
	WRITE?C	028h

; C:\REMOTE~1\PRIVATE\HARDWARE\MICROC~1\FINALO~1\SIMPLE~1.PBP	00087	    write 1, "R"
	ICALL?L	L00001
	WRITEADDRESS?C	001h
	WRITE?C	052h

; C:\REMOTE~1\PRIVATE\HARDWARE\MICROC~1\FINALO~1\SIMPLE~1.PBP	00088	    write 2, "E"
	ICALL?L	L00001
	WRITEADDRESS?C	002h
	WRITE?C	045h

; C:\REMOTE~1\PRIVATE\HARDWARE\MICROC~1\FINALO~1\SIMPLE~1.PBP	00089	    write 3, "M"
	ICALL?L	L00001
	WRITEADDRESS?C	003h
	WRITE?C	04Dh

; C:\REMOTE~1\PRIVATE\HARDWARE\MICROC~1\FINALO~1\SIMPLE~1.PBP	00090	    write 4, "O"
	ICALL?L	L00001
	WRITEADDRESS?C	004h
	WRITE?C	04Fh

; C:\REMOTE~1\PRIVATE\HARDWARE\MICROC~1\FINALO~1\SIMPLE~1.PBP	00091	    write 5, "T"
	ICALL?L	L00001
	WRITEADDRESS?C	005h
	WRITE?C	054h

; C:\REMOTE~1\PRIVATE\HARDWARE\MICROC~1\FINALO~1\SIMPLE~1.PBP	00092	    write 6, "E"
	ICALL?L	L00001
	WRITEADDRESS?C	006h
	WRITE?C	045h

; C:\REMOTE~1\PRIVATE\HARDWARE\MICROC~1\FINALO~1\SIMPLE~1.PBP	00093	    write 7, "H"
	ICALL?L	L00001
	WRITEADDRESS?C	007h
	WRITE?C	048h

; C:\REMOTE~1\PRIVATE\HARDWARE\MICROC~1\FINALO~1\SIMPLE~1.PBP	00094	    write 8, "O"
	ICALL?L	L00001
	WRITEADDRESS?C	008h
	WRITE?C	04Fh

; C:\REMOTE~1\PRIVATE\HARDWARE\MICROC~1\FINALO~1\SIMPLE~1.PBP	00095	    write 9, "M"
	ICALL?L	L00001
	WRITEADDRESS?C	009h
	WRITE?C	04Dh

; C:\REMOTE~1\PRIVATE\HARDWARE\MICROC~1\FINALO~1\SIMPLE~1.PBP	00096	    write 10, 0
	ICALL?L	L00001
	WRITEADDRESS?C	00Ah
	WRITE?C	000h

; C:\REMOTE~1\PRIVATE\HARDWARE\MICROC~1\FINALO~1\SIMPLE~1.PBP	00097	    write 11, 1
	ICALL?L	L00001
	WRITEADDRESS?C	00Bh
	WRITE?C	001h

; C:\REMOTE~1\PRIVATE\HARDWARE\MICROC~1\FINALO~1\SIMPLE~1.PBP	00098	    write 12, 0
	ICALL?L	L00001
	WRITEADDRESS?C	00Ch
	WRITE?C	000h

; C:\REMOTE~1\PRIVATE\HARDWARE\MICROC~1\FINALO~1\SIMPLE~1.PBP	00099	    pause 1000
	ICALL?L	L00001
	PAUSE?C	003E8h

; C:\REMOTE~1\PRIVATE\HARDWARE\MICROC~1\FINALO~1\SIMPLE~1.PBP	00100	    goto startProg
	ICALL?L	L00001
	GOTO?L	_startProg

; C:\REMOTE~1\PRIVATE\HARDWARE\MICROC~1\FINALO~1\SIMPLE~1.PBP	00101	endif
	ICALL?L	L00001
	LABEL?L	L00017	

; C:\REMOTE~1\PRIVATE\HARDWARE\MICROC~1\FINALO~1\SIMPLE~1.PBP	00103	if (temp_data[0] != 0) then
	ICALL?L	L00001
	CMPEQ?BCL	_temp_data, 000h, L00019

; C:\REMOTE~1\PRIVATE\HARDWARE\MICROC~1\FINALO~1\SIMPLE~1.PBP	00104	    if (configure == 1) then
	ICALL?L	L00001
	CMPNE?BCL	_configure, 001h, L00021

; C:\REMOTE~1\PRIVATE\HARDWARE\MICROC~1\FINALO~1\SIMPLE~1.PBP	00105	        gosub commonRXTX
	ICALL?L	L00001
	GOSUB?L	_commonRXTX

; C:\REMOTE~1\PRIVATE\HARDWARE\MICROC~1\FINALO~1\SIMPLE~1.PBP	00106	        configure = 0
	ICALL?L	L00001
	MOVE?CB	000h, _configure

; C:\REMOTE~1\PRIVATE\HARDWARE\MICROC~1\FINALO~1\SIMPLE~1.PBP	00107	    endif
	ICALL?L	L00001
	LABEL?L	L00021	

; C:\REMOTE~1\PRIVATE\HARDWARE\MICROC~1\FINALO~1\SIMPLE~1.PBP	00108	    gosub sendData
	ICALL?L	L00001
	GOSUB?L	_sendData

; C:\REMOTE~1\PRIVATE\HARDWARE\MICROC~1\FINALO~1\SIMPLE~1.PBP	00109	    temp_data[0] = 0
	ICALL?L	L00001
	MOVE?CB	000h, _temp_data

; C:\REMOTE~1\PRIVATE\HARDWARE\MICROC~1\FINALO~1\SIMPLE~1.PBP	00110	    GOTO main_rx
	ICALL?L	L00001
	GOTO?L	_Main_rx

; C:\REMOTE~1\PRIVATE\HARDWARE\MICROC~1\FINALO~1\SIMPLE~1.PBP	00111	endif
	ICALL?L	L00001
	LABEL?L	L00019	

; C:\REMOTE~1\PRIVATE\HARDWARE\MICROC~1\FINALO~1\SIMPLE~1.PBP	00112	If Irq !=0 then irqLoop 'wait until IRQ, active low
	ICALL?L	L00001
	CMPNE?TCL	_Irq, 000h, _irqLoop

; C:\REMOTE~1\PRIVATE\HARDWARE\MICROC~1\FINALO~1\SIMPLE~1.PBP	00113	Ce=0
	ICALL?L	L00001
	MOVE?CT	000h, _Ce

; C:\REMOTE~1\PRIVATE\HARDWARE\MICROC~1\FINALO~1\SIMPLE~1.PBP	00114	lop:

	LABEL?L	_lop	

; C:\REMOTE~1\PRIVATE\HARDWARE\MICROC~1\FINALO~1\SIMPLE~1.PBP	00115	data_out[0]=rd_rx_pload 'Read 5 bytes Rx pload
	ICALL?L	L00001
	MOVE?CB	_Rd_rx_pload, _data_out

; C:\REMOTE~1\PRIVATE\HARDWARE\MICROC~1\FINALO~1\SIMPLE~1.PBP	00116	num_byte=payloadLength
	ICALL?L	L00001
	MOVE?CB	_payloadLength, _num_byte

; C:\REMOTE~1\PRIVATE\HARDWARE\MICROC~1\FINALO~1\SIMPLE~1.PBP	00117	gosub spi_read
	ICALL?L	L00001
	GOSUB?L	_spi_read

; C:\REMOTE~1\PRIVATE\HARDWARE\MICROC~1\FINALO~1\SIMPLE~1.PBP	00118	temp_data[0] = 0
	ICALL?L	L00001
	MOVE?CB	000h, _temp_data

; C:\REMOTE~1\PRIVATE\HARDWARE\MICROC~1\FINALO~1\SIMPLE~1.PBP	00119	if (data_in[1] == device_id) then
	ICALL?L	L00001
	CMPNE?BBL	_data_in + 00001h, _device_id, L00023

; C:\REMOTE~1\PRIVATE\HARDWARE\MICROC~1\FINALO~1\SIMPLE~1.PBP	00120	    if (data_in[2] == "c") then    
	ICALL?L	L00001
	CMPNE?BCL	_data_in + 00002h, 063h, L00025

; C:\REMOTE~1\PRIVATE\HARDWARE\MICROC~1\FINALO~1\SIMPLE~1.PBP	00121	        if (data_in[3] == "=") then
	ICALL?L	L00001
	CMPNE?BCL	_data_in + 00003h, 03Dh, L00027

; C:\REMOTE~1\PRIVATE\HARDWARE\MICROC~1\FINALO~1\SIMPLE~1.PBP	00123	            for i = 0 to 10
	ICALL?L	L00001
	MOVE?CB	000h, _i
	LABEL?L	L00029	
	CMPGT?BCL	_i, 00Ah, L00030

; C:\REMOTE~1\PRIVATE\HARDWARE\MICROC~1\FINALO~1\SIMPLE~1.PBP	00124	                disable
	DISABLE?	

; C:\REMOTE~1\PRIVATE\HARDWARE\MICROC~1\FINALO~1\SIMPLE~1.PBP	00125	                write i, data_in[i+4]
	WRITEADDRESS?B	_i
	ADD?BCW	_i, 004h, T1
	AOUT?BWB	_data_in, T1, T1
	WRITE?B	T1

; C:\REMOTE~1\PRIVATE\HARDWARE\MICROC~1\FINALO~1\SIMPLE~1.PBP	00126	                enable
	ENABLE?	

; C:\REMOTE~1\PRIVATE\HARDWARE\MICROC~1\FINALO~1\SIMPLE~1.PBP	00127	            next i
	ICALL?L	L00001
	NEXT?BCL	_i, 001h, L00029
	LABEL?L	L00030	

; C:\REMOTE~1\PRIVATE\HARDWARE\MICROC~1\FINALO~1\SIMPLE~1.PBP	00128	            read 10, device_id
	ICALL?L	L00001
	READADDRESS?C	00Ah
	READ?B	_device_id

; C:\REMOTE~1\PRIVATE\HARDWARE\MICROC~1\FINALO~1\SIMPLE~1.PBP	00129	            pause 250
	ICALL?L	L00001
	PAUSE?C	0FAh

; C:\REMOTE~1\PRIVATE\HARDWARE\MICROC~1\FINALO~1\SIMPLE~1.PBP	00130	            configure = 1
	ICALL?L	L00001
	MOVE?CB	001h, _configure

; C:\REMOTE~1\PRIVATE\HARDWARE\MICROC~1\FINALO~1\SIMPLE~1.PBP	00131	            gosub sendDataOK
	ICALL?L	L00001
	GOSUB?L	_sendDataOK

; C:\REMOTE~1\PRIVATE\HARDWARE\MICROC~1\FINALO~1\SIMPLE~1.PBP	00132	        endif
	ICALL?L	L00001
	LABEL?L	L00027	

; C:\REMOTE~1\PRIVATE\HARDWARE\MICROC~1\FINALO~1\SIMPLE~1.PBP	00133	    elseif (data_in[2] == "l") then
	ICALL?L	L00001
	GOTO?L	L00026
	LABEL?L	L00025	
	CMPNE?BCL	_data_in + 00002h, 06Ch, L00031

; C:\REMOTE~1\PRIVATE\HARDWARE\MICROC~1\FINALO~1\SIMPLE~1.PBP	00134	        if (data_in[3] == "1") then
	ICALL?L	L00001
	CMPNE?BCL	_data_in + 00003h, 031h, L00033

; C:\REMOTE~1\PRIVATE\HARDWARE\MICROC~1\FINALO~1\SIMPLE~1.PBP	00135	            if (data_in[4] == "c") then
	ICALL?L	L00001
	CMPNE?BCL	_data_in + 00004h, 063h, L00035

; C:\REMOTE~1\PRIVATE\HARDWARE\MICROC~1\FINALO~1\SIMPLE~1.PBP	00136	                if (data_in[5] == "o") then
	ICALL?L	L00001
	CMPNE?BCL	_data_in + 00005h, 06Fh, L00037

; C:\REMOTE~1\PRIVATE\HARDWARE\MICROC~1\FINALO~1\SIMPLE~1.PBP	00137	                    write 11, 0
	ICALL?L	L00001
	WRITEADDRESS?C	00Bh
	WRITE?C	000h

; C:\REMOTE~1\PRIVATE\HARDWARE\MICROC~1\FINALO~1\SIMPLE~1.PBP	00138	                    gosub sendDataOK
	ICALL?L	L00001
	GOSUB?L	_sendDataOK

; C:\REMOTE~1\PRIVATE\HARDWARE\MICROC~1\FINALO~1\SIMPLE~1.PBP	00139	                endif
	ICALL?L	L00001
	LABEL?L	L00037	

; C:\REMOTE~1\PRIVATE\HARDWARE\MICROC~1\FINALO~1\SIMPLE~1.PBP	00140	                if (data_in[5] == "f") then
	ICALL?L	L00001
	CMPNE?BCL	_data_in + 00005h, 066h, L00039

; C:\REMOTE~1\PRIVATE\HARDWARE\MICROC~1\FINALO~1\SIMPLE~1.PBP	00141	                    write 11, 1
	ICALL?L	L00001
	WRITEADDRESS?C	00Bh
	WRITE?C	001h

; C:\REMOTE~1\PRIVATE\HARDWARE\MICROC~1\FINALO~1\SIMPLE~1.PBP	00142	                    gosub sendDataOK
	ICALL?L	L00001
	GOSUB?L	_sendDataOK

; C:\REMOTE~1\PRIVATE\HARDWARE\MICROC~1\FINALO~1\SIMPLE~1.PBP	00143	                endif
	ICALL?L	L00001
	LABEL?L	L00039	

; C:\REMOTE~1\PRIVATE\HARDWARE\MICROC~1\FINALO~1\SIMPLE~1.PBP	00144	                if (data_in[5] == "t") then
	ICALL?L	L00001
	CMPNE?BCL	_data_in + 00005h, 074h, L00041

; C:\REMOTE~1\PRIVATE\HARDWARE\MICROC~1\FINALO~1\SIMPLE~1.PBP	00145	                    if (data_in[6] == "=") then
	ICALL?L	L00001
	CMPNE?BCL	_data_in + 00006h, 03Dh, L00043

; C:\REMOTE~1\PRIVATE\HARDWARE\MICROC~1\FINALO~1\SIMPLE~1.PBP	00146	                        i = 7
	ICALL?L	L00001
	MOVE?CB	007h, _i

; C:\REMOTE~1\PRIVATE\HARDWARE\MICROC~1\FINALO~1\SIMPLE~1.PBP	00147	                        gosub convertInputData
	ICALL?L	L00001
	GOSUB?L	_convertInputData

; C:\REMOTE~1\PRIVATE\HARDWARE\MICROC~1\FINALO~1\SIMPLE~1.PBP	00148	                        if (conversionSuccess == 1) then
	ICALL?L	L00001
	CMPNE?BCL	_conversionSuccess, 001h, L00045

; C:\REMOTE~1\PRIVATE\HARDWARE\MICROC~1\FINALO~1\SIMPLE~1.PBP	00149	                            write 12, temp_byte
	ICALL?L	L00001
	WRITEADDRESS?C	00Ch
	WRITE?B	_temp_byte

; C:\REMOTE~1\PRIVATE\HARDWARE\MICROC~1\FINALO~1\SIMPLE~1.PBP	00150	                            gosub sendDataOK
	ICALL?L	L00001
	GOSUB?L	_sendDataOK

; C:\REMOTE~1\PRIVATE\HARDWARE\MICROC~1\FINALO~1\SIMPLE~1.PBP	00151	                        endif
	ICALL?L	L00001
	LABEL?L	L00045	

; C:\REMOTE~1\PRIVATE\HARDWARE\MICROC~1\FINALO~1\SIMPLE~1.PBP	00152	                    endif
	ICALL?L	L00001
	LABEL?L	L00043	

; C:\REMOTE~1\PRIVATE\HARDWARE\MICROC~1\FINALO~1\SIMPLE~1.PBP	00153	                endif                
	ICALL?L	L00001
	LABEL?L	L00041	

; C:\REMOTE~1\PRIVATE\HARDWARE\MICROC~1\FINALO~1\SIMPLE~1.PBP	00154	            elseif (data_in[4] == "o") then
	ICALL?L	L00001
	GOTO?L	L00036
	LABEL?L	L00035	
	CMPNE?BCL	_data_in + 00004h, 06Fh, L00047

; C:\REMOTE~1\PRIVATE\HARDWARE\MICROC~1\FINALO~1\SIMPLE~1.PBP	00155	                if (data_in[5] == "f") then
	ICALL?L	L00001
	CMPNE?BCL	_data_in + 00005h, 066h, L00049

; C:\REMOTE~1\PRIVATE\HARDWARE\MICROC~1\FINALO~1\SIMPLE~1.PBP	00156	                    seconds = 0
	ICALL?L	L00001
	MOVE?CB	000h, _seconds

; C:\REMOTE~1\PRIVATE\HARDWARE\MICROC~1\FINALO~1\SIMPLE~1.PBP	00157	                    ticks = 0
	ICALL?L	L00001
	MOVE?CW	000h, _ticks

; C:\REMOTE~1\PRIVATE\HARDWARE\MICROC~1\FINALO~1\SIMPLE~1.PBP	00158	                    read 12, l1counter
	ICALL?L	L00001
	READADDRESS?C	00Ch
	READ?B	_l1counter

; C:\REMOTE~1\PRIVATE\HARDWARE\MICROC~1\FINALO~1\SIMPLE~1.PBP	00159	                    high relay
	ICALL?L	L00001
	HIGH?T	_RELAY

; C:\REMOTE~1\PRIVATE\HARDWARE\MICROC~1\FINALO~1\SIMPLE~1.PBP	00160	                    gosub sendDataOK
	ICALL?L	L00001
	GOSUB?L	_sendDataOK

; C:\REMOTE~1\PRIVATE\HARDWARE\MICROC~1\FINALO~1\SIMPLE~1.PBP	00161	                else
	ICALL?L	L00001
	GOTO?L	L00050
	LABEL?L	L00049	

; C:\REMOTE~1\PRIVATE\HARDWARE\MICROC~1\FINALO~1\SIMPLE~1.PBP	00162	                    high relay
	ICALL?L	L00001
	HIGH?T	_RELAY

; C:\REMOTE~1\PRIVATE\HARDWARE\MICROC~1\FINALO~1\SIMPLE~1.PBP	00163	                    l1counter = 0
	ICALL?L	L00001
	MOVE?CB	000h, _l1counter

; C:\REMOTE~1\PRIVATE\HARDWARE\MICROC~1\FINALO~1\SIMPLE~1.PBP	00164	                    gosub sendDataOK
	ICALL?L	L00001
	GOSUB?L	_sendDataOK

; C:\REMOTE~1\PRIVATE\HARDWARE\MICROC~1\FINALO~1\SIMPLE~1.PBP	00165	                endif
	ICALL?L	L00001
	LABEL?L	L00050	

; C:\REMOTE~1\PRIVATE\HARDWARE\MICROC~1\FINALO~1\SIMPLE~1.PBP	00166	            elseif (data_in[4] == "f") then
	ICALL?L	L00001
	GOTO?L	L00036
	LABEL?L	L00047	
	CMPNE?BCL	_data_in + 00004h, 066h, L00051

; C:\REMOTE~1\PRIVATE\HARDWARE\MICROC~1\FINALO~1\SIMPLE~1.PBP	00167	                LOW relay
	ICALL?L	L00001
	LOW?T	_RELAY

; C:\REMOTE~1\PRIVATE\HARDWARE\MICROC~1\FINALO~1\SIMPLE~1.PBP	00168	                gosub sendDataOK
	ICALL?L	L00001
	GOSUB?L	_sendDataOK

; C:\REMOTE~1\PRIVATE\HARDWARE\MICROC~1\FINALO~1\SIMPLE~1.PBP	00169	            endif
	ICALL?L	L00001
	LABEL?L	L00036	
	LABEL?L	L00051	

; C:\REMOTE~1\PRIVATE\HARDWARE\MICROC~1\FINALO~1\SIMPLE~1.PBP	00170	        endif
	ICALL?L	L00001
	LABEL?L	L00033	

; C:\REMOTE~1\PRIVATE\HARDWARE\MICROC~1\FINALO~1\SIMPLE~1.PBP	00171	    elseif (data_in[2] == "s") then
	ICALL?L	L00001
	GOTO?L	L00026
	LABEL?L	L00031	
	CMPNE?BCL	_data_in + 00002h, 073h, L00053

; C:\REMOTE~1\PRIVATE\HARDWARE\MICROC~1\FINALO~1\SIMPLE~1.PBP	00172	            temp_data[0] = "3"
	ICALL?L	L00001
	MOVE?CB	033h, _temp_data

; C:\REMOTE~1\PRIVATE\HARDWARE\MICROC~1\FINALO~1\SIMPLE~1.PBP	00173	            temp_data[1] = "|"
	ICALL?L	L00001
	MOVE?CB	07Ch, _temp_data + 00001h

; C:\REMOTE~1\PRIVATE\HARDWARE\MICROC~1\FINALO~1\SIMPLE~1.PBP	00174	            temp_data[2] = RELAY + $30
	ICALL?L	L00001
	ADD?TCB	_RELAY, 030h, _temp_data + 00002h

; C:\REMOTE~1\PRIVATE\HARDWARE\MICROC~1\FINALO~1\SIMPLE~1.PBP	00175	            temp_data[3] = "|"
	ICALL?L	L00001
	MOVE?CB	07Ch, _temp_data + 00003h

; C:\REMOTE~1\PRIVATE\HARDWARE\MICROC~1\FINALO~1\SIMPLE~1.PBP	00176	            read 11, temp_data[4]
	ICALL?L	L00001
	READADDRESS?C	00Bh
	READ?B	_temp_data + 00004h

; C:\REMOTE~1\PRIVATE\HARDWARE\MICROC~1\FINALO~1\SIMPLE~1.PBP	00177	            temp_data[4] = temp_data[4] + $30        
	ICALL?L	L00001
	ADD?BCB	_temp_data + 00004h, 030h, _temp_data + 00004h

; C:\REMOTE~1\PRIVATE\HARDWARE\MICROC~1\FINALO~1\SIMPLE~1.PBP	00178	            temp_data[5] = "|"
	ICALL?L	L00001
	MOVE?CB	07Ch, _temp_data + 00005h

; C:\REMOTE~1\PRIVATE\HARDWARE\MICROC~1\FINALO~1\SIMPLE~1.PBP	00179	            read 12, temp_byte
	ICALL?L	L00001
	READADDRESS?C	00Ch
	READ?B	_temp_byte

; C:\REMOTE~1\PRIVATE\HARDWARE\MICROC~1\FINALO~1\SIMPLE~1.PBP	00180	            gosub convertNoToStr
	ICALL?L	L00001
	GOSUB?L	_convertNoToStr

; C:\REMOTE~1\PRIVATE\HARDWARE\MICROC~1\FINALO~1\SIMPLE~1.PBP	00181	            temp_data[6] = temp3_byte
	ICALL?L	L00001
	MOVE?BB	_temp3_byte, _temp_data + 00006h

; C:\REMOTE~1\PRIVATE\HARDWARE\MICROC~1\FINALO~1\SIMPLE~1.PBP	00182	            temp_data[7] = temp2_byte
	ICALL?L	L00001
	MOVE?BB	_temp2_byte, _temp_data + 00007h

; C:\REMOTE~1\PRIVATE\HARDWARE\MICROC~1\FINALO~1\SIMPLE~1.PBP	00183	            temp_data[8] = temp1_byte
	ICALL?L	L00001
	MOVE?BB	_temp1_byte, _temp_data + 00008h

; C:\REMOTE~1\PRIVATE\HARDWARE\MICROC~1\FINALO~1\SIMPLE~1.PBP	00184	            temp_data[9] = "|"
	ICALL?L	L00001
	MOVE?CB	07Ch, _temp_data + 00009h

; C:\REMOTE~1\PRIVATE\HARDWARE\MICROC~1\FINALO~1\SIMPLE~1.PBP	00185	            temp_byte = l1counter
	ICALL?L	L00001
	MOVE?BB	_l1counter, _temp_byte

; C:\REMOTE~1\PRIVATE\HARDWARE\MICROC~1\FINALO~1\SIMPLE~1.PBP	00186	            gosub convertNoToStr
	ICALL?L	L00001
	GOSUB?L	_convertNoToStr

; C:\REMOTE~1\PRIVATE\HARDWARE\MICROC~1\FINALO~1\SIMPLE~1.PBP	00187	            temp_data[10] = temp3_byte
	ICALL?L	L00001
	MOVE?BB	_temp3_byte, _temp_data + 0000Ah

; C:\REMOTE~1\PRIVATE\HARDWARE\MICROC~1\FINALO~1\SIMPLE~1.PBP	00188	            temp_data[11] = temp2_byte
	ICALL?L	L00001
	MOVE?BB	_temp2_byte, _temp_data + 0000Bh

; C:\REMOTE~1\PRIVATE\HARDWARE\MICROC~1\FINALO~1\SIMPLE~1.PBP	00189	            temp_data[12] = temp1_byte
	ICALL?L	L00001
	MOVE?BB	_temp1_byte, _temp_data + 0000Ch

; C:\REMOTE~1\PRIVATE\HARDWARE\MICROC~1\FINALO~1\SIMPLE~1.PBP	00190	            temp_data[13] = 13    
	ICALL?L	L00001
	MOVE?CB	00Dh, _temp_data + 0000Dh

; C:\REMOTE~1\PRIVATE\HARDWARE\MICROC~1\FINALO~1\SIMPLE~1.PBP	00191	            temp_data[14] = 10    
	ICALL?L	L00001
	MOVE?CB	00Ah, _temp_data + 0000Eh

; C:\REMOTE~1\PRIVATE\HARDWARE\MICROC~1\FINALO~1\SIMPLE~1.PBP	00192	    elseif (data_in[2] == "p") then
	ICALL?L	L00001
	GOTO?L	L00026
	LABEL?L	L00053	
	CMPNE?BCL	_data_in + 00002h, 070h, L00055

; C:\REMOTE~1\PRIVATE\HARDWARE\MICROC~1\FINALO~1\SIMPLE~1.PBP	00193	            if (data_in[3] == "n") then
	ICALL?L	L00001
	CMPNE?BCL	_data_in + 00003h, 06Eh, L00057

; C:\REMOTE~1\PRIVATE\HARDWARE\MICROC~1\FINALO~1\SIMPLE~1.PBP	00194	                gosub sendDataOK
	ICALL?L	L00001
	GOSUB?L	_sendDataOK

; C:\REMOTE~1\PRIVATE\HARDWARE\MICROC~1\FINALO~1\SIMPLE~1.PBP	00195	            endif
	ICALL?L	L00001
	LABEL?L	L00057	

; C:\REMOTE~1\PRIVATE\HARDWARE\MICROC~1\FINALO~1\SIMPLE~1.PBP	00196	    endif
	ICALL?L	L00001
	LABEL?L	L00026	
	LABEL?L	L00055	

; C:\REMOTE~1\PRIVATE\HARDWARE\MICROC~1\FINALO~1\SIMPLE~1.PBP	00197	    if (temp_data[0] == 0) then
	ICALL?L	L00001
	CMPNE?BCL	_temp_data, 000h, L00059

; C:\REMOTE~1\PRIVATE\HARDWARE\MICROC~1\FINALO~1\SIMPLE~1.PBP	00198	        temp_data[0] = "E"
	ICALL?L	L00001
	MOVE?CB	045h, _temp_data

; C:\REMOTE~1\PRIVATE\HARDWARE\MICROC~1\FINALO~1\SIMPLE~1.PBP	00199	        temp_data[1] = "R"
	ICALL?L	L00001
	MOVE?CB	052h, _temp_data + 00001h

; C:\REMOTE~1\PRIVATE\HARDWARE\MICROC~1\FINALO~1\SIMPLE~1.PBP	00200	        temp_data[2] = "R"
	ICALL?L	L00001
	MOVE?CB	052h, _temp_data + 00002h

; C:\REMOTE~1\PRIVATE\HARDWARE\MICROC~1\FINALO~1\SIMPLE~1.PBP	00201	        temp_data[3] = "O"
	ICALL?L	L00001
	MOVE?CB	04Fh, _temp_data + 00003h

; C:\REMOTE~1\PRIVATE\HARDWARE\MICROC~1\FINALO~1\SIMPLE~1.PBP	00202	        temp_data[4] = "R"
	ICALL?L	L00001
	MOVE?CB	052h, _temp_data + 00004h

; C:\REMOTE~1\PRIVATE\HARDWARE\MICROC~1\FINALO~1\SIMPLE~1.PBP	00203	        temp_data[5] = 13
	ICALL?L	L00001
	MOVE?CB	00Dh, _temp_data + 00005h

; C:\REMOTE~1\PRIVATE\HARDWARE\MICROC~1\FINALO~1\SIMPLE~1.PBP	00204	        temp_data[6] = 10
	ICALL?L	L00001
	MOVE?CB	00Ah, _temp_data + 00006h

; C:\REMOTE~1\PRIVATE\HARDWARE\MICROC~1\FINALO~1\SIMPLE~1.PBP	00205	    endif
	ICALL?L	L00001
	LABEL?L	L00059	

; C:\REMOTE~1\PRIVATE\HARDWARE\MICROC~1\FINALO~1\SIMPLE~1.PBP	00206	endif
	ICALL?L	L00001
	LABEL?L	L00023	

; C:\REMOTE~1\PRIVATE\HARDWARE\MICROC~1\FINALO~1\SIMPLE~1.PBP	00208	data_out[0]=Fifo_status 'Read FIFO status
	ICALL?L	L00001
	MOVE?CB	_Fifo_status, _data_out

; C:\REMOTE~1\PRIVATE\HARDWARE\MICROC~1\FINALO~1\SIMPLE~1.PBP	00209	num_byte=1
	ICALL?L	L00001
	MOVE?CB	001h, _num_byte

; C:\REMOTE~1\PRIVATE\HARDWARE\MICROC~1\FINALO~1\SIMPLE~1.PBP	00210	gosub spi_read
	ICALL?L	L00001
	GOSUB?L	_spi_read

; C:\REMOTE~1\PRIVATE\HARDWARE\MICROC~1\FINALO~1\SIMPLE~1.PBP	00211	val= data_in[1] 'FIFO status register
	ICALL?L	L00001
	MOVE?BB	_data_in + 00001h, _val

; C:\REMOTE~1\PRIVATE\HARDWARE\MICROC~1\FINALO~1\SIMPLE~1.PBP	00212	if val.0=0 then lop 'test RX_EMPTY=1, RX_FIFO empty
	ICALL?L	L00001
	CMPEQ?TCL	_val??0, 000h, _lop

; C:\REMOTE~1\PRIVATE\HARDWARE\MICROC~1\FINALO~1\SIMPLE~1.PBP	00213	data_out[0]=Write_reg+Stat_us 'reset RX_DR status bit
	ICALL?L	L00001
	MOVE?CB	027h, _data_out

; C:\REMOTE~1\PRIVATE\HARDWARE\MICROC~1\FINALO~1\SIMPLE~1.PBP	00214	data_out[1]=%01000000 'write 1 tp RX_DR to reset IRQ
	ICALL?L	L00001
	MOVE?CB	040h, _data_out + 00001h

; C:\REMOTE~1\PRIVATE\HARDWARE\MICROC~1\FINALO~1\SIMPLE~1.PBP	00215	num_byte=1
	ICALL?L	L00001
	MOVE?CB	001h, _num_byte

; C:\REMOTE~1\PRIVATE\HARDWARE\MICROC~1\FINALO~1\SIMPLE~1.PBP	00216	gosub spi_write
	ICALL?L	L00001
	GOSUB?L	_spi_write

; C:\REMOTE~1\PRIVATE\HARDWARE\MICROC~1\FINALO~1\SIMPLE~1.PBP	00217	pause 2 'wait 2ms Rx<->Tx
	ICALL?L	L00001
	PAUSE?C	002h

; C:\REMOTE~1\PRIVATE\HARDWARE\MICROC~1\FINALO~1\SIMPLE~1.PBP	00218	GOTO Main_rx
	ICALL?L	L00001
	GOTO?L	_Main_rx

; C:\REMOTE~1\PRIVATE\HARDWARE\MICROC~1\FINALO~1\SIMPLE~1.PBP	00219	end
	ICALL?L	L00001
	END?	

; C:\REMOTE~1\PRIVATE\HARDWARE\MICROC~1\FINALO~1\SIMPLE~1.PBP	00221	disable
	DISABLE?	

; C:\REMOTE~1\PRIVATE\HARDWARE\MICROC~1\FINALO~1\SIMPLE~1.PBP	00222	intManagement:

	LABEL?L	_intManagement	

; C:\REMOTE~1\PRIVATE\HARDWARE\MICROC~1\FINALO~1\SIMPLE~1.PBP	00223	        if (INTCON.2 == 1) then
	CMPNE?TCL	_INTCON??2, 001h, L00061

; C:\REMOTE~1\PRIVATE\HARDWARE\MICROC~1\FINALO~1\SIMPLE~1.PBP	00224	           ticks = ticks + 1      ' Count pieces of seconds
	ADD?WCW	_ticks, 001h, _ticks

; C:\REMOTE~1\PRIVATE\HARDWARE\MICROC~1\FINALO~1\SIMPLE~1.PBP	00225	           If ticks < 31 Then tiexit
	CMPLT?WCL	_ticks, 01Fh, _tiexit

; C:\REMOTE~1\PRIVATE\HARDWARE\MICROC~1\FINALO~1\SIMPLE~1.PBP	00226	           ticks = 0
	MOVE?CW	000h, _ticks

; C:\REMOTE~1\PRIVATE\HARDWARE\MICROC~1\FINALO~1\SIMPLE~1.PBP	00227	           seconds = seconds + 1
	ADD?BCB	_seconds, 001h, _seconds

; C:\REMOTE~1\PRIVATE\HARDWARE\MICROC~1\FINALO~1\SIMPLE~1.PBP	00228	           if seconds < 59 then tiexit
	CMPLT?BCL	_seconds, 03Bh, _tiexit

; C:\REMOTE~1\PRIVATE\HARDWARE\MICROC~1\FINALO~1\SIMPLE~1.PBP	00229	           seconds = 0
	MOVE?CB	000h, _seconds

; C:\REMOTE~1\PRIVATE\HARDWARE\MICROC~1\FINALO~1\SIMPLE~1.PBP	00230	           if (l1counter > 0) then
	CMPLE?BCL	_l1counter, 000h, L00063

; C:\REMOTE~1\PRIVATE\HARDWARE\MICROC~1\FINALO~1\SIMPLE~1.PBP	00231	               l1counter = l1counter - 1
	SUB?BCB	_l1counter, 001h, _l1counter

; C:\REMOTE~1\PRIVATE\HARDWARE\MICROC~1\FINALO~1\SIMPLE~1.PBP	00232	               if (l1counter == 0) then
	CMPNE?BCL	_l1counter, 000h, L00065

; C:\REMOTE~1\PRIVATE\HARDWARE\MICROC~1\FINALO~1\SIMPLE~1.PBP	00233	                    low relay
	LOW?T	_RELAY

; C:\REMOTE~1\PRIVATE\HARDWARE\MICROC~1\FINALO~1\SIMPLE~1.PBP	00234	               endif
	LABEL?L	L00065	

; C:\REMOTE~1\PRIVATE\HARDWARE\MICROC~1\FINALO~1\SIMPLE~1.PBP	00235	           endif           
	LABEL?L	L00063	

; C:\REMOTE~1\PRIVATE\HARDWARE\MICROC~1\FINALO~1\SIMPLE~1.PBP	00236	           tiexit:

	LABEL?L	_tiexit	

; C:\REMOTE~1\PRIVATE\HARDWARE\MICROC~1\FINALO~1\SIMPLE~1.PBP	00237	           INTCON.2 = 0 
	MOVE?CT	000h, _INTCON??2

; C:\REMOTE~1\PRIVATE\HARDWARE\MICROC~1\FINALO~1\SIMPLE~1.PBP	00238	        endif
	LABEL?L	L00061	

; C:\REMOTE~1\PRIVATE\HARDWARE\MICROC~1\FINALO~1\SIMPLE~1.PBP	00239	        INTCON.7 = 1
	MOVE?CT	001h, _INTCON??7

; C:\REMOTE~1\PRIVATE\HARDWARE\MICROC~1\FINALO~1\SIMPLE~1.PBP	00240	resume
	RESUME?	

; C:\REMOTE~1\PRIVATE\HARDWARE\MICROC~1\FINALO~1\SIMPLE~1.PBP	00241	enable
	ENABLE?	

; C:\REMOTE~1\PRIVATE\HARDWARE\MICROC~1\FINALO~1\SIMPLE~1.PBP	00243	sendDataOK:

	LABEL?L	_sendDataOK	

; C:\REMOTE~1\PRIVATE\HARDWARE\MICROC~1\FINALO~1\SIMPLE~1.PBP	00244	    temp_data[0] = "O"
	ICALL?L	L00001
	MOVE?CB	04Fh, _temp_data

; C:\REMOTE~1\PRIVATE\HARDWARE\MICROC~1\FINALO~1\SIMPLE~1.PBP	00245	    temp_data[1] = "K"
	ICALL?L	L00001
	MOVE?CB	04Bh, _temp_data + 00001h

; C:\REMOTE~1\PRIVATE\HARDWARE\MICROC~1\FINALO~1\SIMPLE~1.PBP	00246	    temp_data[2] = 13
	ICALL?L	L00001
	MOVE?CB	00Dh, _temp_data + 00002h

; C:\REMOTE~1\PRIVATE\HARDWARE\MICROC~1\FINALO~1\SIMPLE~1.PBP	00247	    temp_data[3] = 10
	ICALL?L	L00001
	MOVE?CB	00Ah, _temp_data + 00003h

; C:\REMOTE~1\PRIVATE\HARDWARE\MICROC~1\FINALO~1\SIMPLE~1.PBP	00248	return
	ICALL?L	L00001
	RETURN?	

; C:\REMOTE~1\PRIVATE\HARDWARE\MICROC~1\FINALO~1\SIMPLE~1.PBP	00250	convertInputData:

	LABEL?L	_convertInputData	

; C:\REMOTE~1\PRIVATE\HARDWARE\MICROC~1\FINALO~1\SIMPLE~1.PBP	00251	    conversionSuccess = 0
	ICALL?L	L00001
	MOVE?CB	000h, _conversionSuccess

; C:\REMOTE~1\PRIVATE\HARDWARE\MICROC~1\FINALO~1\SIMPLE~1.PBP	00252	    TEMP_BYTE="a"
	ICALL?L	L00001
	MOVE?CB	061h, _temp_byte

; C:\REMOTE~1\PRIVATE\HARDWARE\MICROC~1\FINALO~1\SIMPLE~1.PBP	00253	    for ci=0 to 2    
	ICALL?L	L00001
	MOVE?CB	000h, _ci
	LABEL?L	L00067	
	CMPGT?BCL	_ci, 002h, L00068

; C:\REMOTE~1\PRIVATE\HARDWARE\MICROC~1\FINALO~1\SIMPLE~1.PBP	00254	        TEMP1_BYTE = "a"
	ICALL?L	L00001
	MOVE?CB	061h, _temp1_byte

; C:\REMOTE~1\PRIVATE\HARDWARE\MICROC~1\FINALO~1\SIMPLE~1.PBP	00255	        TEMP2_BYTE = data_in[i]
	ICALL?L	L00001
	AOUT?BBB	_data_in, _i, _temp2_byte

; C:\REMOTE~1\PRIVATE\HARDWARE\MICROC~1\FINALO~1\SIMPLE~1.PBP	00256	        if (TEMP2_BYTE == "|") then return
	ICALL?L	L00001
	CMPNE?BCL	_temp2_byte, 07Ch, L00069
	RETURN?	
	LABEL?L	L00069	

; C:\REMOTE~1\PRIVATE\HARDWARE\MICROC~1\FINALO~1\SIMPLE~1.PBP	00257	        GOSUB lookupChar
	ICALL?L	L00001
	GOSUB?L	_lookupChar

; C:\REMOTE~1\PRIVATE\HARDWARE\MICROC~1\FINALO~1\SIMPLE~1.PBP	00258	        if (TEMP1_BYTE == "a") then return 
	ICALL?L	L00001
	CMPNE?BCL	_temp1_byte, 061h, L00071
	RETURN?	
	LABEL?L	L00071	

; C:\REMOTE~1\PRIVATE\HARDWARE\MICROC~1\FINALO~1\SIMPLE~1.PBP	00259	        if (ci==0) then 
	ICALL?L	L00001
	CMPNE?BCL	_ci, 000h, L00073

; C:\REMOTE~1\PRIVATE\HARDWARE\MICROC~1\FINALO~1\SIMPLE~1.PBP	00260	            TEMP_BYTE = TEMP1_BYTE
	ICALL?L	L00001
	MOVE?BB	_temp1_byte, _temp_byte

; C:\REMOTE~1\PRIVATE\HARDWARE\MICROC~1\FINALO~1\SIMPLE~1.PBP	00261	            conversionSuccess = 1 
	ICALL?L	L00001
	MOVE?CB	001h, _conversionSuccess

; C:\REMOTE~1\PRIVATE\HARDWARE\MICROC~1\FINALO~1\SIMPLE~1.PBP	00262	        else 
	ICALL?L	L00001
	GOTO?L	L00074
	LABEL?L	L00073	

; C:\REMOTE~1\PRIVATE\HARDWARE\MICROC~1\FINALO~1\SIMPLE~1.PBP	00263	            TEMP_BYTE = TEMP_BYTE*10 + TEMP1_BYTE
	ICALL?L	L00001
	MUL?BCW	_temp_byte, 00Ah, T1
	ADD?WBB	T1, _temp1_byte, _temp_byte

; C:\REMOTE~1\PRIVATE\HARDWARE\MICROC~1\FINALO~1\SIMPLE~1.PBP	00264	            conversionSuccess = 1
	ICALL?L	L00001
	MOVE?CB	001h, _conversionSuccess

; C:\REMOTE~1\PRIVATE\HARDWARE\MICROC~1\FINALO~1\SIMPLE~1.PBP	00265	        endif
	ICALL?L	L00001
	LABEL?L	L00074	

; C:\REMOTE~1\PRIVATE\HARDWARE\MICROC~1\FINALO~1\SIMPLE~1.PBP	00266	        i = i + 1
	ICALL?L	L00001
	ADD?BCB	_i, 001h, _i

; C:\REMOTE~1\PRIVATE\HARDWARE\MICROC~1\FINALO~1\SIMPLE~1.PBP	00267	    next ci
	ICALL?L	L00001
	NEXT?BCL	_ci, 001h, L00067
	LABEL?L	L00068	

; C:\REMOTE~1\PRIVATE\HARDWARE\MICROC~1\FINALO~1\SIMPLE~1.PBP	00268	return
	ICALL?L	L00001
	RETURN?	

; C:\REMOTE~1\PRIVATE\HARDWARE\MICROC~1\FINALO~1\SIMPLE~1.PBP	00270	lookupChar:

	LABEL?L	_lookupChar	

; C:\REMOTE~1\PRIVATE\HARDWARE\MICROC~1\FINALO~1\SIMPLE~1.PBP	00271	    LOOKDOWN temp2_byte,["0123456789"], temp1_byte
	ICALL?L	L00001
	LOOKDOWN?BCLB	_temp2_byte, 00Ah, L00002, _temp1_byte
	LDRET?C	030h
	LDRET?C	031h
	LDRET?C	032h
	LDRET?C	033h
	LDRET?C	034h
	LDRET?C	035h
	LDRET?C	036h
	LDRET?C	037h
	LDRET?C	038h
	LDRET?C	039h

	LABEL?L	L00002	

; C:\REMOTE~1\PRIVATE\HARDWARE\MICROC~1\FINALO~1\SIMPLE~1.PBP	00272	RETURN
	ICALL?L	L00001
	RETURN?	

; C:\REMOTE~1\PRIVATE\HARDWARE\MICROC~1\FINALO~1\SIMPLE~1.PBP	00274	convertNoToStr:

	LABEL?L	_convertNoToStr	

; C:\REMOTE~1\PRIVATE\HARDWARE\MICROC~1\FINALO~1\SIMPLE~1.PBP	00275	        temp3_byte = (temp_byte DIG 2) + $30
	ICALL?L	L00001
	DIG?BCW	_temp_byte, 002h, T1
	ADD?WCB	T1, 030h, _temp3_byte

; C:\REMOTE~1\PRIVATE\HARDWARE\MICROC~1\FINALO~1\SIMPLE~1.PBP	00276	        temp2_byte = (temp_byte DIG 1) + $30
	ICALL?L	L00001
	DIG?BCW	_temp_byte, 001h, T1
	ADD?WCB	T1, 030h, _temp2_byte

; C:\REMOTE~1\PRIVATE\HARDWARE\MICROC~1\FINALO~1\SIMPLE~1.PBP	00277	        temp1_byte = (temp_byte DIG 0) + $30
	ICALL?L	L00001
	DIG?BCW	_temp_byte, 000h, T1
	ADD?WCB	T1, 030h, _temp1_byte

; C:\REMOTE~1\PRIVATE\HARDWARE\MICROC~1\FINALO~1\SIMPLE~1.PBP	00278	return
	ICALL?L	L00001
	RETURN?	

; C:\REMOTE~1\PRIVATE\HARDWARE\MICROC~1\FINALO~1\SIMPLE~1.PBP	00280	setRxAddressPipe:

	LABEL?L	_setRxAddressPipe	

; C:\REMOTE~1\PRIVATE\HARDWARE\MICROC~1\FINALO~1\SIMPLE~1.PBP	00281	READ 6, data_out[1]
	ICALL?L	L00001
	READADDRESS?C	006h
	READ?B	_data_out + 00001h

; C:\REMOTE~1\PRIVATE\HARDWARE\MICROC~1\FINALO~1\SIMPLE~1.PBP	00282	READ 7, data_out[2]
	ICALL?L	L00001
	READADDRESS?C	007h
	READ?B	_data_out + 00002h

; C:\REMOTE~1\PRIVATE\HARDWARE\MICROC~1\FINALO~1\SIMPLE~1.PBP	00283	READ 8, data_out[3]
	ICALL?L	L00001
	READADDRESS?C	008h
	READ?B	_data_out + 00003h

; C:\REMOTE~1\PRIVATE\HARDWARE\MICROC~1\FINALO~1\SIMPLE~1.PBP	00284	READ 9, data_out[4]
	ICALL?L	L00001
	READADDRESS?C	009h
	READ?B	_data_out + 00004h

; C:\REMOTE~1\PRIVATE\HARDWARE\MICROC~1\FINALO~1\SIMPLE~1.PBP	00285	data_out[5] = device_id
	ICALL?L	L00001
	MOVE?BB	_device_id, _data_out + 00005h

; C:\REMOTE~1\PRIVATE\HARDWARE\MICROC~1\FINALO~1\SIMPLE~1.PBP	00286	return
	ICALL?L	L00001
	RETURN?	

; C:\REMOTE~1\PRIVATE\HARDWARE\MICROC~1\FINALO~1\SIMPLE~1.PBP	00288	setTxAddressPipe:

	LABEL?L	_setTxAddressPipe	

; C:\REMOTE~1\PRIVATE\HARDWARE\MICROC~1\FINALO~1\SIMPLE~1.PBP	00289	READ 1, data_out[1]
	ICALL?L	L00001
	READADDRESS?C	001h
	READ?B	_data_out + 00001h

; C:\REMOTE~1\PRIVATE\HARDWARE\MICROC~1\FINALO~1\SIMPLE~1.PBP	00290	READ 2, data_out[2]
	ICALL?L	L00001
	READADDRESS?C	002h
	READ?B	_data_out + 00002h

; C:\REMOTE~1\PRIVATE\HARDWARE\MICROC~1\FINALO~1\SIMPLE~1.PBP	00291	READ 3, data_out[3]
	ICALL?L	L00001
	READADDRESS?C	003h
	READ?B	_data_out + 00003h

; C:\REMOTE~1\PRIVATE\HARDWARE\MICROC~1\FINALO~1\SIMPLE~1.PBP	00292	READ 4, data_out[4]
	ICALL?L	L00001
	READADDRESS?C	004h
	READ?B	_data_out + 00004h

; C:\REMOTE~1\PRIVATE\HARDWARE\MICROC~1\FINALO~1\SIMPLE~1.PBP	00293	READ 5, data_out[5]
	ICALL?L	L00001
	READADDRESS?C	005h
	READ?B	_data_out + 00005h

; C:\REMOTE~1\PRIVATE\HARDWARE\MICROC~1\FINALO~1\SIMPLE~1.PBP	00294	return
	ICALL?L	L00001
	RETURN?	

	END
