robertgregor/private/(commit log)

2012-11-22 HeatingHeader finished
2012-11-23 fixed bugs in displaying valve status
2012-12-04 1 st version
    [spinac.brd, spinac.sch]
2012-12-05 1st version
    [raspi.brd, raspi.sch]
2013-01-15 Latest final designs
    [heatingHeader.brd, heatingHeader.sch, pc.brd, pc.sch, raspi.brd, raspi.sch, spinac.brd, spinac.sch]
2013-01-15 deleted final designs
    [heatingHeader.brd, heatingHeader.sch, pc.brd, pc.sch, raspi.brd, raspi.sch, spinac.brd, spinac.sch]
2013-01-28 added support for remote IR detector
    [tempSensor.brd, tempSensor.sch]
2013-02-06 add switch tact
2013-03-14 New version
    [spinac.brd, spinac.sch]
2013-04-18 fixed power supply 22 uF C3 and differend FW diode
    [spinac.brd, spinac.sch]
2013-05-12 oprava bugu: http://manager.remote-home.org/issues/19
    [rolety.brd]
2013-08-08 Light alarm device - new look an field
2013-08-20 fixed null pointer when start the brand new persistence without history sample.
    [MotorControllerDevice.java]
2013-09-24 change in the layout
    [tempSensorAAABat.brd]
2013-10-01 fixed bug.
    [6relayBoard.brd]
2013-10-01 fixed bug
    [6relayBoard.brd]
2014-12-24 abcd
    abcd
    [8RelaySwitch.brd, 8RelaySwitch.sch, ChangeOverSwitch.brd, ChangeOverSwitch.sch, DoubleSwitch.brd, DoubleSwitch.sch, Moteino.brd, Moteino.sch]
